VovaRodger/Robo/Научно-исследовательская часть/робот3.jpg

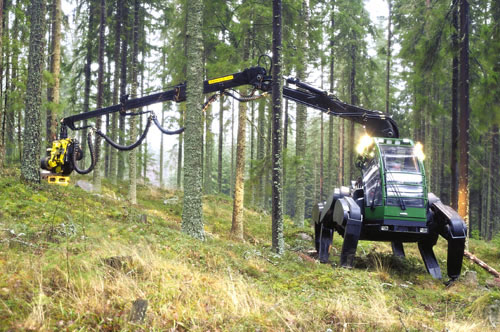
Научно-исследовательская часть/робот3.jpg
