VovaRodger/Robo/Научно-исследовательская часть/робот5.jpg

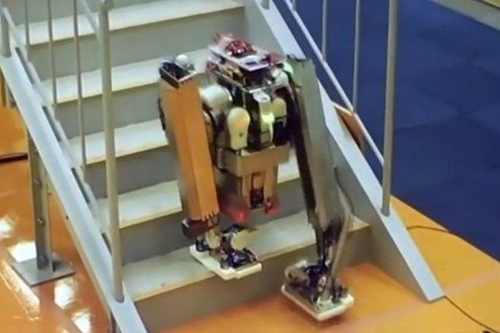
Научно-исследовательская часть/робот5.jpg
