VovaRodger/Robo/Научно-исследовательская часть/!Научно-исследовательская часть.docx

# Введение

В настоящее время практически во всех промышленно развитых странах интенсивно ведутся работы по созданию и исследованию шагающих роботов. Это вызвано тем, что шагающие машины (см. рис. 1) по сравнению с традиционными колёсными и гусеничными машинами имеют ряд преимуществ перед традиционными транспортными средствами при движении по поверхности со сложным рельефом, такими как пресечённая местность, завалы, а также внутри зданий и сооружений, где необходимо перемещаться по лестницам и узким коридорам и шахтам.


а. | б.


в. | г.

Рис. 1. Шагающие машины в разных областях.

В случаях, когда желательно или необходимо, чтобы след от опор целевой мобильной платформы имел дискретный характер, достойную замену шагающей машине найти невозможно. Шагающий аппарат при движении использует для опоры лишь некоторые точки на поверхности в отличие от колесных и гусеничных машин, имеющих непрерывную колею. Кроме того, шагающий аппарат существенно меньше повреждает почвенный покров, что может оказаться важным для некоторых районов.

Хотя колесные транспортные средства в настоящее время явно преобладают, известно, что при ходьбе по неподготовленной поверхности существенные преимущества имеют шагающие системы передвижения. Однако указанные преимущества шагающего аппарата определяют его высокую сложность. Система управления должна обеспечить переработку информации о местности, принятие решений о характере движения, контроль за их реализацией. Именно создание системы управления аппаратом – центральная проблема шагающего робота, так как опыт создания даже самых сложных систем автоматического управления невозможно непосредственно использовать для построения системы управления шагающим роботом.

# 1. Техническое задание

1. Произвести энергетический расчет трехзвенного манипулятора с 3-мя степенями свободы для шестиногого робота. Рассчитать и подобрать двигатели для каждого звена ноги.
2. Произвести частотный синтез и коррекцию следящего привода трехзвенного манипулятора с 3-мя степенями свободы для обеспечения следующих характеристик:
- Длительность переходного процесса t_(пп) ≤0.1 сек;
- Перерегулирование σ≤30% ;
- Ошибка вращения элемента ε≤0.5° ;
3. Решить обратную кинематическую задачу (ОКЗ) для трехзвенного манипулятора с 3-мя степенями свободы.
4. Проанализировать алгоритмы поиска кратчайшего пути.
5. Реализовать прохождение кратчайшего пути по заданной карте местности.
6. Провести натурный эксперимент и определить ошибки в прохождении заданной траектории.
7. Разработать плату стабилизации напряжения.
8. Разработать технологический процесс сборки ноги шестиногого шагающего робота.
9. Рассчитать затраты на проектирование и изготовление шестиногого шагающего робота.
10. Проанализировать опасные и вредные факторы при разработке системы управления шестиногим шагающим роботом.
11. Устранить самый опасный фактор, влияющий на персонал, при разработке системы управления шестиногим шагающим роботом.
12. Проанализировать влияние на окружающую среду технологического процесса сборки печатной платы для системы управления шестиногим шагающим роботом.
13. Устранить самый опасный фактор, влияющий на окружающую среду, при сборке печатной платы для системы управления шестиногим шагающим роботом.

# 2. Научно-исследовательская часть

Проанализируем преимущества и недостатки шагающих роботов и поставим задачи, которые необходимо решить в рамках данного дипломного проекта.

Как было описано во введении, шагающие роботы, по сравнению с колесными и гусеничными машинами, имеют ряд очевидных преимуществ и недостатков.

Из преимуществ выделим:

- система имеет дискретные точки опоры;
- маневренность в узких пространствах;
- проходимость;

Из недостатков:

- малые скорости перемещения;
- присутствие энергозатрат на удержание в горизонтальной плоскости;
- сложность реализации движения;

Имея шесть ног, перемещение в пространстве можно осуществлять с помощью нескольких вариантов волновых (периодических) походок, основным отличием которых является число ног в фазе опоры/переноса. Самой простой для понимания и реализации является походка «трешками», при которой в фазе опоры всегда находятся три ноги, а три другие в фазе переноса.

Так как создание системы управления роботом – это центральная проблема шагающего робота, решим эту проблему, реализовав походку «трешками». А так же решим проблему перемещения – а именно поиск кратчайшего пути по заданной карте местности с помощью волнового алгоритма Ли.

Для реализации поставленной задачи был выбран робот, представленный на рисунке 2.1.


Рис. 2.1. Шестиногий шагающий робот

Выбранный робот сделан из легкого акрилового стекла, оснащён ультразвуковым дальномером, девятнадцатью сервоприводами (18 на конечностях и один на ультразвуковом дальномере), полностью готовой к работе плате Servator32, основанной на Arduino.

# 2.1. Энергетический расчет следящего привода

Энергетический расчет будем проводить для одной ноги (см. рис. 2.2), приняв следующие ограничения и допущения:

- Ногу робота примем за 3х-звенный манипулятор с 3-мя степенями свободы;
- Нагрузкой является каркас (тело робота, к которому крепятся ноги), масса которого сосредоточена в точке и закреплена на конце манипулятора;
- Расчет будем вести от последнего звена, установленного на землю;
- Допускаем, что робот стоит абсолютно жестко, и не проскальзывает в точке контакта ноги с поверхностью опоры;
- Рассматриваем наихудший вариант, т.е. когда нога абсолютно выпрямлена. В этом случае на сочленения действуют самые большие силы и моменты;


Рис. 2.2. Чертеж ноги робота

Расчет моментов инерции звеньев, приведенных к оси вращения.

Твёрдый параллелепипед с высотой h, шириной a, глубиной b (см. рис. 2.3 и рис. 2.4) и массой m имеет следующие осевые моменты инерции, приведенные к центру одной из граней:

I_h =1/12∙m∙(a^2 +b^2 )

I_a =1/12∙m∙(h^2 +b^2 )

I_b =1/12∙m∙(a^2 +h^2 )

Теорема Гюйгенса — Штейнера [4].

Момент инерции твёрдого тела относительно какой-либо оси зависит от массы, формы и размеров тела, а также и от положения тела по отношению к этой оси. Согласно теореме Штейнера (теореме Гюйгенса-Штейнера), момент инерции тела I относительно произвольной оси равен сумме момента инерции этого тела I_c относительно оси, проходящей через центр масс тела параллельно рассматриваемой оси, и произведения массы тела m на квадрат расстояния d между осями:

I=I_c +m∙d^2 ,

где m — полная масса тела.

Момент инерции плеча (см. рис. 2.3)

I=I_h +m∙d^2


Рис. 2.3. Схема момента инерции плеча

Момент инерции предплечья и кисти (см. рис. 2.4)

I=I_а +m∙d^2


Рис. 2.4. Схема моментов инерции предплечья и кисти

№ | m_i , кг | a,мм | b,мм | d,мм | h,мм
1 | 0.030 | 50 | 45 | 10 | 35
2 | 0.030 | 30 | 70 | 25 | 17
3 | 0.030 | 53 | 60 | 27 | 10

Табл. 2.1. Начальные условия для расчетов

Начальные условия для расчетов приведены в таблице 2.1.

Расчет момента инерции для плеча:

I_h =1/12∙m_1 ∙(a^2 +b^2 )

I=I_h +m_1 ∙d^2 =1/12∙m_1 ∙(a^2 +b^2 )+ m_1 ∙d^2 =

1/12∙0.03∙(0.05^2 +0.045^2 )+0.03∙0.01^2 =2.385∙10^(-5) кг∙м^2

Расчет момента инерции для предплечья:

I_a =1/12∙m_2 ∙(h^2 +b^2 )

I=I_a +m_2 ∙d^2 =1/12∙m_2 ∙(h^2 +b^2 )+m_2 ∙d^2 =

1/12∙0.03∙(0.017^2 +0.07^2 )+0.03∙0.025^2 =5.287∙10^(-5) кг∙м^2

Расчет момента инерции для кисти:

I_a =1/12∙m_3 ∙(h^2 +b^2 )

I=I_a +m_3 ∙d^2 =1/12∙m_3 ∙(h^2 +b^2 )+m_3 ∙d^2 =

1/12∙0.03∙(0.01^2 +0.06^2 )+0.03∙0.027^2 =5.187∙10^(-5) кг∙м^2

Полученные данные сведены в таблицу 2.2.

№ | Привод | m_i , кг | l_i ,м | ρ_i , м | J_i ∙10^(-5) , кг∙м^2 | φ_(Pi) , рад/с | φ_(Pi) , рад/с^2 | ∆,мм | m, кг
1 | Плеча | 0.030 | 0.026 | 0.013 | 2.385 | 2.5 | 5.0 | 0 | 0,125
2 | Локтя | 0.030 | 0.050 | 0.025 | 5.287 | 2.5 | 5.0 | 0 | 0,125
3 | Кисти | 0.030 | 0.054 | 0.027 | 5.187 | 2.5 | 5.0 | 0 | 0,125

Табл. 2.2. Начальные условия для расчетов

Используемые обозначения в таблице 2.2:

m_1 m_2 , m_3 , кг- массы звеньев;

l_1 ,l_2 ,l_3 ,м- длины звеньев;

ρ_1 ,ρ_2 ,ρ_3 , м- радиусы инерции звеньев ( ρ_i =(l_i)/2 );

J_1 ,J_2 ,J_3 , кг∙м^2 - моменты инерции звеньев, приведенные к осям вращения;

φ_P ,(рад)/с; φ_P ,(рад)/(с^2) – рабочие угловые скорости и ускорения звеньев;

∆,мм- максимально допустимая ошибка копирования;

m, кг - масса груза (объекта манипулирования; в роли объекта выступает платформа гексапода);

Энергетический расчет ЭМП плеча в I приближении.

Расчет Jп MAX Mп MAX

J_(п MAX) =m∙l_1 ^2 +J_1 +m_1 ∙ρ_1 ^2 =

=0.125∙0.026^2 +2.385∙10^(-5) +0.03∙0.013^2 =0.113∙10^(-3) кг∙м^2

M_(п MAX) =m∙g∙l_1 +m_1 ∙g∙ρ_1 =

=0.125∙9.806∙0.026+0.03∙9.806∙0.013=0.036 Н∙м

Расчет механической части ЭМП с объектом управления (ОУ)

Требуемые скорости и ускорения:

φ_(pп) =2.5(рад)/с;φ_(pп) =5(рад)/(с^2)

Расчет наибольшего значения требуемого момента на валу ОУ

М_Т =J_(п MAX) ∙φ_(pп) +M_(п MAX) =

=0.113∙10^(-3) ∙5+0.036 =0.037 Н∙м

Расчет эквивалентной скорости движения ОУ

Примем предварительно τ_(Ωд) =0.05 с

Ω_Э =τ_(Ωд) φ_(pк) +φ_(pк) =0.05с∙5+2.5=2.75(рад)/с

Расчет граничного значения максимальной требуемой мощности

Для данного расчета зададимся значениями КПД редуктора прямого и обратного хода: η_(пх) =η_(ох) =0.8

P_m =(Ω_Э ∙М_Т)/(η_(пх))=(2.75∙0.037)/0.8=0.127 Вт

Расчет ориентировочного значения требуемой номинальной мощности двигателя кисти

Для расчета ориентировочного значения требуемой номинальной мощности двигателя кисти необходимо определить теоретическую кратность пускового момента. Для этого достаточно принять P_(max) =P_m =0.127 Вт

Так номинальную мощность двигателя получим из соображений:

P_(ДН) ={, (P_(max))/2.5=0.051 Вт, для двигателей с жесткой , механической характеристикой λ_(КД) =8..14;, (P_(max))/1.5=0.085 Вт, для двигателей с мягкой , механической характеристикой λ_(КД) =2..7.

λ_(КД) - коэффициент кратности пускового момента двигателя.

P_(ДН1) =0.051 Вт; P_(ДН2) =0.085 Вт

Выбор двигателя по номинальной мощности с учетом жесткости механической характеристики из таблиц ДПТ

Выбираем по результатам расчетов I приближения ДПТ TowerPro SG92R (см. табл. 2.3)

U_(дн) , В | P_н ,Вт | n_н , об/мин | R_Я ,Ом | i_(дв н) ,А | J_p ∙ 10^(-6) , кг∙м^2 | m_(дв) , кг | λ_(КД)
6±1 | 0.675 | 600 | 13 | 0.250 | 0.575 | 0.009 | 11

Табл. 2.3. Технические характеристики TowerPro SG92R

P_н =0.675 Вт >0.051 Вт= P_(ДН1) , по мощности двигатель выбран верно

Выполним пересчет параметров для выбранного двигателя.

Номинальная угловая скорость: Ω_(ДН) =(π∙n_н)/30=(3.142∙600)/30=62.84(рад)/с

Номинальный момент двигателя:

М_(дв н) =(P_н)/(Ω_(ДН))=0.675/62.84=1.074∙10 ^(-2) Н∙м

Коэффициент момента K_М =(М_(дв н))/(i_(д н))=(1.074∙10 ^(-2))/0.25=4.296∙10 ^(-2) Н∙м / А

Коэффициент противо ЭДС K_Ω =(U_(дн) -R_Я i_(дв н))/(Ω_(ДН))=(6-13∙0.25)/62.84=4.376∙10 ^(-2) (В∙с)/(рад)

Выбор усилителя мощности (УМ), расчет его внутреннего сопротивления, вычисление сопротивления якорной цепи УМ-двигатель

R_д =R_(УМ) +R_Я , где

R_д - действующее сопротивление цепи УМ – ЭД, Ом;

R_(УМ) - выходное сопротивление усилителя мощности, Ом;

R_Я - сопротивление обмотки якоря, Ом.

Выбираем транзисторный УМ ( R_(УМ) =0;R_д =R_Я ). Необходимо назначить коэффициенты форсирования (КФ)

В силу естественного насыщения УМ по выходному напряжению, ЭД присуще ограничение по управляющему напряжению (скорости вращения):

U_(max) =λ_(СК М) ∙U_(дн) , где

λ_(СК М) - максимальный КФ по напряжению (для транзисторных УМ λ_(СК М) =1 )

Для получения запаса по управляющему напряжению в расчет принимается допустимое значение управляющего напряжения U_(Яд) :

λ_(СК) <λ_(СК М) ; λ_(СК) =0.9-КФ в рабочем режиме

U_(Яд) =λ_(СК) ∙U_(дн) =0.9∙6 В=5.4 В

Для ЭД характерно естественное насыщение по электромагнитному моменту:

М_(дв max) =λ_(ММ) ∙М_(дв н) , где

λ_(ММ) - максимальный КФ по моменту (току) (назначаем λ_(ММ) =4 )

М_(дв max) =4∙1.074∙10 ^(-2) =4.296∙10 ^(-2) Н∙м

Допустимый момент двигателя:

М_(дд) =λ_М ∙М_(дв н) , где

λ_М - КФ двигателя в рабочем режиме (назначаем λ_М =2 )

М_(дд) =λ_М ∙М_(дв н) =2∙1.074∙10 ^(-2) =2.148∙10 ^(-2) Н∙м

Расчет передаточного отношения редуктора в первом приближении

i=(λ_(СК) Ω_(ДН))/α=(0.9∙62.84)/2.5=22.622≅23

Требуемый момент на валу двигателя:

М'_Т =(М_Т)/(i∙η)=0.037/(23∙0.8)=2.011∙10 ^(-3) Н∙м

Требуемый момент, при котором обеспечивается заданное движение ОУ:

М_(ТД) =J_p iφ_(pк) +М^(') _Т =0.575∙10^(-6) ∙23∙5+2.011∙10 ^(-3) =

=2.077∙10^(-3) Н∙м

М_(ТД) =2.077∙10^(-3) Н∙м < 2.148∙10 ^(-2) Н∙м = М_(дд) ,

двигатель данному критерию удовлетворяет

Требуемая скорость вращения вала ЭД:

Ω_(ТД) =i∙φ_P =23∙2.5=57.7(рад)/с<62.84(рад)/с=Ω_(ДН) ,

двигатель данному критерию удовлетворяет

Требуемое напряжение цепи якоря ЭД:

U_(ЯТ) =(R_Я)/(K_М)М_(ТД) +K_Ω Ω_(ТД) =

=13/(4.296∙10 ^(-2))∙2.077∙10^(-3) +4.376∙10 ^(-2) ∙57.7=5.153 В

Масса звена (плеча) m_п =m_(дв) =0.009 кг

Энергетический расчет ЭМП локтя в I приближении

Расчет JЛ MAX ; MЛ MAX

J_(Л MAX) =m∙(l_2 +l_1 )^2 +J_1 +m_1 ∙(l_2 +ρ_1 )^2 +m_п ∙l_2 ^2 + J_2 +m_2 ∙ρ_2 ^2 =

=0.125∙(0.05+0.026)^2 +2.385∙10^(-5) +0.03∙(0.05+0.013)^2 +

0.009∙0.05^2 + 5.287∙10^(-5) +0.03∙0.025^2 =0.959∙10^(-3) кг∙м^2

M_(Л MAX) =m∙g∙(l_2 +l_1 )+m_1 ∙g∙(l_2 +ρ_1 )+m_п ∙g∙l_2 +m_2 ∙g∙ρ_2 =

=0.125∙9.806∙(0.05+0.026)+0.03∙9.806∙(0.05+0.013)+

0.009∙9.806∙0.05+0.03∙9.806∙0.025=0.124 Н∙м

Расчет механической части ЭМП с ОУ

Требуемые скорости и ускорения:

φ_(pл) =2.5 (рад)/с;φ_(pл) =5 (рад)/(с^2)

Расчет наибольшего значения требуемого момента на валу ОУ

М_Т =J_(Л MAX) ∙φ_(pк) +M_(Л MAX) =

=0.959∙10^(-3) ∙5+0.124=0.129 Н∙м

Расчет эквивалентной скорости движения ОУ

Примем предварительно τ_(Ωд) =0.05 с

Ω_Э =τ_(Ωд) φ_(pл) +φ_(pл) =0.05∙5+2,5=2.75(рад)/с

Расчет граничного значения максимальной требуемой мощности

Для данного расчета зададимся значениями КПД редуктора прямого и обратного хода: η_(пх) =η_(ох) =0.8

P_m =(Ω_Э ∙М_Т)/(η_(пх))=(2.75∙0.129)/0.8=0.443 Вт

Расчет ориентировочного значения требуемой номинальной мощности двигателя кисти

Для расчета ориентировочного значения требуемой номинальной мощности двигателя кисти необходимо определить теоретическую кратность пускового момента. Для этого достаточно принять P_(max) =P_m =0.443 Вт

Так номинальную мощность двигателя получим из соображений:

P_(ДН) ={, (P_(max))/2.5=0.177 Вт, для двигателей с жесткой , механической характеристикой λ_(КД) =8..14;, (P_(max))/1.5=0.295 Вт, для двигателей с мягкой , механической характеристикой λ_(КД) =2..7.

λ_(КД) - коэффициент кратности пускового момента двигателя.

P_(ДН1) =0.177 Вт; P_(ДН2) =0.295 Вт

Выбор двигателя по номинальной мощности с учетом жесткости механической характеристики из таблиц ДПТ

Выбираем по результатам расчетов I приближения ДПТ TowerPro SG92R (см. табл. 2.3)

P_н =0.675 Вт >0.177 Вт= P_(ДН1) , по мощности двигатель выбран верно

Выполним пересчет параметров для выбранного двигателя.

Номинальная угловая скорость: Ω_(ДН) =(π∙n_н)/30=(3.142∙600)/30=62.84(рад)/с

Номинальный момент двигателя:

М_(дв н) =(P_н)/(Ω_(ДН))=0.675/62.84=1.074∙10 ^(-2) Н∙м

Коэффициент момента K_М =(М_(дв н))/(i_(д н))=(1.074∙10 ^(-2))/0.25=4.296∙10 ^(-2) Н∙м / А

Коэффициент противоЭДС K_Ω =(U_(дн) -R_Я i_(дв н))/(Ω_(ДН))=(6-13∙0.25)/62.84=4.376∙10 ^(-2) (В∙с)/(рад)

Выбор усилителя мощности (УМ), расчет его внутреннего сопротивления, вычисление сопротивления якорной цепи УМ-двигатель

R_д =R_(УМ) +R_Я , где

R_д - действующее сопротивление цепи УМ – ЭД, Ом;

R_(УМ) - выходное сопротивление усилителя мощности, Ом;

R_Я - сопротивление обмотки якоря, Ом.

Выбираем транзисторный УМ ( R_(УМ) =0;R_д =R_Я ). Необходимо назначить коэффициенты форсирования (КФ)

В силу естественного насыщения УМ по выходному напряжению, ЭД присуще ограничение по управляющему напряжению (скорости вращения):

U_(max) =λ_(СК М) ∙U_(дн) , где

λ_(СК М) - максимальный КФ по напряжению (для транзисторных УМ λ_(СК М) =1 )

Для получения запаса по управляющему напряжению в расчет принимается допустимое значение управляющего напряжения U_(Яд) :

λ_(СК) <λ_(СК М) ; λ_(СК) =0.9-КФ в рабочем режиме

U_(Яд) =λ_(СК) ∙U_(дн) =0.9∙6 В=5.4 В

Для ЭД характерно естественное насыщение по электромагнитному моменту:

М_(дв max) =λ_(ММ) ∙М_(дв н) , где

λ_(ММ) - максимальный КФ по моменту (току) (назначаем λ_(ММ) =4 )

М_(дв max) =4∙1.074∙10 ^(-2) =4.296∙10 ^(-2) Н∙м

Допустимый момент двигателя:

М_(дд) =λ_М ∙М_(дв н) , где

λ_М - КФ двигателя в рабочем режиме (назначаем λ_М =2 )

М_(дд) =λ_М ∙М_(дв н) =2∙1.074∙10 ^(-2) =2.148∙10 ^(-2) Н∙м

Расчет передаточного отношения редуктора в первом приближении

i=(λ_(СК) Ω_(ДН))/α=(0.9∙62.84)/2.5=22.622≅23

Требуемый момент на валу двигателя:

М'_Т =(М_Т)/(i∙η)=0.129/(23∙0.8)=4.487∙10 ^(-3) Н∙м

Требуемый момент, при котором обеспечивается заданное движение ОУ:

М_(ТД) =J_p iφ_(pк) +М^(') _Т =0.575∙10^(-6) ∙23∙5+4.487∙10 ^(-3) =

=4.553∙10^(-3) Н∙м

М_(ТД) =4.553∙10^(-3) Н∙м < 2.148∙10 ^(-2) Н∙м = М_(дд) ,

двигатель данному критерию удовлетворяет

Требуемая скорость вращения вала ЭД:

Ω_(ТД) =i∙φ_P =23∙2.5=57.7(рад)/с<62.84(рад)/с=Ω_(ДН) ,

двигатель данному критерию удовлетворяет

Требуемое напряжение цепи якоря ЭД:

U_(ЯТ) =(R_Я)/(K_М)М_(ТД) +K_Ω Ω_(ТД) =

=13/(4.296∙10 ^(-2))∙4.553∙10^(-3) +4.376∙10 ^(-2) ∙57.7=5.303 В

Масса звена (локтя) m_л =m_(дв) =0.009 кг

Энергетический расчет ЭМП кисти в I приближении

Расчет Jк MAX ; Mк MAX

J_(к MAX) =m∙(l_3 +l_2 +l_1 )^2 +J_1 +m_1 ∙(l_3 +l_2 +ρ_1 )^2 +

m_п ∙[l_3 +l_2 ]^2 +J_2 +m_2 ∙(l_3 +ρ_2 )^2 +m_л ∙l_3 ^2 +J_3 +m_3 ∙ρ_3 ^2 =
0.125∙(0.054+0.050+0.026)^2 +2.385∙10^(-5) +

0.03∙(0.054+0.050+0.013)^2 +0.009∙[0.054+0.050]^2 +

5.287∙10^(-5) +0.03∙(0.054+0.025)^2 +0.009∙0.054^2 +5.187∙10^(-5) +

0.03∙0.027^2 =2.985∙10^(-3) кг∙м^2

M_(к MAX) =m∙g∙(l_3 +l_2 +l_1 )+m_1 ∙g∙(l_3 +l_2 +ρ_1 )+m_п ∙g∙(l_3 +l_2 )+

m_2 ∙g∙[l_3 +ρ_2 ]+m_л ∙g∙l_3 +m_3 ∙g∙ρ_3 =

0.125∙9.806∙(0.054+0.050+0.026)+0.03∙9.806∙

(0.054+0.050+0.013)+0.009∙9.806∙(0.054+0.050)+

0.03∙9.806∙[0.054+0.025]+0.009∙9.806∙0.054+

0.03∙9.806∙0.027= 0.239 Н ∙м

Расчет механической части ЭМП с ОУ

Требуемые скорости и ускорения:

φ_(pк) =2.5 (рад)/с;φ_(pк) =5 (рад)/(с^2)

Расчет наибольшего значения требуемого момента на валу ОУ

М_Т =J_(к MAX) ∙φ_(pк) +M_(к MAX) =

=2.985∙10^(-3) ∙5 +0.239=0.254 Н∙м

Расчет эквивалентной скорости движения ОУ

Примем предварительно τ_(Ωд) =0.05 с

Ω_Э =τ_(Ωд) φ_(pл) +φ_(pл) =0.05∙5+2,5=2.75(рад)/с

Расчет граничного значения максимальной требуемой мощности

Для данного расчета зададимся значениями КПД редуктора прямого и обратного хода: η_(пх) =η_(ох) =0.8

P_m =(Ω_Э ∙М_Т)/(η_(пх))=(2.75∙0.254)/0.8=0.873Вт

Расчет ориентировочного значения требуемой номинальной мощности двигателя кисти

Для расчета ориентировочного значения требуемой номинальной мощности двигателя кисти необходимо определить теоретическую кратность пускового момента. Для этого достаточно принять P_(max) =P_m =0.873 Вт

Так номинальную мощность двигателя получим из соображений:

P_(ДН) ={, (P_(max))/2.5=0.349 Вт, для двигателей с жесткой , механической характеристикой λ_(КД) =8..14;, (P_(max))/1.5=0.582 Вт, для двигателей с мягкой , механической характеристикой λ_(КД) =2..7.

λ_(КД) - коэффициент кратности пускового момента двигателя.

P_(ДН1) =0.349 Вт; P_(ДН2) =0.582 Вт

Выбор двигателя по номинальной мощности с учетом жесткости механической характеристики из таблиц ДПТ

Выбираем по результатам расчетов I приближения ДПТ TowerPro SG92R (см. табл. 2.3)

P_н =0.675 Вт >0.349 Вт= P_(ДН1) , по мощности двигатель выбран верно

Выполним пересчет параметров для выбранного двигателя.

Номинальная угловая скорость: Ω_(ДН) =(π∙n_н)/30=(3.142∙600)/30=62.84(рад)/с

Номинальный момент двигателя:

М_(дв н) =(P_н)/(Ω_(ДН))=0.675/62.84=1.074∙10 ^(-2) Н∙м

Коэффициент момента K_М =(М_(дв н))/(i_(д н))=(1.074∙10 ^(-2))/0.25=4.296∙10 ^(-2) Н∙м / А

Коэффициент противоЭДС K_Ω =(U_(дн) -R_Я i_(дв н))/(Ω_(ДН))=(6-13∙0.25)/62.84=4.376∙10 ^(-2) (В∙с)/(рад)

Выбор усилителя мощности (УМ), расчет его внутреннего сопротивления, вычисление сопротивления якорной цепи УМ-двигатель

R_д =R_(УМ) +R_Я , где

R_д - действующее сопротивление цепи УМ – ЭД, Ом;

R_(УМ) - выходное сопротивление усилителя мощности, Ом;

R_Я - сопротивление обмотки якоря, Ом.

Выбираем транзисторный УМ ( R_(УМ) =0;R_д =R_Я ). Необходимо назначить коэффициенты форсирования (КФ)

В силу естественного насыщения УМ по выходному напряжению, ЭД присуще ограничение по управляющему напряжению (скорости вращения):

U_(max) =λ_(СК М) ∙U_(дн) , где

λ_(СК М) - максимальный КФ по напряжению (для транзисторных УМ λ_(СК М) =1 )

Для получения запаса по управляющему напряжению в расчет принимается допустимое значение управляющего напряжения U_(Яд) :

λ_(СК) <λ_(СК М) ; λ_(СК) =0.9-КФ в рабочем режиме

U_(Яд) =λ_(СК) ∙U_(дн) =0.9∙6 В=5.4 В

Для ЭД характерно естественное насыщение по электромагнитному моменту:

М_(дв max) =λ_(ММ) ∙М_(дв н) , где

λ_(ММ) - максимальный КФ по моменту (току) (назначаем λ_(ММ) =4 )

М_(дв max) =4∙1.074∙10 ^(-2) =4.296∙10 ^(-2) Н∙м

Допустимый момент двигателя:

М_(дд) =λ_М ∙М_(дв н) , где

λ_М - КФ двигателя в рабочем режиме (назначаем λ_М =2 )

М_(дд) =λ_М ∙М_(дв н) =2∙1.074∙10 ^(-2) =2.148∙10 ^(-2) Н∙м

Расчет передаточного отношения редуктора в первом приближении

i=(λ_(СК) Ω_(ДН))/α=(0.9∙62.84)/2.5=22.622≅23

Требуемый момент на валу двигателя:

М'_Т =(М_Т)/(i∙η)=0.254/(23∙0.8)=1.380∙10 ^(-2) Н∙м

Требуемый момент, при котором обеспечивается заданное движение ОУ:

М_(ТД) =J_p iφ_(pк) +М^(') _Т =0.575∙10^(-6) ∙23∙5+1.380∙10 ^(-2) =

=1.387∙10^(-2) Н∙м

М_(ТД) =1.387∙10^(-2) Н∙м < 2.148∙10 ^(-2) Н∙м = М_(дд) ,

двигатель данному критерию удовлетворяет

Требуемая скорость вращения вала ЭД:

Ω_(ТД) =i∙φ_P =23∙2.5=57.7(рад)/с<62.84(рад)/с=Ω_(ДН) ,

двигатель данному критерию удовлетворяет

Требуемое напряжение цепи якоря ЭД:

U_(ЯТ) =(R_Я)/(K_М)М_(ТД) +K_Ω Ω_(ТД) =

=13/(4.296∙10 ^(-2))∙1.387∙10^(-2) +4.376∙10 ^(-2) ∙57.7=5.522 В

Масса звена (кисти) m_к =m_(дв) =0.009 кг

# 2.2. Синтез следящего привода кисти робота

Необходимо синтезировать следящий привод и при этом обеспечить условия, заданные в техническом задании.

Требуется обеспечить:

- Длительность переходного процесса t_(пп) ≤0.1 сек;
- Перерегулирование σ≤30% ;
- Ошибка вращения элемента ε≤0.5° ;

Расчет будем вести для самого нагруженного привода, т.е. привода кисти. Силовая часть привода состоит из усилителя мощности, двигателя постоянного тока, редуктора и датчика обратной связи.

Система автоматического регулирования должна обеспечить воспроизведение управляющего воздействия φ(t)=φ_p sinω_p t , для которого заданы требуемые скорости и ускорения: φ_p =2.5 (рад)/с;φ_p =5 (рад)/(с^2)

Исходные данные двигателя TowerPro SG92R представлены в табл. 2.4.

U_(дн) , В | P_н ,Вт | n_н , об/мин | R_Я ,Ом | i_(дв н) ,А | J_p ∙ 10^(-6) , кг∙м^2 | m_(дв) , кг | λ_(КД)
6±1 | 0.675 | 600 | 13 | 0.250 | 0.575 | 0.009 | 11

Табл. 2.4. Технические характеристики TowerPro SG92R.

Передаточное отношение редуктора: i=23

Параметры нагрузки: J_(к MAX) =2.985∙10^(-3) кг∙м^2 ;l_1 =0.054 м

Передаточная функция двигателя постоянного тока (ДПТ) [9] имеет следующий вид:

W_α (s)=(1/(K_ω))/(s(T_(ЭМ) T_Э s^2 +T_(ЭМ) s+1))≅(K_(ДВ))/(s(T_(ЭМ) s+1)(T_Э s+1))

K_М =4.296∙10 ^(-2) Н∙м / А

K_ω =4.376∙10 ^(-2) (В∙с)/(рад)

R_Я =13 Ом

K_(ДВ) =1/(K_ω)=1/(4.376∙10 ^(-2))=22.852 (рад)/(В∙с)

J_Σ =J_p +(J_(к MAX))/(i^2)=0.575∙10^(-6) +(2.985∙10^(-3))/(23^2)≅6.218∙10^(-6) кг∙м^2

T_(ЭМ) =(J_Σ R_Я)/(K_М K_ω)=(6.218∙10^(-6) ∙13)/(4.296∙10 ^(-2) ∙4.376∙10 ^(-2))=0.043 c

T_Э =(T_(ЭМ))/10=0.043/10=0.0043 c

Таким образом, мы получаем следующую передаточную функцию неизменяемой части:

W_α (s)=22.852/(s(0.0043s+1)(0.043s+1))

Имея передаточную функцию, строим ЛАЧХ функции неизменяемой части (см. рис. 2.5).

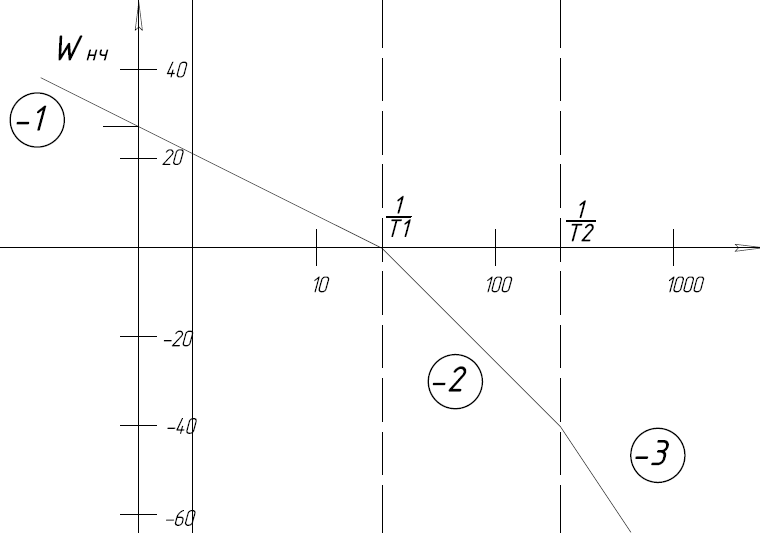
[picture p63: figure]

Рис. 2.5. ЛАЧХ неизменяемой части

Исходя из ЛАЧХ (см. рис. 2.5) видим, что необходимо провести коррекцию, чтобы обеспечивались условия, описанные в техническом задании, для этого проведем коррекцию системы.

Введем последовательное корректирующее устройство вида

W(p)=K_1 (T_(к1) s+1)/(T_(к2) s+1)

Нам необходимо определить неизвестные K_1 , T_1 и T_2 . Исходя из того, что мы знаем t_(пп) =0.05 сек и σ=20% , по номограммам Солодовникова найдем минимальное значение частоты среза.

ω_с =150 1/с

Коэффициент усиления зададим

K_1 =10

Имея эти данные, построим желаемую ЛАЧХ и получим T_(к1) =0.0282 и T_(к2) =0.0011 .

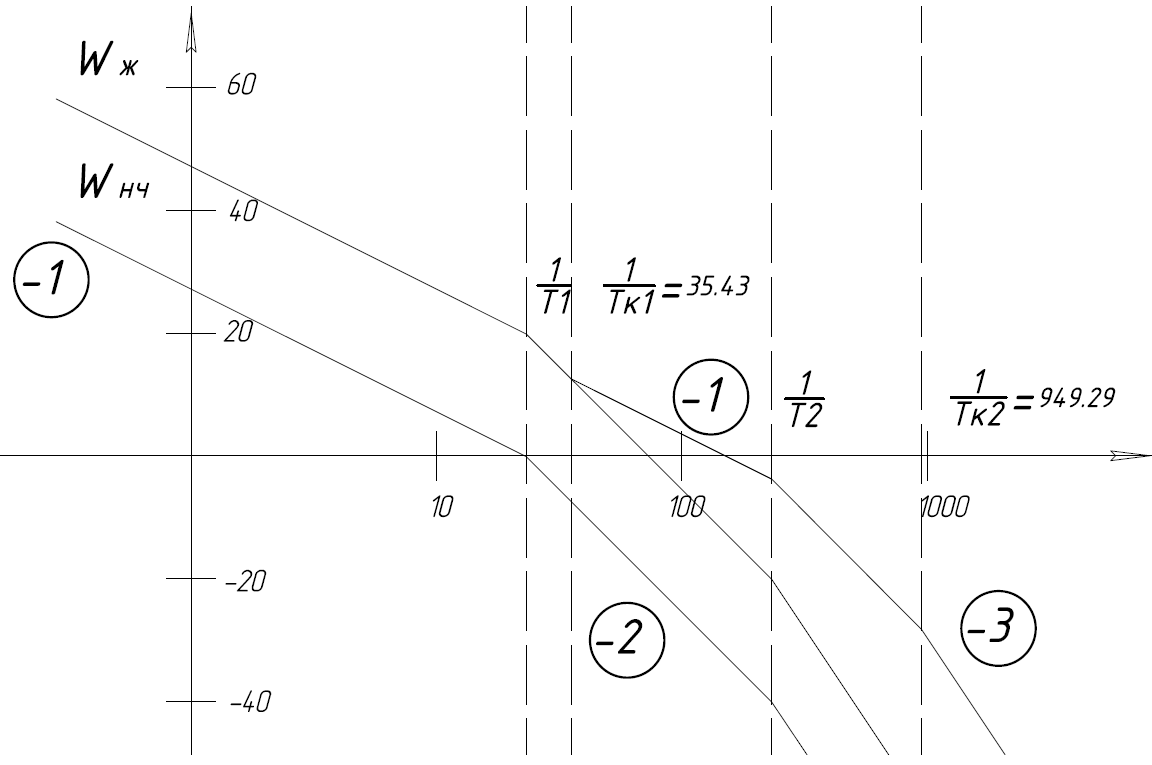
[picture p64: figure]

Рис. 2.6. ЛАЧХ неизменяемой и желаемой частей

Для нахождения точных запасов устойчивости, времени переходного процесса, перерегулирования и ошибки смоделируем систему на компьютере.

# 2.3. Моделирование синтезированного следящего привода

После того как мы провели синтез нашей системы, нам необходимо провести моделирование. Моделирование будем проводить с помощью блоков в графической среде имитационного моделирования Simulink, встроенной в среду MATLAB. Для этого мы собираем структурную схему замкнутой системы с помощью блоков Gain, Transfer Function и Integrator (см. рис. 2.5).


Рис. 2.7. Структурная схема замкнутой системы

На рисунке 2.7 изображена структурная схема, на вход которой мы подаем синусоидальный сигнал, после чего смотрим график изменения ошибки (см. рис. 2.8), из которого видно, что ошибка составляет ε=0.007 рад= 0.4° .


Рис. 2.8. Ошибка замкнутой системы

Для нахождения запасов устойчивости, проведем линейный анализ разомкнутой системы. Получившиеся ЛАЧХ и ЛФЧХ с указанными запасами устойчивости представлены на рисунке 2.9.


Рис. 2.9. ЛАЧХ и ЛФЧХ разомкнутой системы

Для нахождения перерегулирования и времени переходного процесса построим график переходной функции для замкнутой системы (см. рис. 2.10).


Рис. 2.10. График переходной функции

Исходя из построенных графиков получаем следующие значения запасов устойчивости системы по фазе и по амплитуде, а так же времени переходного процесса и перерегулирование:

- Δφ=42,4 ° ;
- ΔA=15,2 дБ ;
- t_(пп) =0,06 сек;
- σ=28,8 % .

По результатам моделирования получаем, что система устойчива, все параметры соответствуют заданному техническому заданию, значит синтез и коррекция проведены верно.

# 2.4. Решение обратной задачи кинематики

Прямая задача кинематики (ПКЗ) состоит в том, чтобы по заданному вектору координат шарниров мобильного робота (МР) и известным параметрам его звеньев и сочленений найти положение и ориентацию рабочего органа в декартовом пространстве [2].

Обратная задача кинематики (ОКЗ) состоит в том, чтобы для заданного положения и ориентации рабочего органа МР в декартовом пространстве и известным параметрам его звеньев и сочленений определить координаты шарниров, обеспечивающие заданное положение [2].

Прямая задача кинематики всегда имеет единственное решение, обратная задача может не иметь решения, иметь одно или более решений.

Существуют различные методы решения ОКЗ: метод обратных преобразований, геометрический подход, итерационный метод на основе обращения матрицы-Якобиана МР и т.д. Будем использовать геометрический подход [1], который имеет ряд достоинств:

- решение в явном виде и за один проход;
- высокая вычислительная скорость и стабильность;
- однозначность (с учетом геометрической конфигурации);
- сохранение управляемости КМР в «кинематических» внутренних сингулярных точках;
- наглядность.

Недостатком же такого подхода является то, что полученный алгоритм применим только для одной кинематической схемы.

Относительно простое решение ОКЗ при данном подходе обеспечивается за счет того, что кинематические схемы большинства современных МР удовлетворяют одному из двух условий:

- Оси трех смежных шарниров пересекаются в одной точке;
- Оси трех смежных шарниров параллельны между собой.
- Исходными данными для алгоритма решения ОКЗ являются:
- Параметры звеньев и сочленений: длины звеньев, ориентация шарниров в начальном положении МР, минимальные и максимальные допустимые значения углов в шарнирах (постоянные параметры).
- Матрица поворота нулевой СК (СК0) в базовой СК (BASE).
- Знание геометрической конфигурации робота (для разрешения положений с несколькими решениями).
- Значения углов шарниров на предыдущем шаге.

Решение обратной задачи кинематики

За начальное положение (обобщенные координаты равны нулю) ноги примем вытянутое положение в горизонтальной плоскости, направленное из центра шестиугольника в котором находится базовая СК (см. рис. 2.11). Остальные СК расположим в сочленениях согласно правилам, описанным в конспекте лекций по курсу «ОСНОВЫ РОБОТОТЕХНИКИ» [1].

i | B | 0 | 1 | 2 | 3
α_i β_i γ_i | - | 0° 0° η_i -90° | 0° -90° 0° | 0° 0° 0° | -90° 0° 0°
l_i | - | - | |0l_1 0| | |0l_2 0| | |00l_3
l | - | - | l_1 =26мм | l_2 =50мм | l_3 =54мм

Табл. 2.5. Начальные условия для расчетов

В таблице 2.6 приведены углы поворота СК0 относительно базовой системы координат.

Номер ноги | 1 | 2 | 3 | 4 | 5 | 6
η_i | 130° | 180° | 230° | 50° | 0° | 310°

Табл. 2.6. Начальные условия для расчетов

Введенные обозначения

α_i ,β_i ,γ_i , °- углы поворота СК_i относительно СК_(i-1) вокруг осей X_(i-1) , Y_(i-1) , Z_(i-1) соответственно (см. рис. 2.12);

l_i - Длина звена i – вектор l_i , проведенный из начала СК_(i-1) к началу СК_i

(в исходном положении -го сочленения); вектор l_i задается в проекциях на оси СК_i : l_i = {l_(ix) l_(iy) l_(iz) }^T ;

η_i - углы поворота СК_0 относительно СК_B вокруг оси Z_B ;

l_1 ,l_2 ,l_3 - линейные длины звеньев (расстояния между осями вращений Z_i )

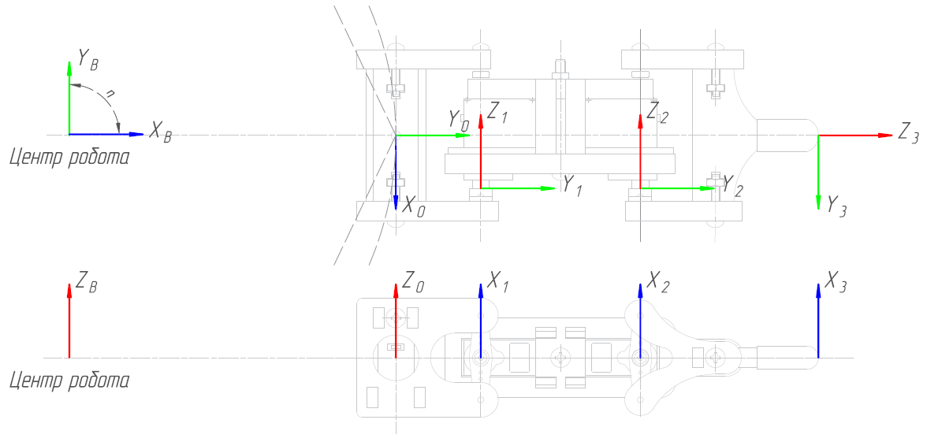
[picture p65: figure]

Рис. 2.11. Кинематическая расчетная схема


Рис. 2.12. Углы поворота α, β и γ СК_i относительно СК_(i-1)

Расчеты обратной задачи кинематики

Для решения ОКЗ требуется определить положение конца манипулятора в декартовом пространстве τ_(3 (0))^((0)) .

Из курса «ОСНОВЫ РОБОТОТЕХНИКИ» [1] имеем:

τ_(i (0))^((0)) = ∑_(j=1)^i τ_(0j) ∙l_j ;

τ_(3 (0))^((0)) = τ_01 ∙l_1 +τ_02 ∙l_2 +τ_03 ∙l_3 =τ_01 ∙(l_1 +τ_12 ∙(l_2 +τ_23 ∙l_3 )) ;

τ_(j-1,j) =τ_(z (Θ_j ))^T ∙ε_j^T ;

ε_j^T =τ_z (γ_j )∙ τ_y (β_j )∙τ_x (α_j ) ;

τ_x (α_j )=|1, 0, 00, cos(α_j ), -sin(α_j )0, sin(α_j ), cos(α_j )| ;

τ_y (β_j )=|cos(β_j ), 0, sin(β_j )0, 1, 0-sin(β_j ), 0, cos(β_j )| ;

τ_z (γ_j )= |cos(γ_j ), -sin(γ_j ), 0sin(γ_j ), cos(γ_j ), 00, 0, 1| ;

τ_(B0) =ε_0^T =(τ_z (γ_0 )∙ τ_y (β_0 )∙τ_x (α_0 ))^T =

=|cos(γ_0 ), -sin(γ_0 ), 0sin(γ_0 ), cos(γ_0 ), 00, 0, 1|∙|cos(β_0 ), 0, sin(β_0 )0, 1, 0-sin(β_0 ), 0, cos(β_0 )|∙

∙|1, 0, 00, cos(α_0 ), -sin(α_0 )0, sin(α_0 ), cos(α_0 )|=|cos(η_i -90°), -sin(η_i -90°), 0sin(η_i -90°), cos(η_i -90°), 00, 0, 1|∙

∙|1, 0, 00, 1, 00, 0, 1|∙|1, 0, 00, 1, 00, 0, 1|=|cos(η_i -90°), sin(η_i -90°), 0-sin(η_i -90°), cos(η_i -90°), 00, 0, 1| ;

ε_1 =τ_z (γ_1 )∙ τ_y (β_1 )∙τ_x (α_1 )=

=|cos(γ_1 ), -sin(γ_1 ), 0sin(γ_1 ), cos(γ_1 ), 00, 0, 1|∙|cos(β_1 ), 0, sin(β_1 )0, 1, 0-sin(β_1 ), 0, cos(β_1 )|∙

∙|1, 0, 00, cos(α_1 ), -sin(α_1 )0, sin(α_1 ), cos(α_1 )|=|1, 0, 00, 1, 00, 0, 1|∙|0, 0, -10, 1, 01, 0, 0|∙|1, 0, 00, 1, 00, 0, 1|=

=|0, 0, -10, 1, 01, 0, 0| ;

ε_2 =τ_z (γ_2 )∙ τ_y (β_2 )∙τ_x (α_2 )=

=|cos(γ_2 ), -sin(γ_2 ), 0sin(γ_2 ), cos(γ_2 ), 00, 0, 1|∙|cos(β_2 ), 0, sin(β_2 )0, 1, 0-sin(β_2 ), 0, cos(β_2 )|∙

∙|1, 0, 00, cos(α_2 ), -sin(α_2 )0, sin(α_2 ), cos(α_2 )|=|1, 0, 00, 1, 00, 0, 1|∙|1, 0, 00, 1, 00, 0, 1|∙|1, 0, 00, 1, 00, 0, 1|=

=|1, 0, 00, 1, 00, 0, 1| ;

ε_3 =τ_z (γ_3 )∙ τ_y (β_3 )∙τ_x (α_3 )=

=|cos(γ_3 ), -sin(γ_3 ), 0sin(γ_3 ), cos(γ_3 ), 00, 0, 1|∙|cos(β_3 ), 0, sin(β_3 )0, 1, 0-sin(β_3 ), 0, cos(β_3 )|∙

∙|1, 0, 00, cos(α_3 ), -sin(α_3 )0, sin(α_3 ), cos(α_3 )|=|1, 0, 00, 1, 00, 0, 1|∙|1, 0, 00, 1, 00, 0, 1|∙|1, 0, 00, 0, 10, -1, 0|=

=|1, 0, 00, 0, 10, -1, 0| ;

τ_(0,1) =τ_(z (Θ_1 ))^T ∙ε_1^T =|cos(Θ_1 ), sin(Θ_1 ), 0-sin(Θ_1 ), cos(Θ_1 ), 00, 0, 1|∙|0, 0, 10, 1, 0-1, 0, 0|=

=|0, sin(Θ_1 ), cos(Θ_1 )0, cos(Θ_1 ), -sin(Θ_1 )-1, 0, 0| ;

τ_(1,2) =τ_(z (Θ_2 ))^T ∙ε_2^T =|cos(Θ_2 ), sin(Θ_2 ), 0-sin(Θ_2 ), cos(Θ_2 ), 00, 0, 1|∙|1, 0, 00, 1, 00, 0, 1|=

=|cos(Θ_2 ), sin(Θ_2 ), 0-sin(Θ_2 ), cos(Θ_2 ), 00, 0, 1| ;

τ_(2,3) =τ_(z (Θ_33 ))^T ∙ε_3^T =|cos(Θ_3 ), sin(Θ_3 ), 0-sin(Θ_3 ), cos(Θ_3 ), 00, 0, 1|∙|1, 0, 00, 0, -10, 1, 0|=

=|cos(Θ_3 ), 0, -sin(Θ_3 )-sin(Θ_3 ), 0, -cos(Θ_3 )0, 1, 0| ;

τ_(3 (0))^((0)) =τ_01 ∙(l_1 +τ_12 ∙(l_2 +τ_23 ∙l_3 ))=

=|0, sin(Θ_1 ), cos(Θ_1 )0, cos(Θ_1 ), -sin(Θ_1 )-1, 0, 0|∙(|0l_1 0|+|cos(Θ_2 ), sin(Θ_2 ), 0-sin(Θ_2 ), cos(Θ_2 ), 00, 0, 1|∙

∙(|0l_2 0|+|cos(Θ_3 ), 0, -sin(Θ_3 )-sin(Θ_3 ), 0, -cos(Θ_3 )0, 1, 0|∙|00l_3 |))=

=|0, sin(Θ_1 ), cos(Θ_1 )0, cos(Θ_1 ), -sin(Θ_1 )-1, 0, 0|∙(|0l_1 0|+|cos(Θ_2 ), sin(Θ_2 ), 0-sin(Θ_2 ), cos(Θ_2 ), 00, 0, 1|∙

∙(|0l_2 0|+|-l_3 ∙sin(Θ_3 )-l_3 ∙cos(Θ_3 )0|))=

=|0, sin(Θ_1 ), cos(Θ_1 )0, cos(Θ_1 ), -sin(Θ_1 )-1, 0, 0|∙(|0l_1 0|+|cos(Θ_2 ), sin(Θ_2 ), 0-sin(Θ_2 ), cos(Θ_2 ), 00, 0, 1|∙

∙|-l_3 ∙sin(Θ_3 )l_2 -l_3 ∙cos(Θ_3 )0|)=

=|0, sin(Θ_1 ), cos(Θ_1 )0, cos(Θ_1 ), -sin(Θ_1 )-1, 0, 0|∙(|0l_1 0|+

+|-l_3 ∙cos(Θ_2 )∙sin(Θ_3 )+sin(Θ_2 )∙(l_2 -l_3 ∙cos(Θ_3 ))l_3 ∙sin(Θ_2 )∙sin(Θ_3 )+cos(Θ_2 )∙(l_2 -l_3 ∙cos(Θ_3 ))0|)=

=|0, sin(Θ_1 ), cos(Θ_1 )0, cos(Θ_1 ), -sin(Θ_1 )-1, 0, 0|∙

∙|-l_3 ∙cos(Θ_2 )∙sin(Θ_3 )+sin(Θ_2 )∙(l_2 -l_3 ∙cos(Θ_3 ))l_1 +l_3 ∙sin(Θ_2 )∙sin(Θ_3 )+cos(Θ_2 )∙(l_2 -l_3 ∙cos(Θ_3 ))0|=

=|sin(Θ_1 )∙{l_1 +l_3 ∙cos(Θ_2 )∙sin(Θ_3 )+sin(Θ_2 )∙(l_2 -l_3 ∙cos(Θ_3 ))}cos(Θ_1 )∙{l_1 +l_3 ∙cos(Θ_2 )∙sin(Θ_3 )+sin(Θ_2 )∙(l_2 -l_3 ∙cos(Θ_3 ))}l_3 ∙cos(Θ_2 )∙sin(Θ_3 )-sin(Θ_2 )∙(l_2 -l_3 ∙cos(Θ_3 ))| ;

Определив положение конца манипулятора τ_(3 (0))^((0)) можем найти Θ_1 - угол поворота плеча:

Θ_1 =arctan((τ_(3 (0))^((0)) _x)/(τ_(3 (0))^((0)) _y));

Два других угла найдем, решив следующую геометрическую задачу:

Даны две окружности, каждая определена координатами своего центра и радиусом. Требуется найти все их точки пересечения (либо одна, либо две, либо ни одной точки, либо окружности совпадают) (см. рис. 2.13).

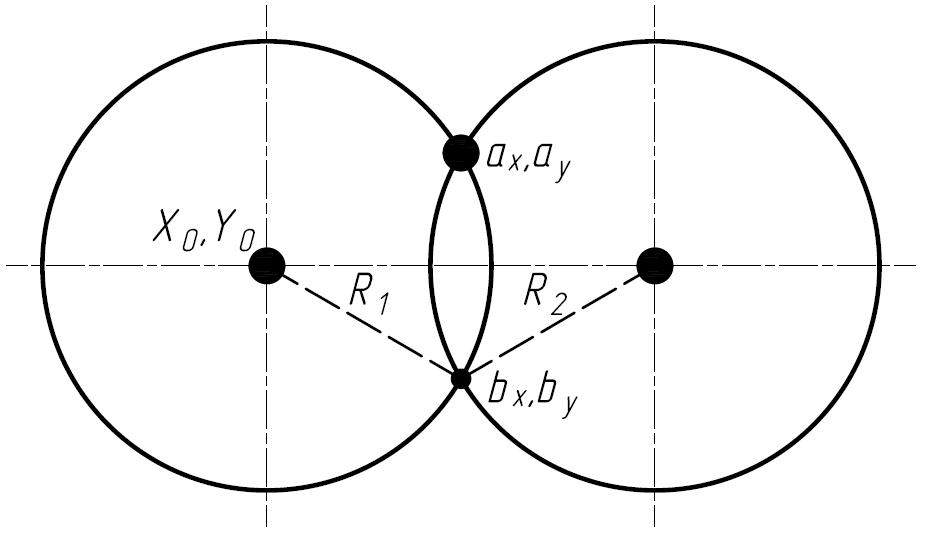
[picture p66: figure]

Рис. 2.13. Задача на пересечение двух окружностей

Решение:
Сведём нашу задачу к задаче о Пересечении окружности и прямой.

Предположим, не теряя общности, что центр первой окружности - в начале координат (если это не так, то перенесём центр в начало координат, а при выводе ответа будем обратно прибавлять координаты центра). Тогда мы имеем систему двух уравнений:

{, x^2 +y^2 =r_1^2 , (x-x_2 )^2 +(y-y_2 )^2 =r_2^2

Вычтем из второго уравнения первое, чтобы избавиться от квадратов переменных:

{, x^2 +y^2 =r_1^2 , x∙(-2∙x_2 )+y∙(-2∙y_2 )+(x_2^2 +y_2^2 +r_1^2 -r_2^2 )=0

Таким образом, мы свели задачу о пересечении двух окружностей к задаче о пересечении первой окружности и следующей прямой:

A∙x + B∙y + C=0 ;

A=-2∙x_2 ;

B=-2∙y_2 ;

C=(x_2^2 +y_2^2 +r_1^2 -r_2^2 ) ;

Вместо формального решения системы двух уравнений подойдём к задаче с геометрической стороны (причём, за счёт этого мы получим более точное решение с точки зрения численной устойчивости).

Предположим, не теряя общности, что центр окружности находится в начале координат (если это не так, то перенесём его туда, исправив соответствующе константу C в уравнении прямой). Т.е. имеем окружность с центром в (0,0) радиуса r и прямую с уравнением A∙x + B∙y + C=0 .

Сначала найдём ближайшую к центру точку прямой - точку с некоторыми координатами (x_0 ,y_0 ) . Во-первых, эта точка должна находиться на таком расстоянии от начала координат:

(|C|)/(√(A^2 +B^2))

Во-вторых, поскольку вектор (A,B) перпендикулярен прямой, то координаты этой точки должны быть пропорциональны координатам этого вектора. Учитывая, что расстояние от начала координат до искомой точки нам известно, нам нужно просто нормировать вектор (A,B) к этой длине, и мы получаем:

x_0 =-(A∙C)/(A^2 +B^2)

y_0 =-(B∙C)/(A^2 +B^2)

(здесь неочевидны только знаки 'минус', но эти формулы легко проверить подстановкой в уравнение прямой - должен получиться ноль)

Зная ближайшую к центру окружности точку, мы уже можем определить, сколько точек будет содержать ответ, и даже дать ответ, если этих точек 0 или 1.

Действительно, если расстояние от (x_0 ,y_0 ) до начала координат (а его мы уже выразили формулой - см. выше) больше радиуса, то ответ - ноль точек. Если это расстояние равно радиусу, то ответом будет одна точка - (x_0 ,y_0 ) . А вот в оставшемся случае точек будет две, и их координаты нам предстоит найти.

Итак, мы знаем, что точка (x_0 ,y_0 ) лежит внутри круга. Искомые точки (a_x ,a_y ) и (b_x ,b_y ) , помимо того что должны принадлежать прямой, должны лежать на одном и том же расстоянии d от точки (x_0 ,y_0 ) , причём это расстояние легко найти:

d=√(r^2 -(C^2)/(A^2 +B^2))

Заметим, что вектор (-B,A) коллинеарен прямой, а потому искомые точки (a_x ,a_y ) и (b_x ,b_y ) можно получить, прибавив к точке (x_0 ,y_0 ) вектор (-B,A) , нормированный к длине d (мы получим одну искомую точку), и вычтя этот же вектор (получим вторую искомую точку).

Окончательное решение такое:

mult=√((d^2)/(A^2 +B^2))

a_x =x_0 +B∙mult ;

a_y =y_0 -A∙mult ;

b_x =x_0 -B∙mult ;

b_y =y_0 +A∙mult ;

Зная координаты центра окружности и координаты точек пересечения, однозначно определяем углы Θ_2 ,Θ_3 .

# 2.5. Моделирование решения ОКЗ

Моделирование решения обратной кинематической задачи[2] производится в два этапа. Сначала с помощью блоков в графической среде имитационного моделирования Simulink, встроенной в среду MATLAB, собирается модель конечности робота (см. рис. 2.12). Затем в m-файле прописывается алгоритм вычисления углов поворота сервоприводов исходя из решенной обратной кинематической задачи для всей ноги. Таким образом, на каждый двигатель подается угол, рассчитанный ранее в m-файле (приложение 1).


Рис. 2.14. Блок-схема ноги робота

На рисунке 2.14 представлены следующие блоки:

- Body1, Body2, Body3 – плечо, предплечье, кисть;
- Connection port – соединение кисти с платформой;
- Revolute2, Revolute1, Revolute3 – шарниры соединения;
- Constant8, Constant6, Constant7 – углы, подаваемые на двигатели;
- Через JointActuator’ы подается угол, скорость и ускорение на шарнир;
- C JointSensor снимаются данные с шарниров;
- Scope отображает графики изменения положения шарниров (см. рис. 2.15).

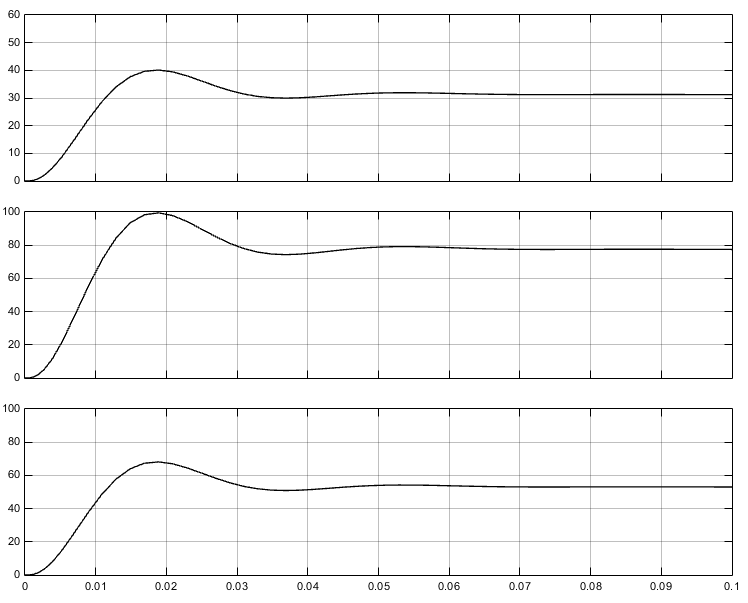
[picture p67: figure]

Рис. 2.15. Графики изменения положения звеньев ноги #5

M-файл, с помощью которого были произведены расчеты, находится в приложении 1.

Зная длины сочленений и координаты конца ноги, произведем расчет поворота углов звеньев ноги #5 вручную, чтобы проверить правильность расчета программы.

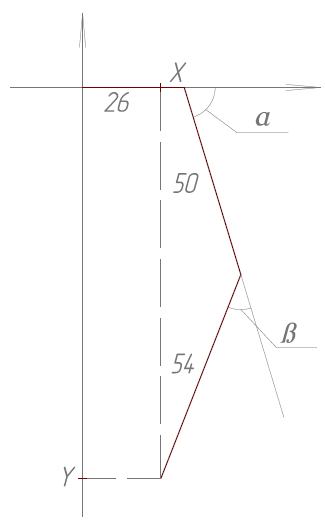
[picture p68: figure]

Рис. 2.16. Схема поворота ноги #5

В данном случае плечо неподвижно. Исходя из расчётов программы, угол α и β соответственно равны 77.2° и 31.2° (см. рис. 2.16). При таких значениях α и β искомые X и Y считаются по формулам:

X=26+50*cos(α)-54*sin(α+β-90°);

Y=50*sin(α)+54*cos⁡(α+β-90°);

X=20.0;

Y=100.0;

Полученные значения X и Y есть наши изначально установленные координаты, это значит, что программа работает верно.

# 2.6. Программный код для управления движения шагающим роботом

Описание алгоритма управления роботом [5]

В первую очередь требуется установить связь с аппаратной частью робота. Связь обеспечивается через последовательное проводное соединение, с помощью стандартных библиотек OS Windows.

Далее нужно ввести координаты точки назначения в декартовых координатах (в базовой системе координат СК_(BASE) ).

На стратегическом уровне программа определяет угол курса ( φ_к ) и расстояние прямолинейного движения ( L ) по посчитанному курсу. После вычисления φ_к и L вызываются функции тактического уровня, в которых выполняются расчеты и перемещение на φ_к и L .

В силу ограничения подвижности габаритами элементов, робот не может повернуться сразу на угол φ_к и пройти на расстояние L . Исходя из этого движения φ_к и L разбиваются на части меньшие фиксированной длинны и угла, т.е. элементарные угловые и линейные перемещения.

Для каждого элементарного перемещения задаются вектора управления концами ног. Учитывая текущее положение и вектор управления, решаем ОКЗ для каждой ноги.

После решения ОКЗ и получения углов шарниров требуется сформировать сообщение для последовательного соединения по заданному протоколу. Нулевое положение принимается за 1500мс. 1°=100/9мс .

Отправка сообщений происходит с задержками, принятыми для завершения переходных процессов. Для исключения ударов ноги, при опускании ее на землю, введена следующая последовательность отработки углов: Θ_3 →Θ_1 →Θ_2 ;

Достигнув заданную точку, программа завершается.

Блок – схема алгоритма программы представлена на рисунке 2.15.

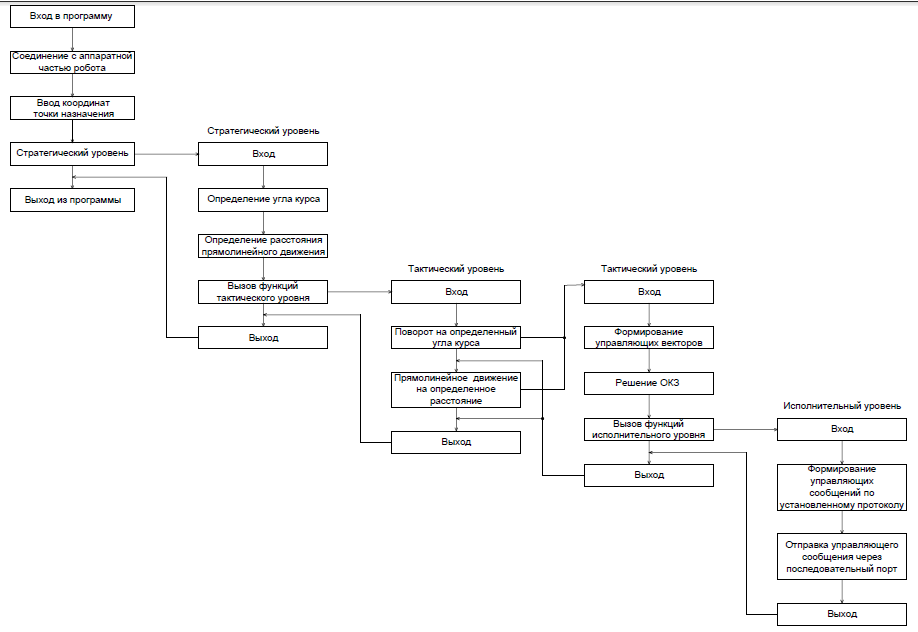
[picture p69: figure]

Рис. 2.17. Блок – схема алгоритма программы управления роботом

# 2.7. Реализация Алгоритма Ли для поиска кратчайшего пути по заданной карте местности

В данной дипломной работе стоит задача поиска кратчайшего пути по заданной плоской карте местности. Исходя из начальных условий – известная плоская карта местности, координаты начала и конца маршрута, размеры робота и карты, необходимо построить кратчайший путь, при этом обойдя все препятствия на плоской карте местности.

Для поиска кратчайшего пути был выбран волновой алгоритм Ли. Алгоритм работает на дискретном рабочем поле (ДРП), представляющем собой ограниченную замкнутой линией фигуру, не обязательно прямоугольную, разбитую на прямоугольные ячейки, в частном случае — квадратные. Множество всех ячеек ДРП разбивается на подмножества: «проходимые» (свободные), т. е при поиске пути их можно проходить, «непроходимые» (препятствия), путь через эту ячейку запрещён, стартовая ячейка (источник) и финишная (приемник). Назначение стартовой и финишной ячеек условно, достаточно — указание пары ячеек, между которыми нужно найти кратчайший путь.

Алгоритм предназначен для поиска кратчайшего пути от стартовой ячейки к конечной ячейке.

Работа алгоритма включает в себя три этапа: инициализацию, распространение волны и восстановление пути.

Во время инициализации строится образ множества ячеек обрабатываемого поля, каждой ячейке приписываются атрибуты проходимости/непроходимости, запоминаются стартовая и финишная ячейки.

Далее, от стартовой ячейки порождается шаг в соседнюю ячейку, при этом проверяется, проходима ли она, и не принадлежит ли ранее меченной в пути ячейке.

Соседние ячейки принято классифицировать двояко: в смысле окрестности Мура (https://ru.wikipedia.org/wiki/%D0%9E%D0%BA%D1%80%D0%B5%D1%81%D1%82%D0%BD%D0%BE%D1%81%D1%82%D1%8C_%D0%9C%D1%83%D1%80%D0%B0) и окрестности фон Неймана (https://ru.wikipedia.org/wiki/%D0%9E%D0%BA%D1%80%D0%B5%D1%81%D1%82%D0%BD%D0%BE%D1%81%D1%82%D1%8C_%D1%84%D0%BE%D0%BD_%D0%9D%D0%B5%D0%B9%D0%BC%D0%B0%D0%BD%D0%B0), отличающийся тем, что в окрестности фон Неймана соседними ячейками считаются только 4 ячейки по вертикали и горизонтали, в окрестности Мура — все 8 ячеек, включая диагональные.

При выполнении условий проходимости и непринадлежности её к ранее помеченным в пути ячейкам, в атрибут ячейки записывается число, равное количеству шагов от стартовой ячейки, от стартовой ячейки на первом шаге это будет 1. Каждая ячейка, меченая числом шагов от стартовой ячейки становится стартовой и из неё порождаются очередные шаги в соседние ячейки. Очевидно, что при таком переборе будет найден путь от начальной ячейки к конечной, либо очередной шаг из любой порождённой в пути ячейки будет невозможен.

Восстановление кратчайшего пути происходит в обратном направлении: при выборе ячейки от финишной ячейки к стартовой на каждом шаге выбирается ячейка, имеющая атрибут расстояния от стартовой на единицу меньше текущей ячейки. Очевидно, что таким образом находится кратчайший путь между парой заданных ячеек. Трасс с минимальной числовой длиной пути, как при поиске пути в окрестностях Мура, так и фон Неймана может существовать несколько. Выбор окончательного пути в приложениях диктуется другими соображениями, находящимися вне этого алгоритма [11].

Для более понятного и наглядного объяснения, в приложении 4 представлена блок-схема работы волнового алгоритма Ли.

Результат работы волнового алгоритма представлен на рисунке 2.18.


Рис. 2.18. Результат работы волнового алгоритма

Основное преимущество данного алгоритма заключается в легкости его реализации. Так же, реализовывая данный алгоритм, мы получаем массив чисел, пронумерованных по номеру движения и имеющий определенные, ранее заложенные действия для нашего робота.

Как отмечено выше, структура кода разделена на три части: инициализация, распространение волны и восстановление пути. Разберем эти три части подробне.

В первой части инициализации мы дискретизируем карту местности, задаем ее габариты, отмечаем непроходимые и проходимые участки, а так же задаем начало и конец пути.

Для того, чтобы реализовать алгоритм Ли, нам необходимо задать карту местности, по которой будет перемещаться робот. Для этого нужно проанализировать имеющийся участок на наличие неровностей рельефа, в том числе проходимых и непроходимых участков. После оценки площади обрабатываемой местности, необходимо задать точность дискретизации, то есть размер одной ячейки карты местности. Для удобства расчетов, зададим длину и ширину ячейки карты местности равными расстоянию между передними и задними конечностями робота. Это нужно для того, чтобы за одно перемещение вперед робот перемещался ровно в соседнюю клетку на карте местности. Расстояние между передними и задними конечностями составляет 220мм. Соответственно, габариты одной ячейки зададим равными 220мм на 220мм.

Имея габариты одной клетки, разобьем всю карту местности на ячейки и обозначим непроходимые участки цифрой 0, а проходимые цифрой 1, как представлено на рисунке 2.19. В следующем шаге мы изменим значения ячеек, но на первом этапе, для наглядности, обозначим их именно так.


Рис. 2.19. Дискретезированная карта местности

Таким образом, изначально заданная карта местности с габаритами 2200 мм на 2200 мм превратилась в дискретизованную карту, с габаритами 10 на 10 клеток. Если в какой либо из частей клетки возникает непреодолимое препятствие, то вся клетка считается непроходимой для нашего робота.

Зададим координаты начала и конца пути и обозначим их на карте числами -1 и -2 соответственно (см. рис. 2.19). Так же необходимо задать изначальную ориентацию робота, то есть сторону света, в которую будет направлена передняя часть нашего робота, при установке его в начало пути. Зададим первоначальное положение обращенным на север.

Во второй части алгоритма разрабатывается непосредственно распространение волны. Так как волна при распространении будет присваивать каждой проходимой ячейке свой порядковый номер, начиная с ноля, нам необходимо переназначить значения ячеек для последующей их обработки. Для этого нам необходимо выбрать числа, значение которых будет превышать максимально возможное количество «волн» нашего алгоритма. При любом возможном рельефе карты с размером 10 на 10 клеток, максимальное число волн не превысит количества 100 штук. Поэтому переназначим все непроходимые участки на значение 100, проходимые и конец пути на значение 150, а начало пути на значение 0, так как последующий алгоритм будет строить волну из начальной точки нашего маршрута. Далее, начиная с начальной точки, проверяем соседние ячейки на проходимость. Если соседняя ячейка проходима, ты мы присваиваем ей значение, равное порядковому номеру волны. И так повторяем, пока общая «волна» не проверит всю карту (см. рис. 2.20).


Рис. 2.20. Распространение волны по карте от начальной точки маршрута

В третьей, заключительной, части восстановления пути, по имеющимся сохраненным данным, мы восстанавливаем путь от начальной точки до конечной, по самому короткому маршруту. Для этого определяем значение ячейки конца пути, координаты которой были запомнены в первом шаге алгоритма. Значение этой ячейки будет равно количеству шагов по клеткам от начала маршрута до его конца. В нашем случае это значение равное девяти. Далее ищем ближайшую точку со значением, равным девять минус один. Запоминаем координаты этой точки и ищем следующую точку. Повторяем, пока не достигнем значения ноль, то есть конец пути (см. рис. 2.21).


Рис. 2.21. Построенный маршрут

В итоге получаем массив координат ячеек, по которым должен двигаться робот, чтобы преодолеть путь из начальной точки в конечную по кратчайшему маршруту.

# 2.8. Реализация движения робота по заданным координатам

В предыдущем пункте было подробно разобрано нахождение кратчайшего пути от начальной точки к конечной по заданной карте местности. Используя алгоритм Ли, получили массив координат ячеек, используя который, шестиногий робот должен передвигаться по заданному маршруту.

Так как робот движется только вперед, для поворота направо или налево ему необходимо совершить два последовательных действия: сначала повернуться на месте на заданный угол, а затем пройти вперед на заданное расстояние.

Зададим и опишем роботу три возможных действия:

- Движение вперед – робот перемещается вперед на расстояние 220мм.
- Движение налево – робот совершает поворот влево на 90° на месте. После завершения поворота робот перемещается вперед на расстояние 220мм.
- Движение направо – робот совершает поворот вправо на 90° на месте. После завершения поворота робот перемещается вперед на расстояние 220мм.

Таким образом, чтобы робот правильно отработал траекторию перемещения, ему необходимо задавать последовательные команды поворотов и движения вперед. Назначение каждой последующей команды будет зависеть от ориентации робота в пространстве (см. рис. 2.22) и от координат последующей точки перемещения.


Рис. 2.22. Схема ориентации робота

Если ориентация робота направлена в направлении следующей ячейки, то робот осуществляет движение вперед.

Если следующая ячейка находится справа (или слева) от робота, то робот осуществляет поворот вправо (или влево) на 90° на месте. Ориентация робота переназначается и робот осуществляет движение вперед.

Просчитывая все необходимые движения, программа сохраняет их в одномерный массив. В итоге, преобразовывая массив координат ячеек, по которым должен двигаться робот, получаем массив движений робота, каждое движение которого может иметь один из трех вариантов: движение вперед, поворот налево или поворот направо.

Подробный код представлен в приложении 2.

# 2.9. Натурный эксперимент

При постановке задач эксперимента было выбрано несколько целей. Для проверки правильности решения ОКЗ и оценки точности перемещения:

- Прохождение робота по прямой на 1000мм;
- Поворот робота на 90° по часовой стрелке;
- Поворот робота на 90° против часовой стрелке;

Для проверки правильности прохождения робота по заданным координатам было выбрано четыре пути, отличающихся по сложности, т.е. количеству поворотов (см. рис. 2.23).

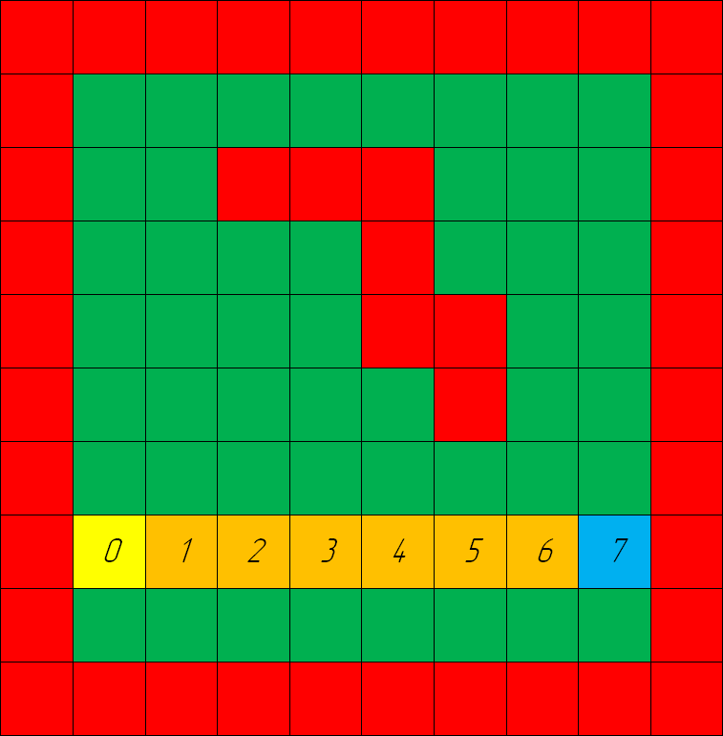
[picture p70: figure]
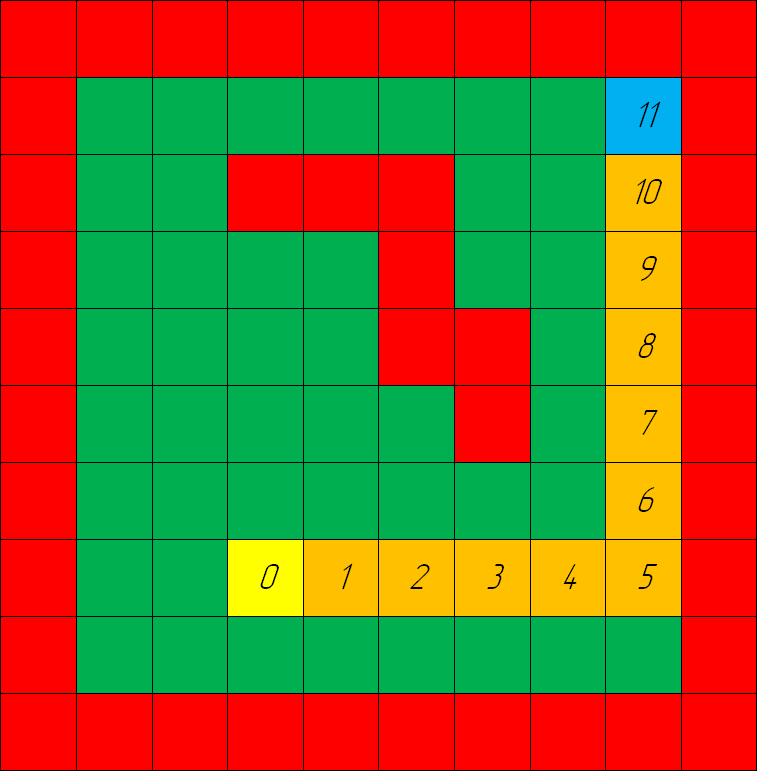
[picture p71: figure]

а) Ноль поворотов. | б) Один поворот.

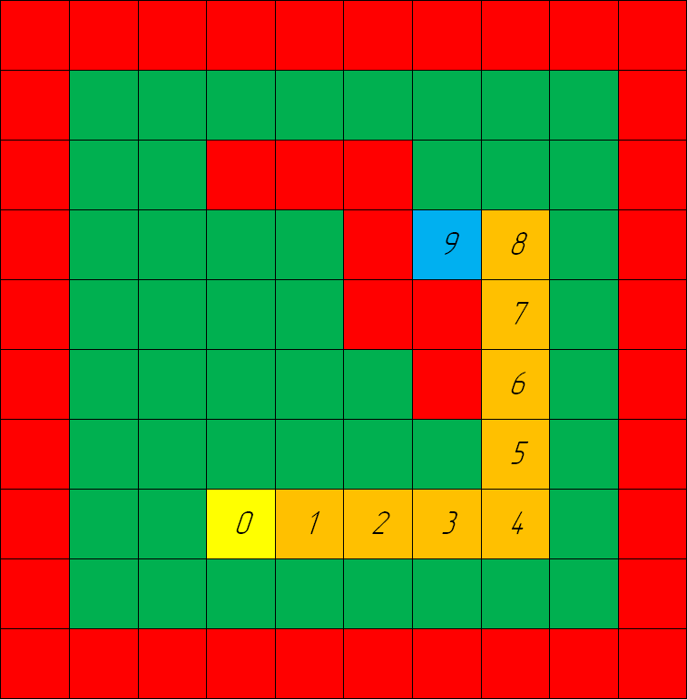
[picture p72: figure]
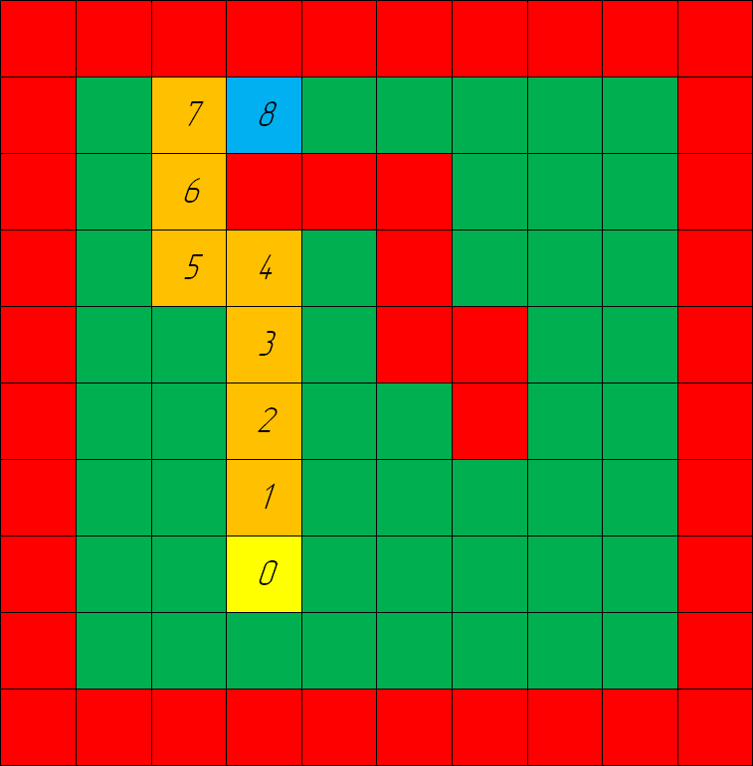
[picture p73: figure]

б) Два поворота. | г) Три поворота.

Рис. 2.23. Пути прохождения маршрута

Так же было рассмотрено несколько вариантов питания с использованием четырех аккумуляторных батарей:

- Полностью заряженные с суммарным напряжением 5,5 В;
- Заряженные с суммарным напряжением 5,0 В;
- Разряжены и суммарное напряжение ниже номинального 4,8 В.

Для первой части натурного эксперимента был отмечен участок 1000 мм на ровной поверхности. Так же были отмечены углы +90° и -90°. После чего было проведено по 10 экспериментов, результаты которых отражены в таблице 2.7.

№ Эксперимента | 1000 мм по прямой | 90° по часовой | 90° против часовой
| Результаты эксперимента
1 | 1010 | 86 | 91
2 | 950 | 88 | 90
3 | 973 | 86 | 95
4 | 1018 | 87 | 94
5 | 964 | 86 | 89
6 | 1068 | 85 | 96
7 | 1050 | 89 | 92
8 | 920 | 86 | 95
9 | 988 | 88 | 91
10 | 990 | 85 | 93
Среднее значение отклонения | 36,1 | 3,4 | 2,8
Среднее значение отклонения в % | 3,6 | 3,8 | 3,1

Табл. 2.7. Результаты экспериментов

Для второй части натурного эксперимента было размечено поле 2200 мм на 2200мм с размером ячейки 220 мм на 220 мм. Так же было проведено по 10 натурных экспериментов, результаты которых отражены в таблице 2.8.

№ Эксперимента | 0 поворотов | 1 поворот | 2 поворота | 3 поворота
| Результаты эксперимента
1 | ✔ | ✔ | ✔ | ✔
2 | ✔ | ✔ | ✔ | ×
3 | ✔ | ✔ | ✔ | ✔
4 | ✔ | ✔ | ✔ | ✔
5 | ✔ | ✔ | ✔ | ×
6 | ✔ | ✔ | ✔ | ✔
7 | ✔ | ✔ | × | ✔
8 | ✔ | ✔ | ✔ | ×
9 | ✔ | ✔ | ✔ | ✔
10 | ✔ | ✔ | ✔
Сумма правильных отработок | 10 | 10 | 9 | 7
Сумма неправильных отработок | 0 | 0 | 1 | 3

Табл. 2.8. Результаты экспериментов

Условные обозначения:

✔ – робот правильно отработал траекторию

× – робот неправильно отработал траекторию

Для третьей части эксперимента было рассмотрено три случая:

- В случае полностью заряженных аккумуляторов робот полностью отрабатывает траекторию на высокой скорости.
- В случае напряжения 5,0 В траектория так же выполняется без ошибок, но время исполнения команд увеличивается и робот шагает медленнее.
- В случае разряженных аккумуляторов с напряжением ниже 4,8 В робот продолжает принимать команды, но выполняет их неправильно и не решает поставленной задачи.

Вывод

В результате проведенных экспериментов мы получили следующие данные.

В первой части натурного эксперимента получили следующие ошибки:

В случае движения по прямой – 3,6%, в случае движения по часовой стрелке – 3,8%, в случае движения против часовой стрелки – 3,1%.

Во второй части натурного эксперимента при прохождении простых траекторий с нулем и одним поворотами проблем с прохождением траектории не возникло. При прохождении двух поворотов один раз из десяти робот не отработал траекторию. При прохождении трех поворотов робот трижды неправильно отработал траекторию. Увеличение погрешности с увеличением количества поворотов связано с тем, что изначально робот имеет ошибки при прохождении прямых и при поворотах, из-за чего не может попасть в изначально заданную ячейку карты.

# 2.10. Заключение

- Произведен энергетический расчет, выбран двигатель ДПТ TowerPro SG92R для каждого звена.
- Моделирование показало, что синтез не требуется.
- Решена обратная кинематическая задача трехзвенного манипулятора с 3-мя степенями свободы.
- После проверки с помощью графической среды, а так же с помощью шестиногого робота, управляя им с помощью программного кода, написанного на языке C++ было установлено, что ОКЗ решена верно.
- Реализовано нахождение кратчайшего маршрута по заданной карте местности.
- Реализовано движение робота в пространстве по заданным координатам.

# 7. Список использованной литературы

1. Лесков А.Г., «МАНИПУЛЯЦИОННЫЕ РОБОТЫ», Конспект лекций по курсу «ОСНОВЫ РОБОТОТЕХНИКИ» – М.: Издательство МГТУ, 2011;
2. Калеватых И.А., методическое пособие «Создание виртуальной модели манипуляционного робота, решение и программирование обратной кинематической задачи» – М.: Издательство МГТУ, 2014;
3. Павловский Е.В., Панченко А.В., «Модели и алгоритм управления движением малого шестиногого робота», журнал «Мехатроника, автоматизация, управление» № 11, – М.: Изд-во «Новые Технологии», 2012.
4. Стрелков С. П., «ОБЩИЙ КУРС ФИЗИКИ» – М.: Издательство «НАУКА», 1975. - 61 с.
5. Улли Соммер, «Программирование микроконтроллерных плат Arduino/Freeduino» – СПб: Изд-во «БХВ-Петербург», 2016.
6. Фокин В. Г., Шаныгин С. В. Обзор и перспективы развития мобильных шагающих робототехнических систем // Молодой ученый. — 2015. — №18. — С. 207-215.
7. Прата С. «Язык программирования С++. Лекции и упражнения» (5-е издание) - М.: Издательство Вильямс, 2013.
8. Бесекерский В.А., Попов Е.П., «Теория автоматического управления» - М.: Издательство Профессия, 2007.
9. Иванов В.А., Медведев В.С., Чемоданов Б.К., Ющенко А.С. «Математические основы теории автоматического управления» - М.: Издательство МГТУ, 1971.
10. Кузьмина А.О., методическое пособие «Расчет электрической исполнительной системы манипулятора» – М.: Издательство МГТУ, 2006.
11. Википедия – свободная энциклопедия [Электронный ресурс]. - https://ru.wikipedia.org/wiki/Алгоритм_Ли - (дата обращения: 25.05.2016).
