VovaRodger/Robo/Чертежи/Блок-схема управления.pdf

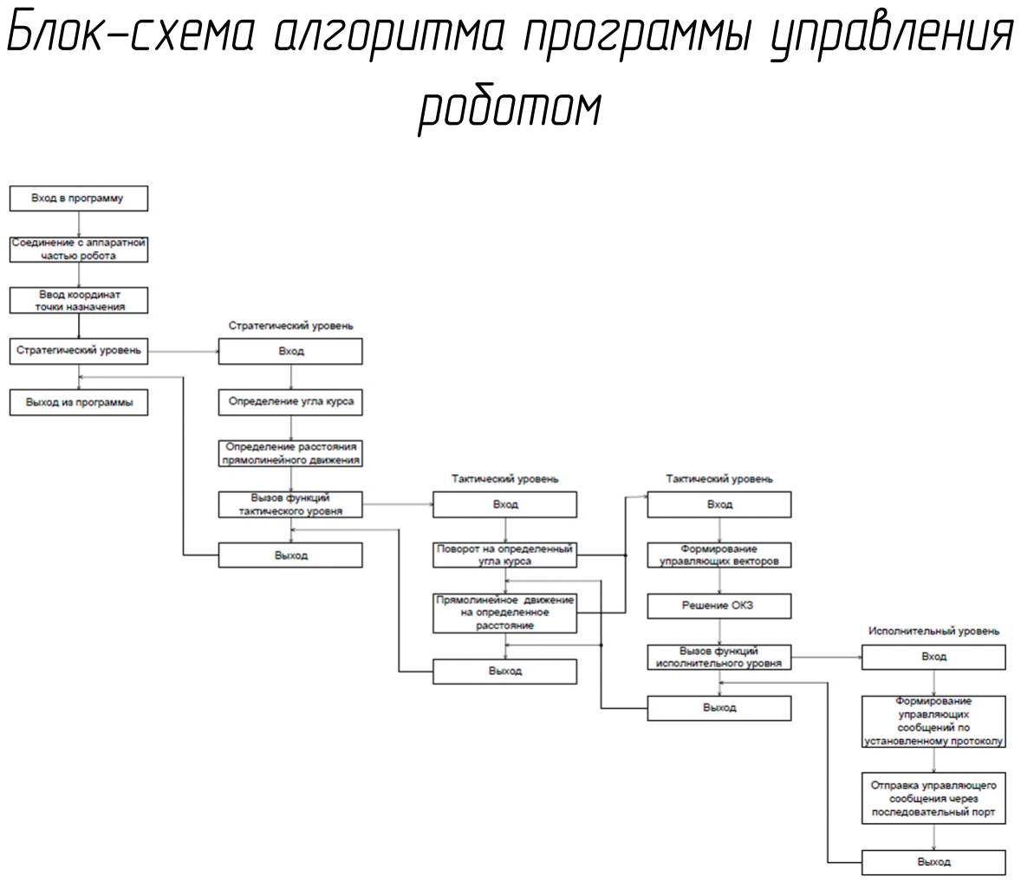
[picture p77: page 1]
