VovaRodger/Robo/Чертежи/Волновой алгоритм.pdf

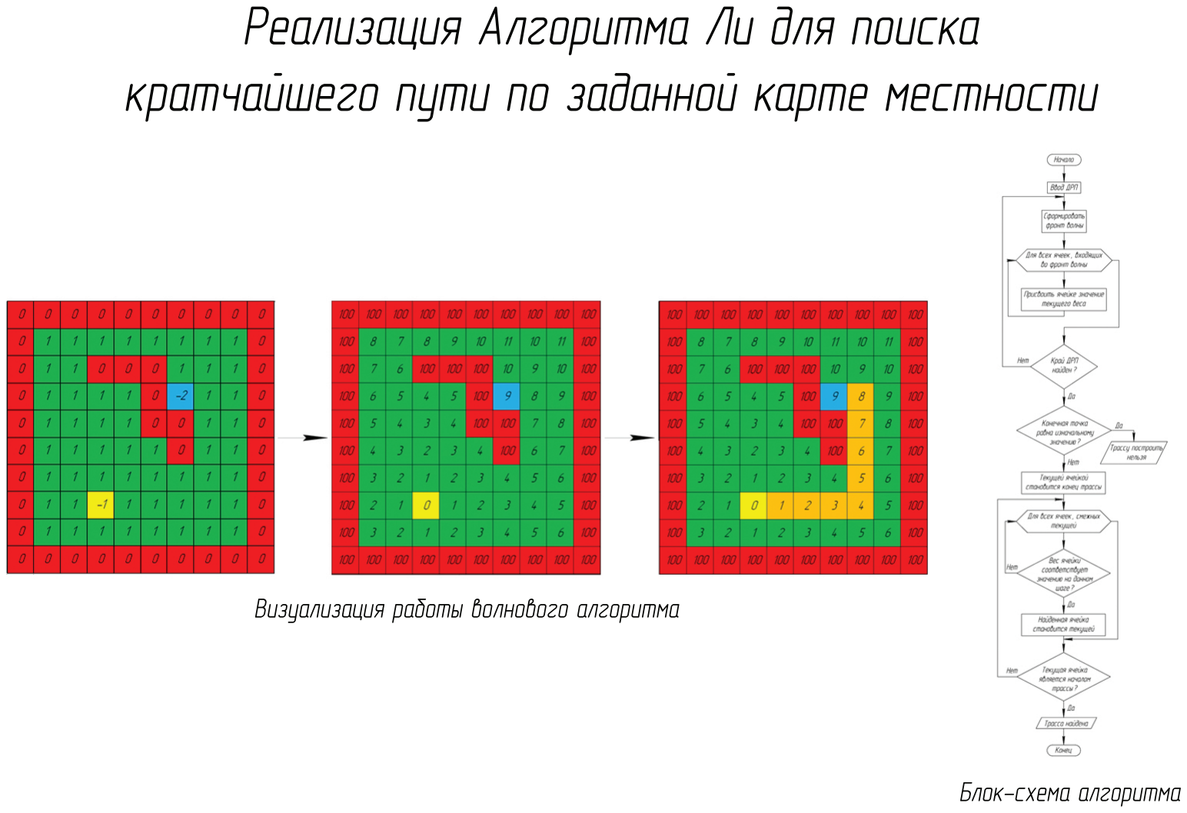
[picture p78: page 1]
