VovaRodger/Robo/Чертежи/Моделирование решения ОКЗ.pdf

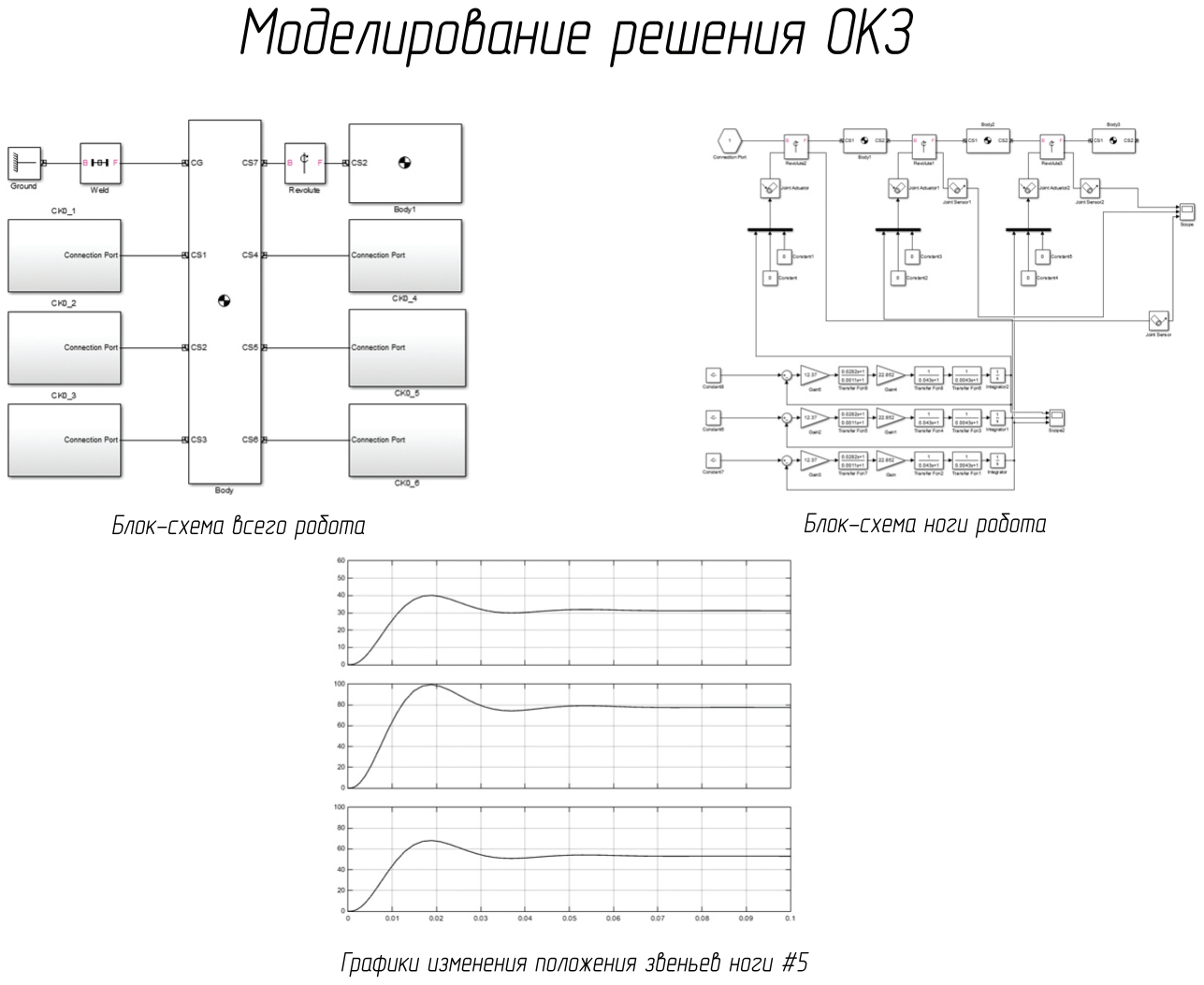
[picture p79: page 1]
