VovaRodger/Robo/Чертежи/Постановочный лист.pdf

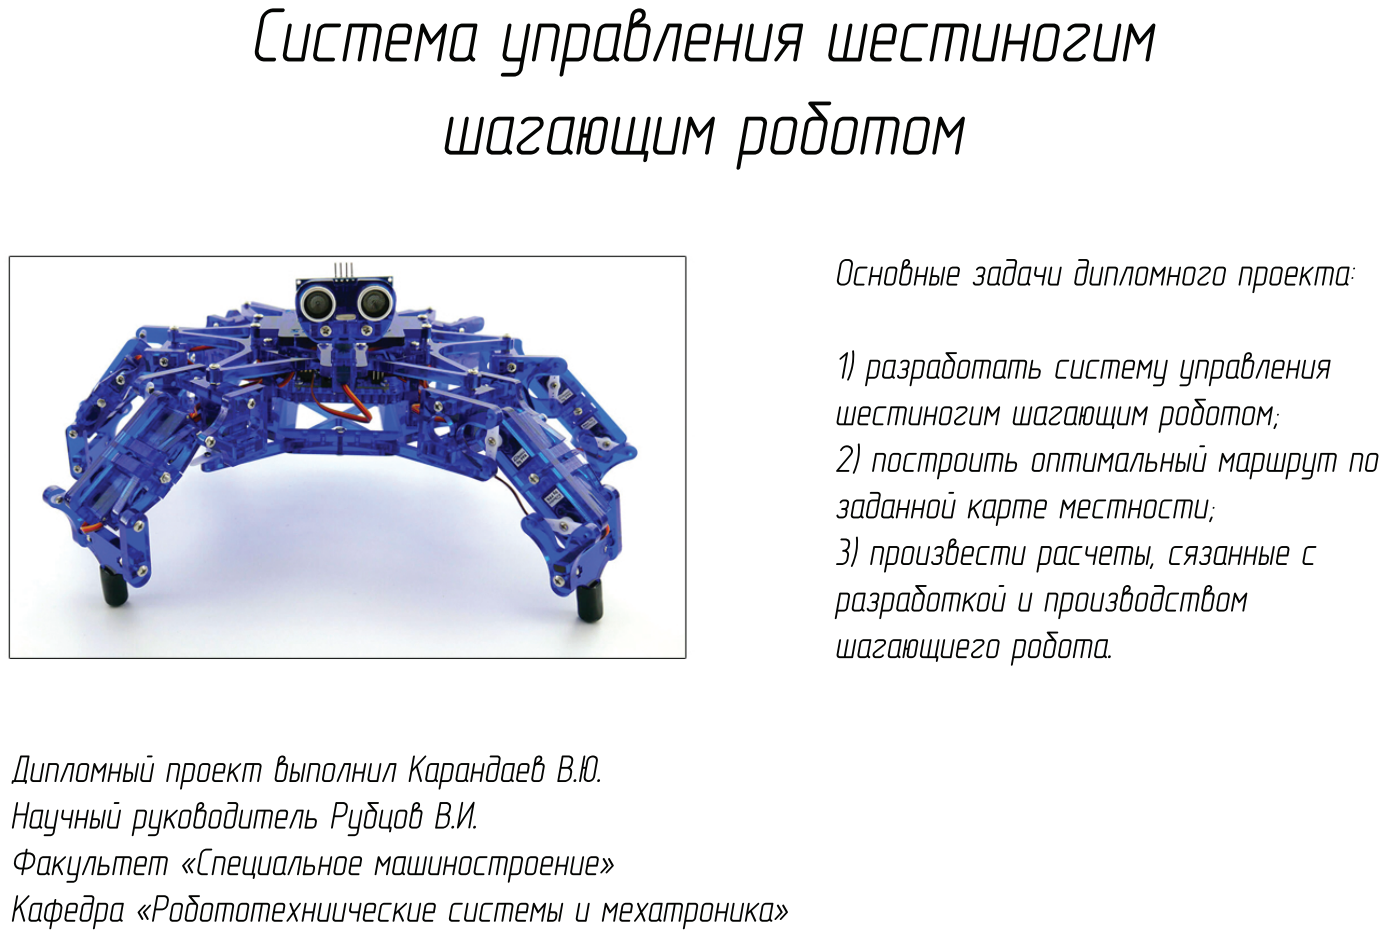
[picture p80: page 1]
