VovaRodger/Robo/Чертежи/Синтез и моделирование.pdf

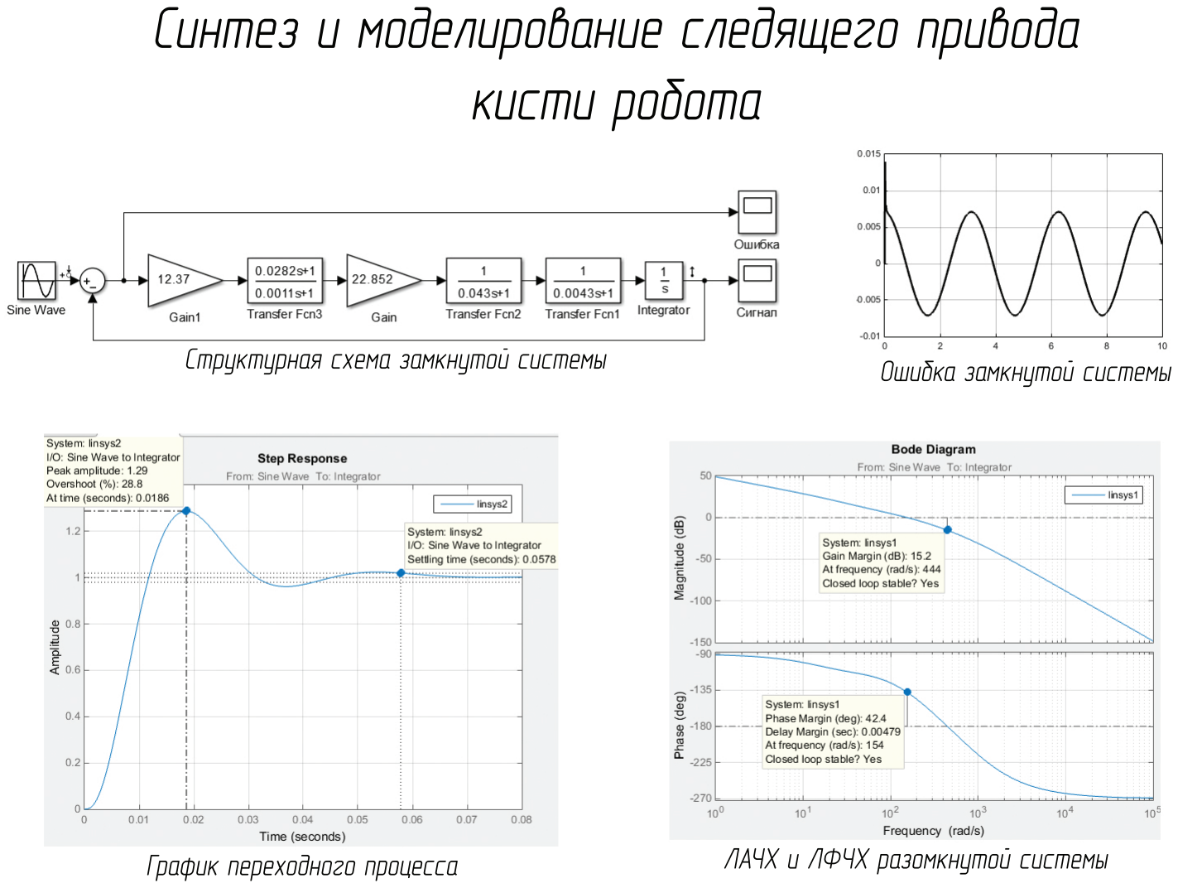
[picture p81: page 1]
