VovaRodger/Robo/Конструкторская часть/YIQi-MWtrow.jpg

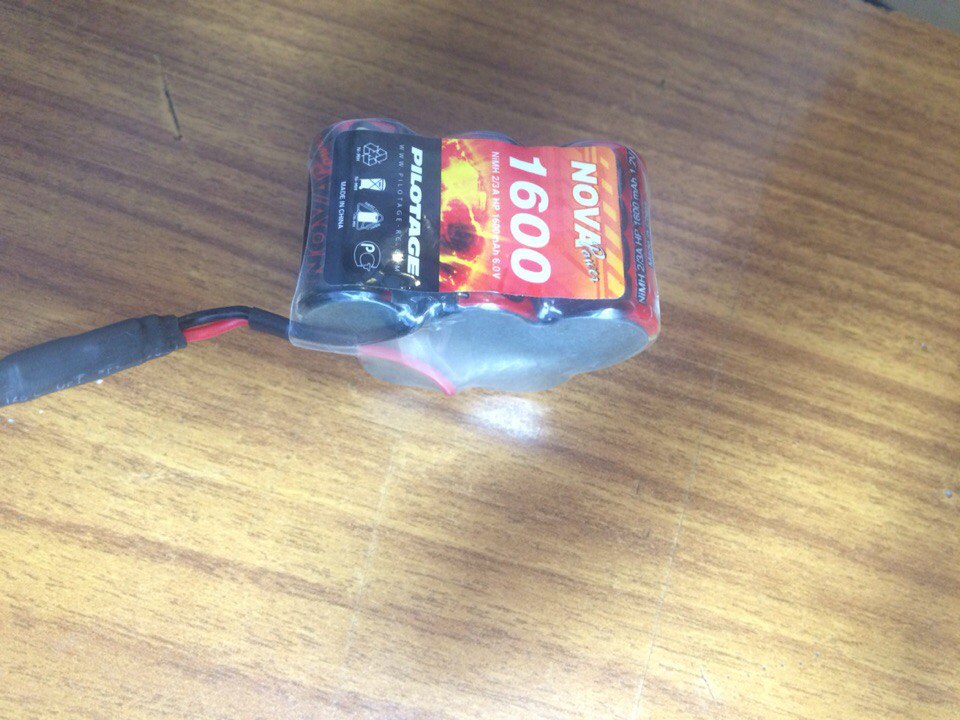
Конструкторская часть/YIQi-MWtrow.jpg
