VovaRodger/Robo/Конструкторская часть/сбор. черт.png

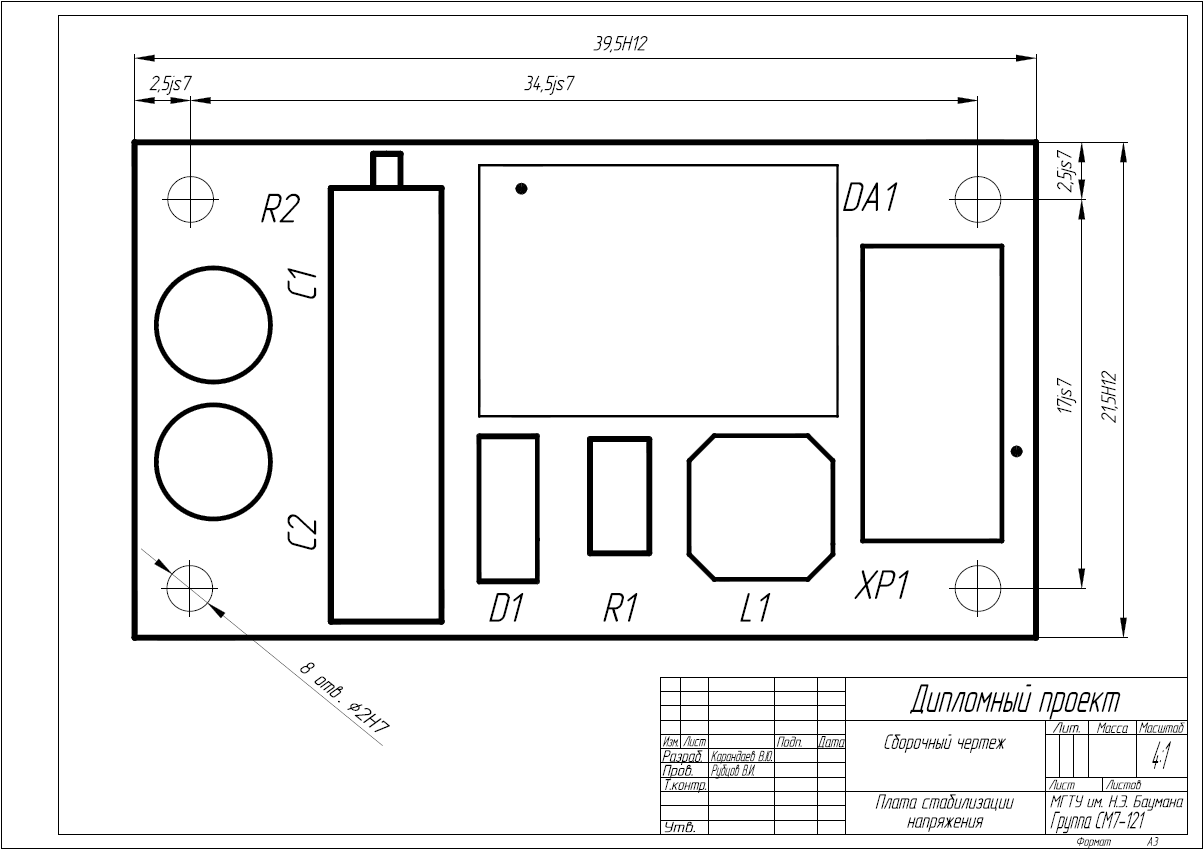
Конструкторская часть/сбор. черт.png
