VovaRodger/Robo/Научно-исследовательская часть/Hexy-2.jpg

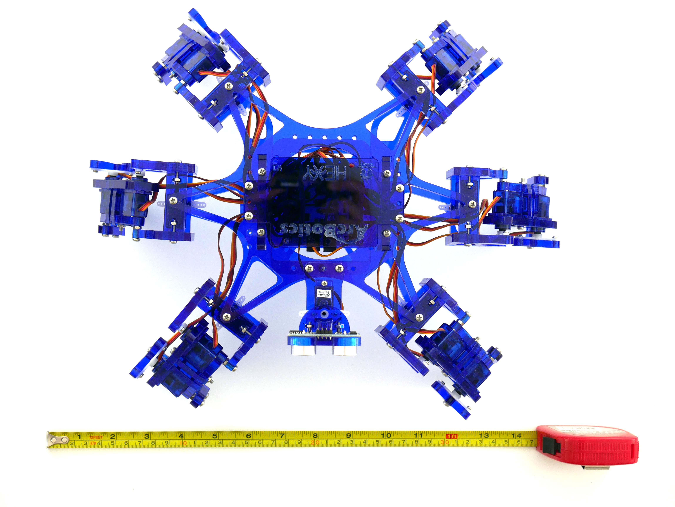
Научно-исследовательская часть/Hexy-2.jpg
