VovaRodger/Robo/Научно-исследовательская часть/map3.png

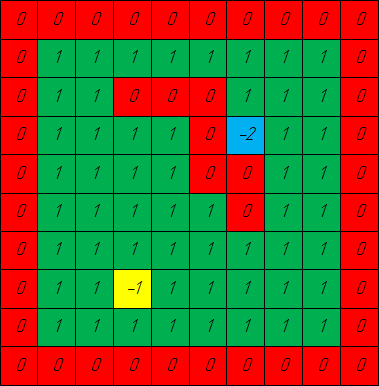
Научно-исследовательская часть/map3.png
