VovaRodger/Robo/Научно-исследовательская часть/map20.png

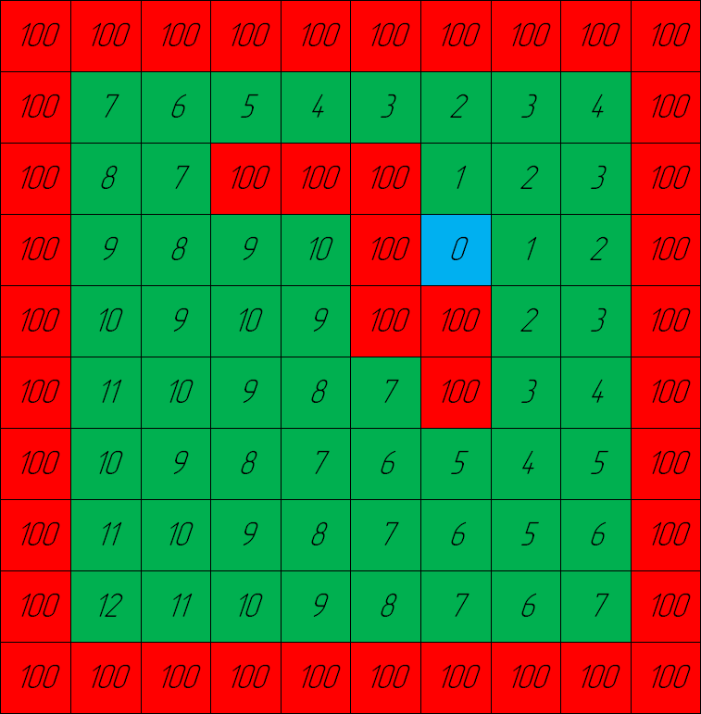
Научно-исследовательская часть/map20.png
