VovaRodger/Robo/Научно-исследовательская часть/map30.png

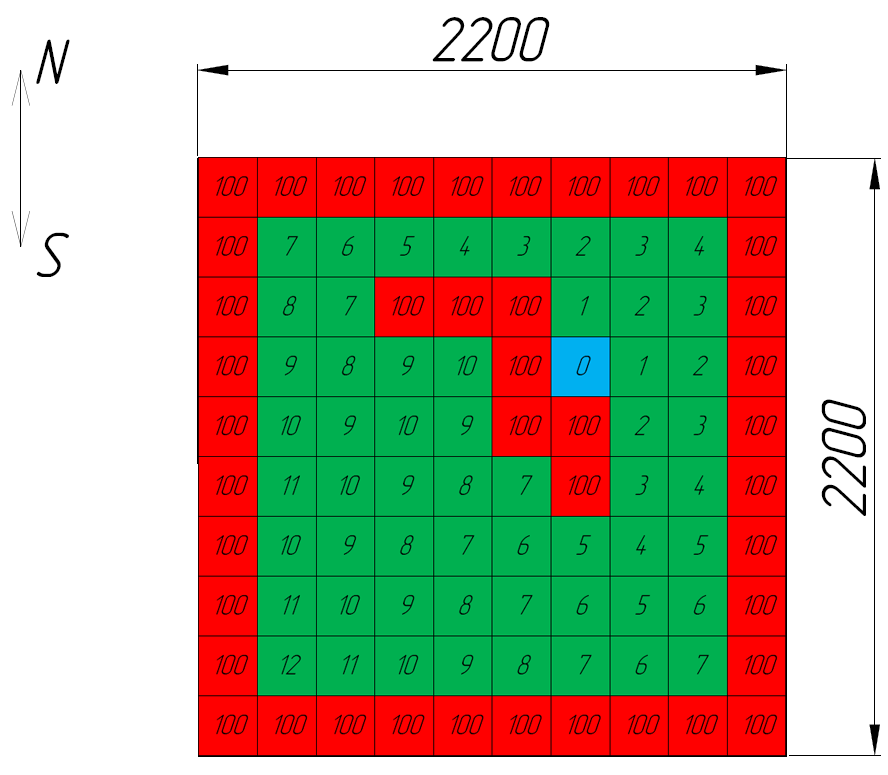
Научно-исследовательская часть/map30.png
