VovaRodger/Robo/Научно-исследовательская часть/map50.png

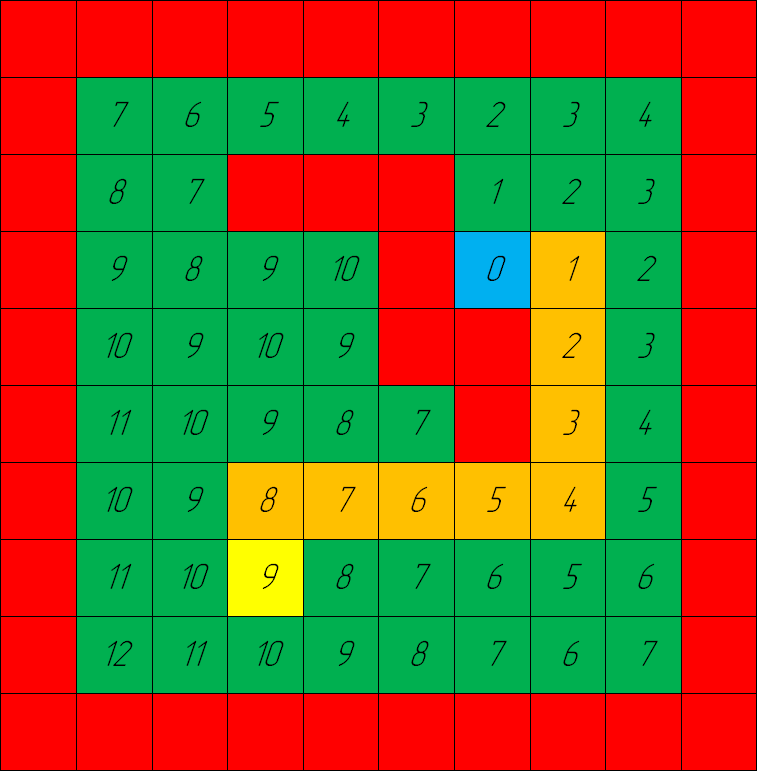
Научно-исследовательская часть/map50.png
