VovaRodger/Robo/Научно-исследовательская часть/Блок-схема.png

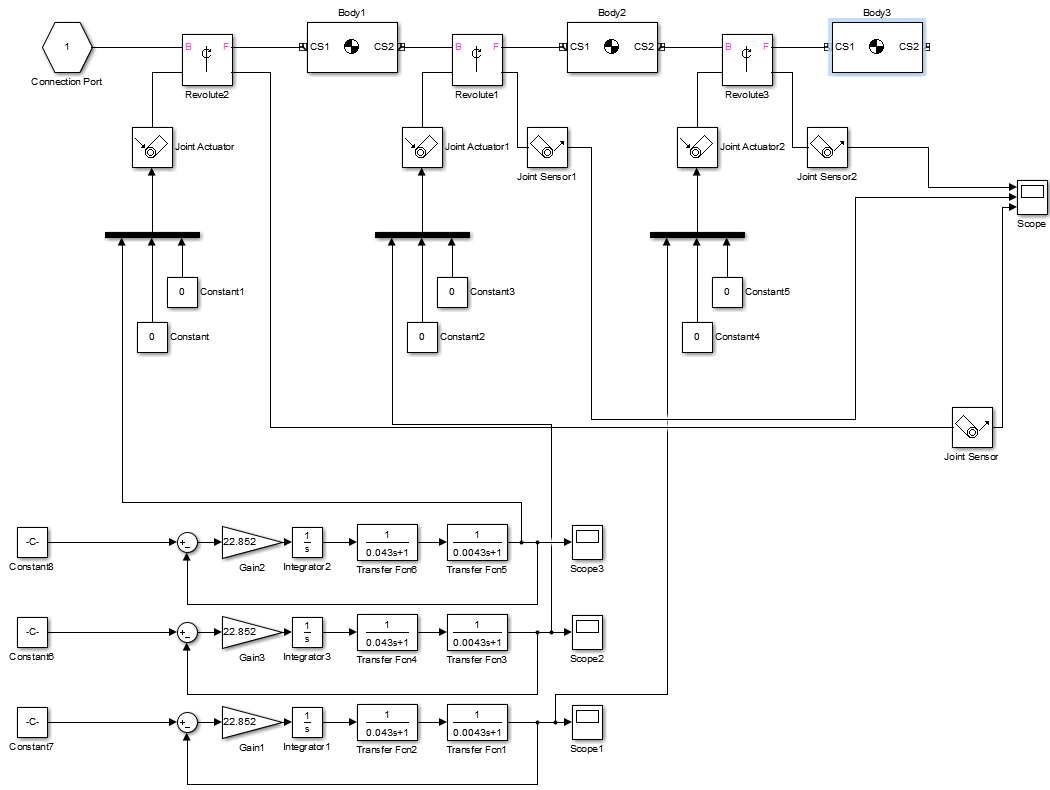
Научно-исследовательская часть/Блок-схема.png
