VovaRodger/Robo/Научно-исследовательская часть/Ли_схема.png

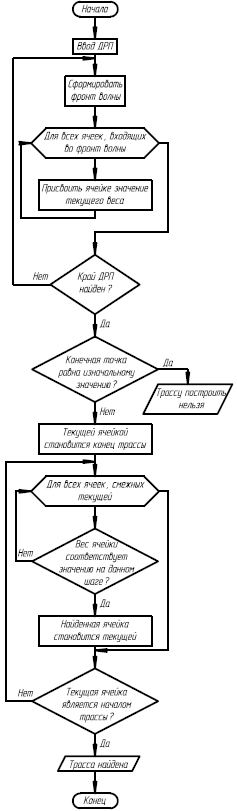
Научно-исследовательская часть/Ли_схема.png
