VovaRodger/Robo/Научно-исследовательская часть/робот2.jpg

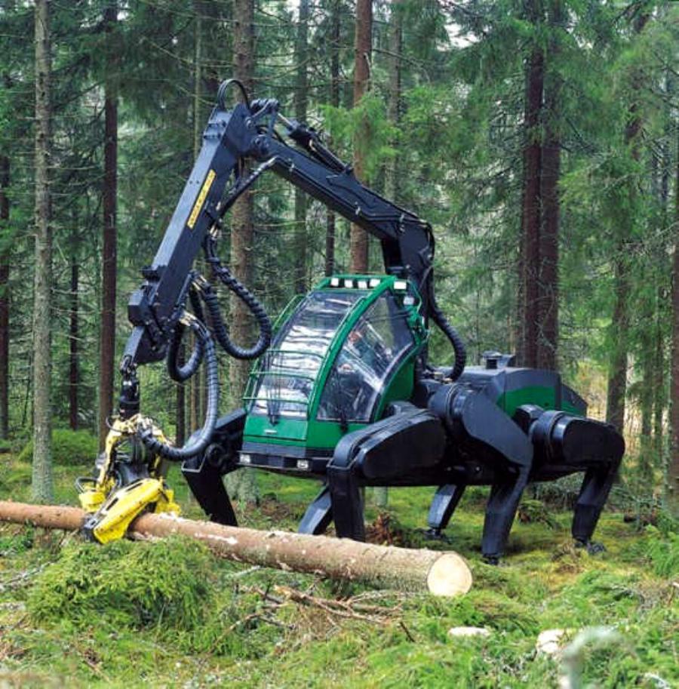
Научно-исследовательская часть/робот2.jpg
