VovaRodger/Robo/Научно-исследовательская часть/Синтез/ошибка1.png

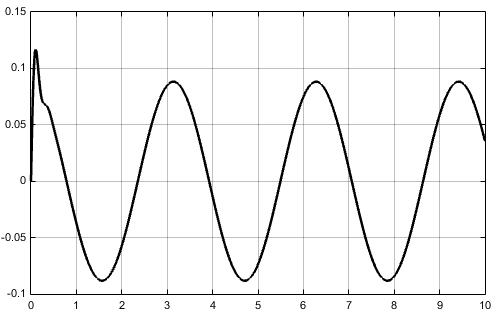
Научно-исследовательская часть/Синтез/ошибка1.png
