VovaRodger/Robo/Научно-исследовательская часть/Структурная схема замкнутой системы.png

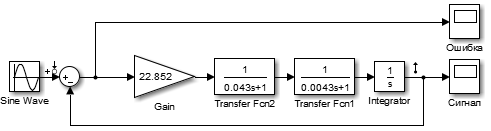
Научно-исследовательская часть/Структурная схема замкнутой системы.png
