VovaRodger/Robo/Научно-исследовательская часть/углы шарниров.png

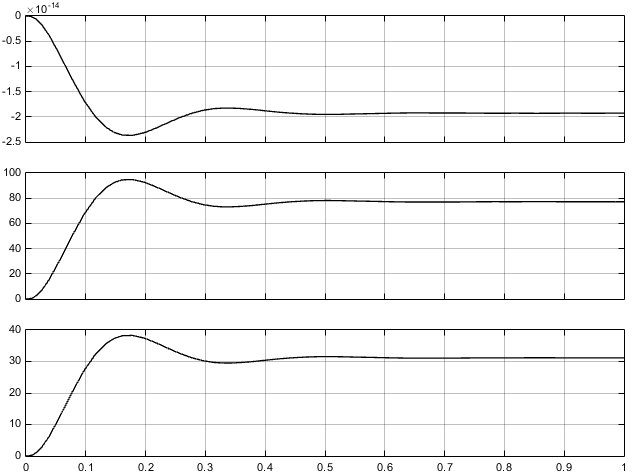
Научно-исследовательская часть/углы шарниров.png
