VovaRodger/Robo/Организационно – экономическая часть/Hexy-5.jpg

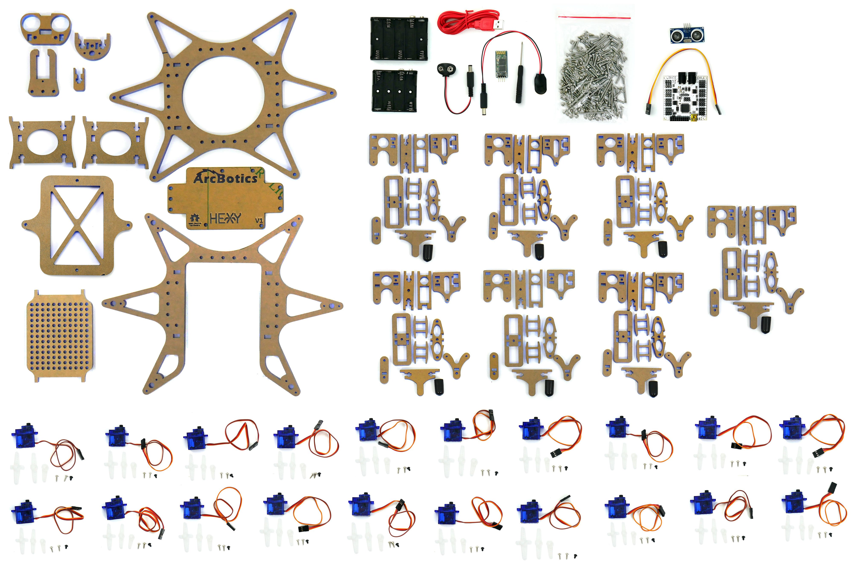
Организационно – экономическая часть/Hexy-5.jpg
