VovaRodger/Robo/Организационно – экономическая часть/табл2.png

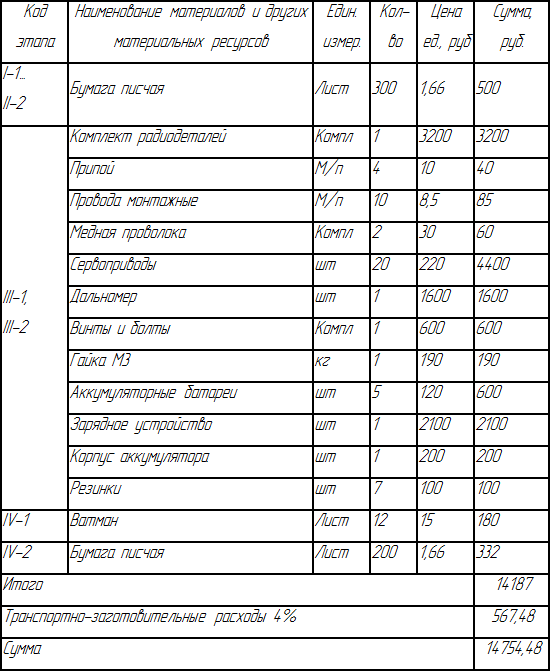
Организационно – экономическая часть/табл2.png
