VovaRodger/Robo/Организационно – экономическая часть/табл3.png

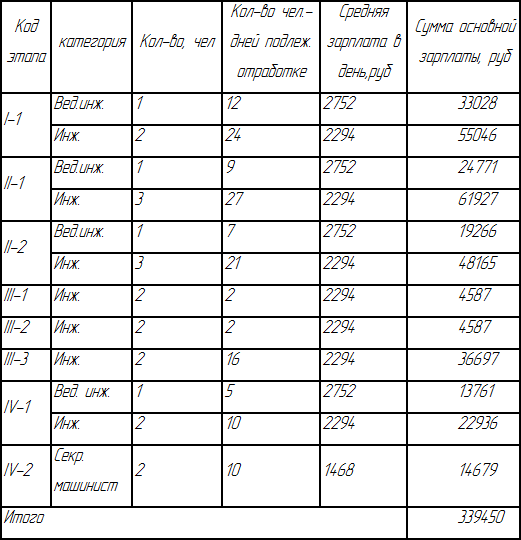
Организационно – экономическая часть/табл3.png
