VovaRodger/Robo/Организационно – экономическая часть/табл4.png

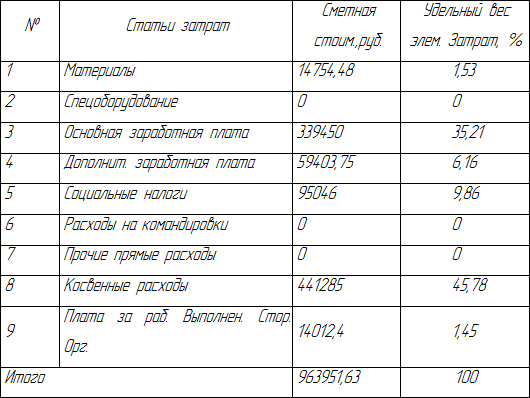
Организационно – экономическая часть/табл4.png
