VovaRodger/Robo/Охрана труда и экологии/схема.jpg

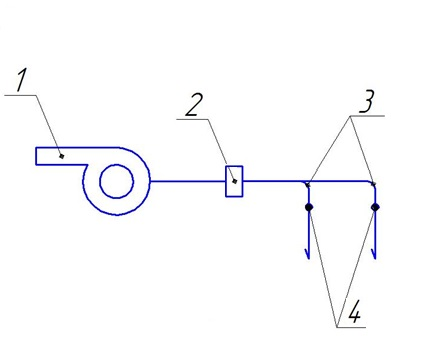
Охрана труда и экологии/схема.jpg
