VovaRodger/Robo/Технологическая часть/Сборочный чертеж.png

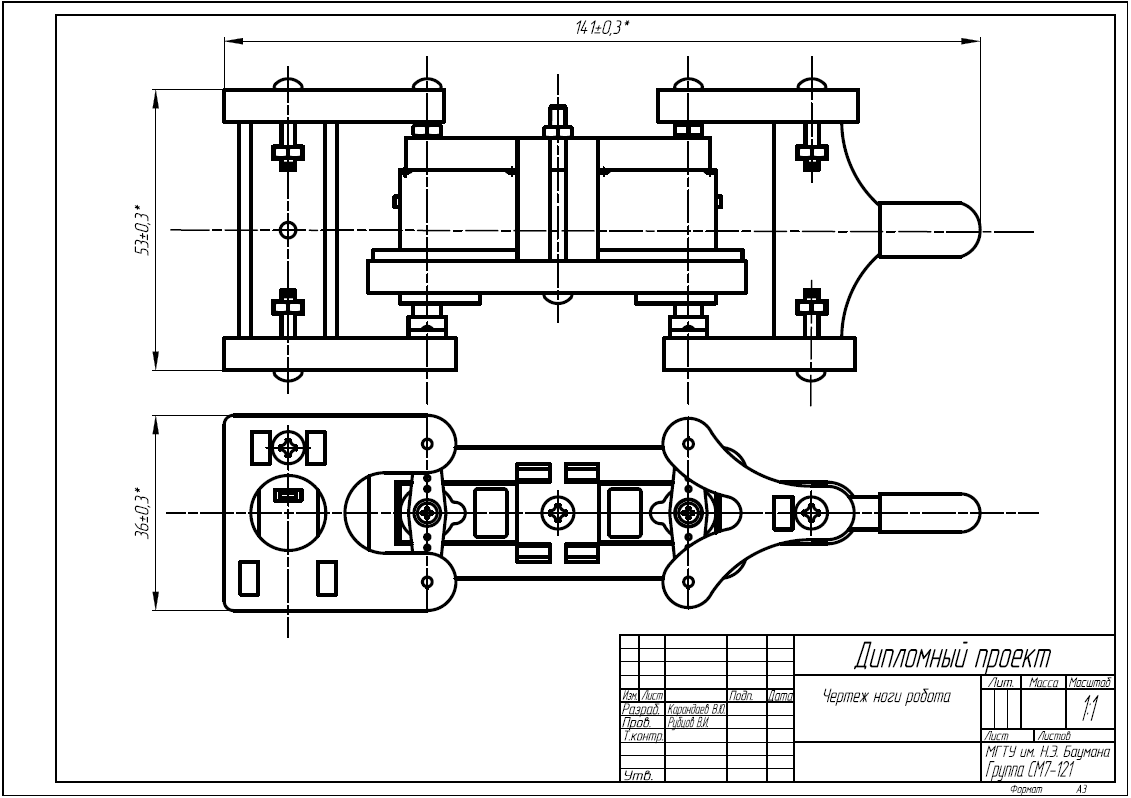
Технологическая часть/Сборочный чертеж.png
