VovaRodger/Robo/(list of files, cad)

Other CAD files:
Все чертежи.dwg
Научно-исследовательская часть/Синтез/Лачх.dwg
Организационно – экономическая часть/details.dwg
Охрана труда и экологии/room.dwg
Научно-исследовательская часть/Синтез/Лачх НЧ.dwg
