VovaRodger/Robo/Научно-исследовательская часть/Все чертежи-Model.pdf

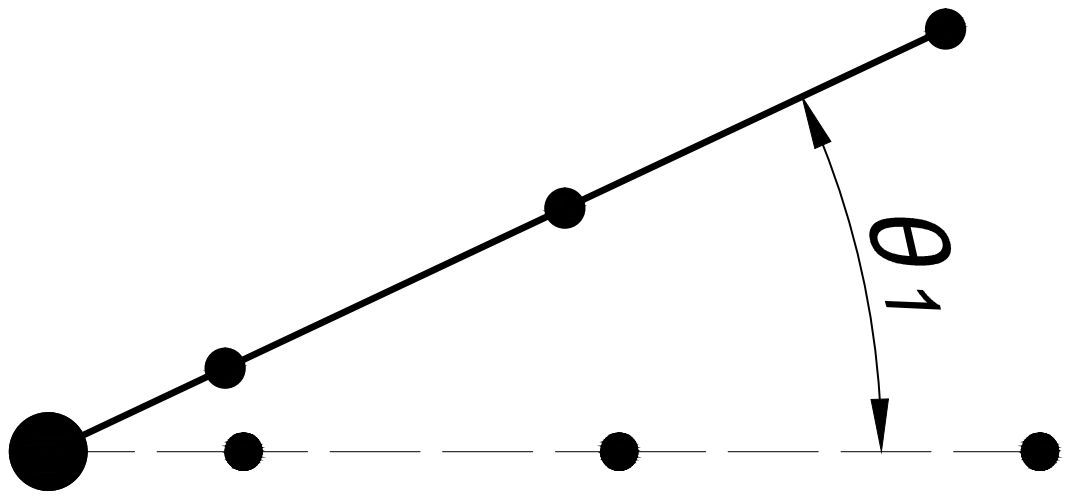
[picture p101: page 1]
