VovaRodger/Robo/Чертежи/Констр. часть.pdf

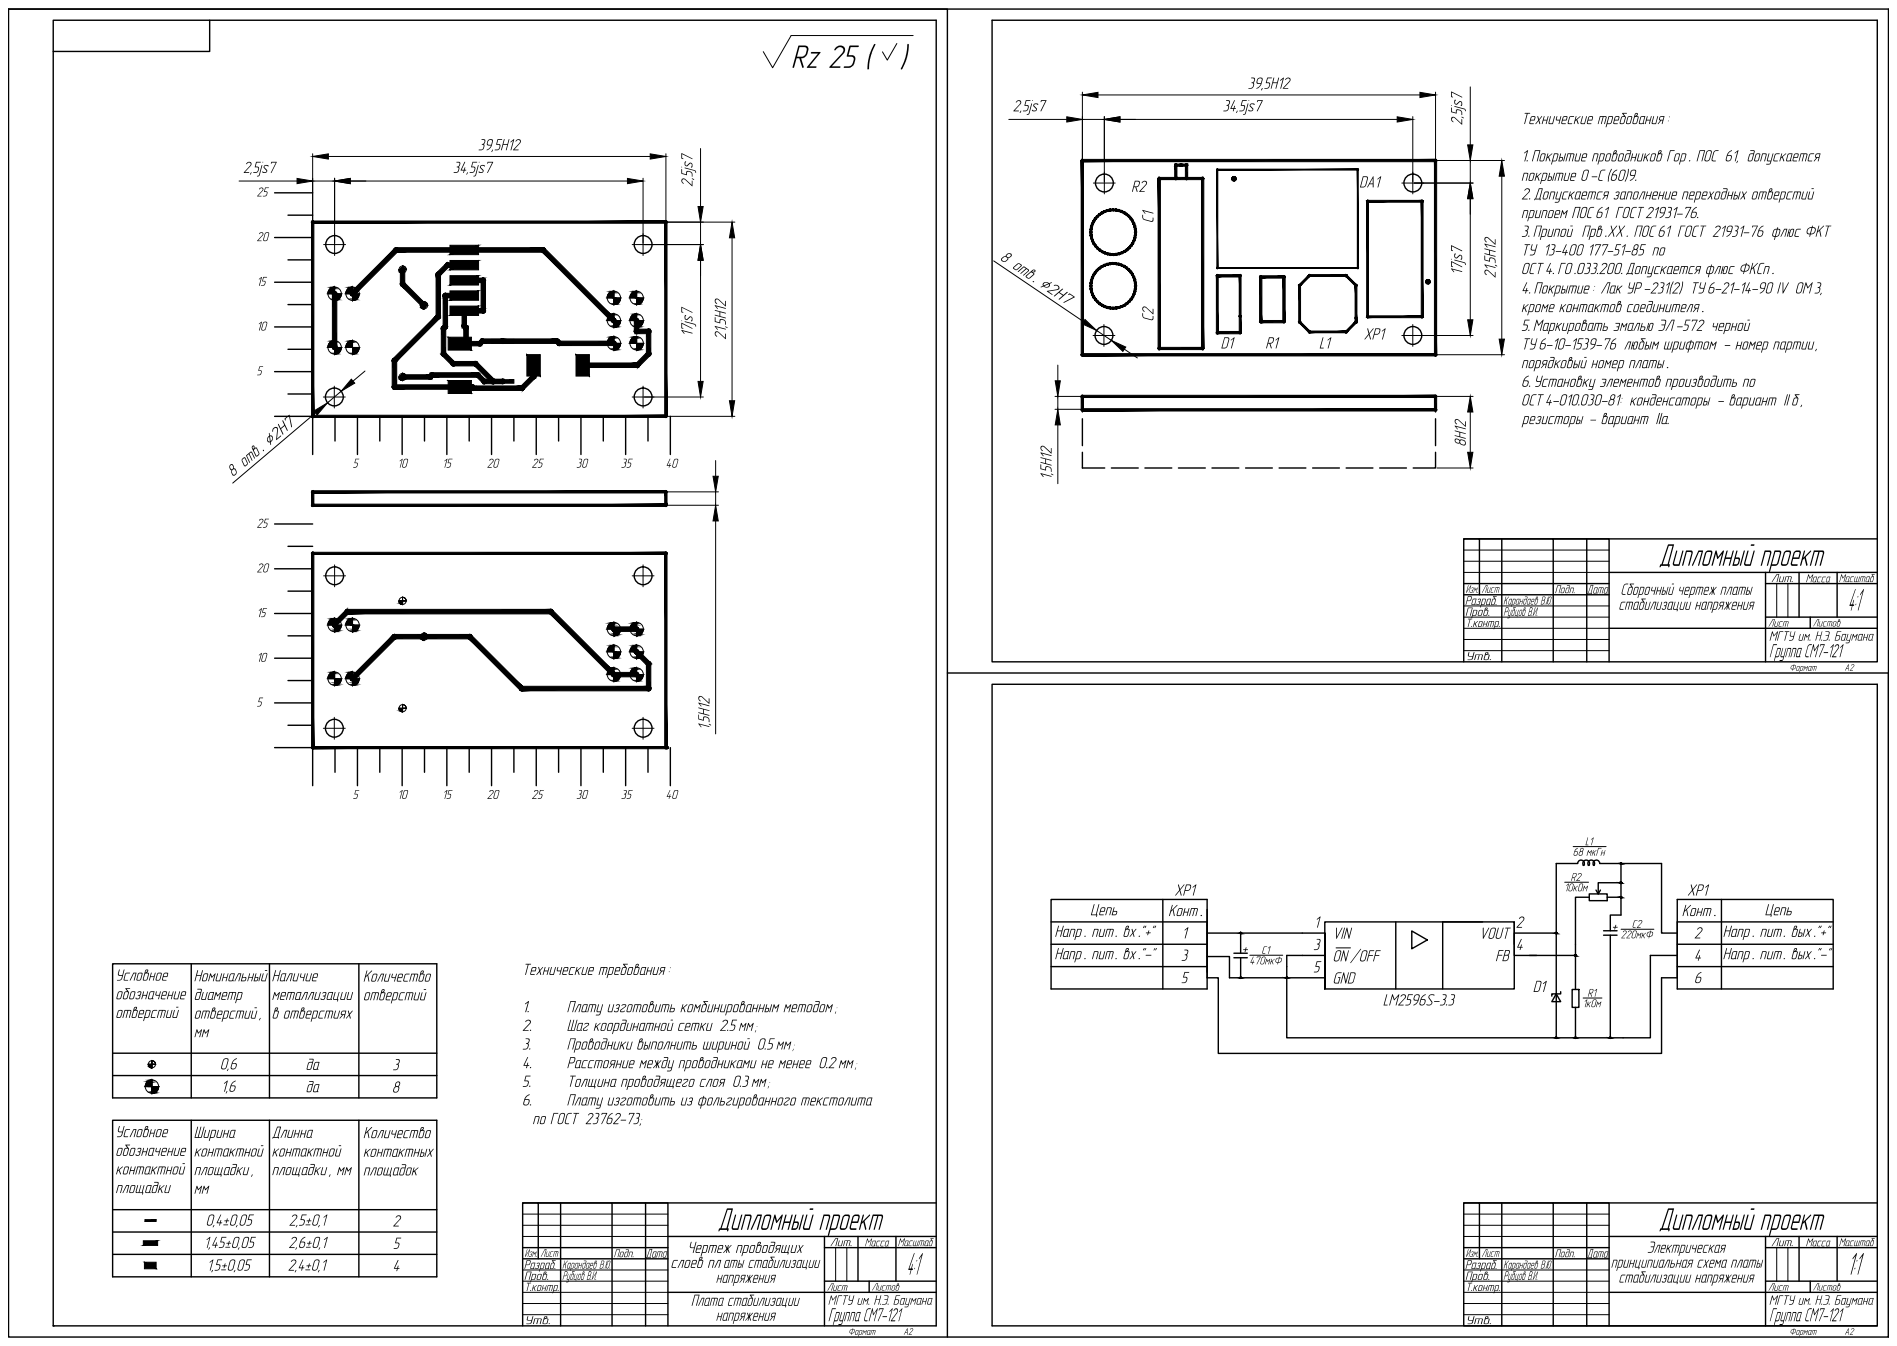
[picture p102: page 1]
