VovaRodger/Robo/Чертежи/Опер. технология.pdf

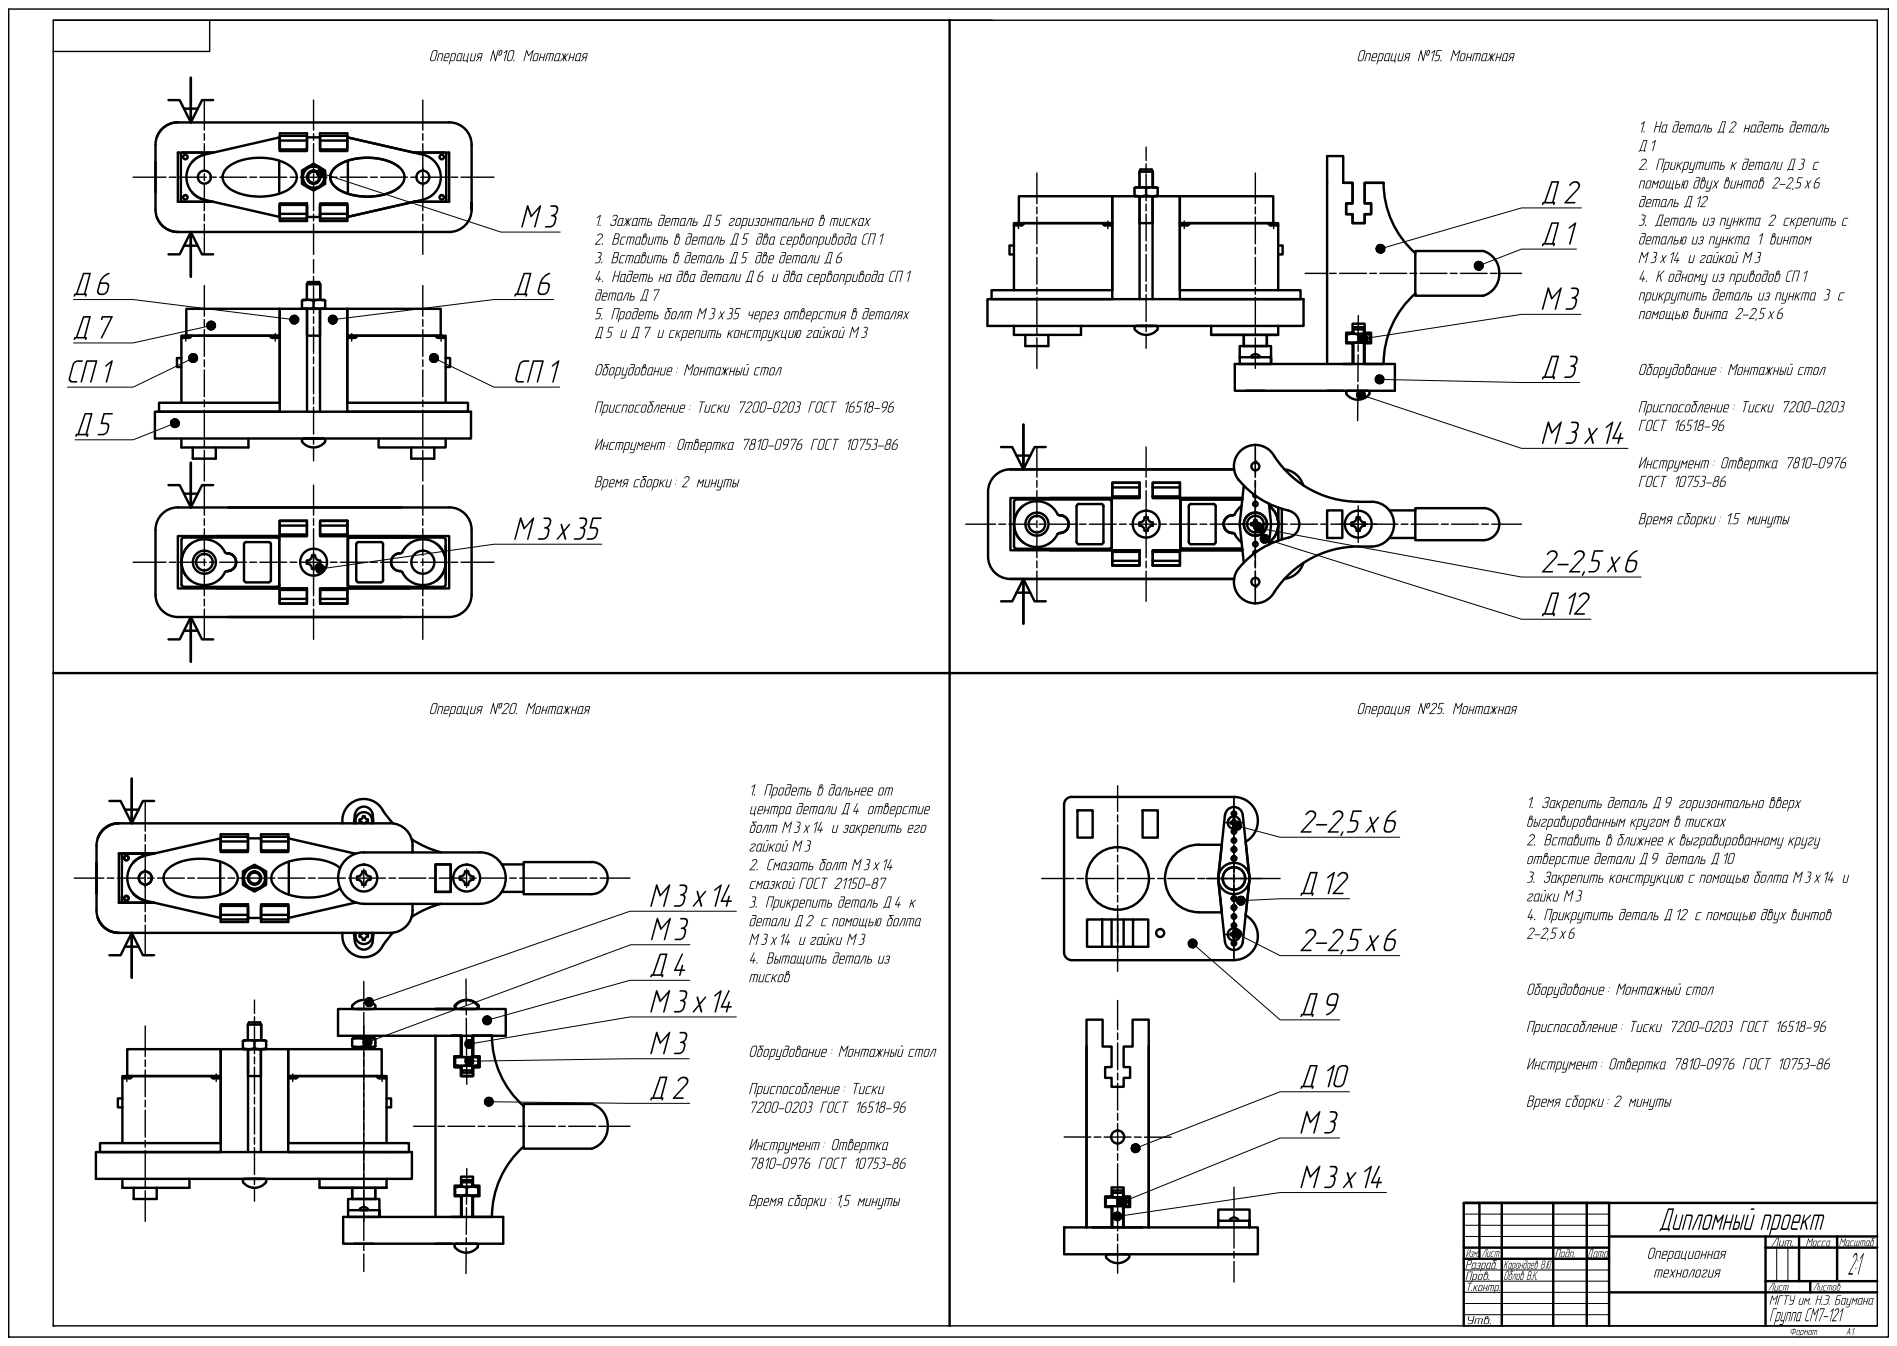
[picture p103: page 1]
