VovaRodger/Robo/Чертежи/Сборочный чертеж ноги.pdf

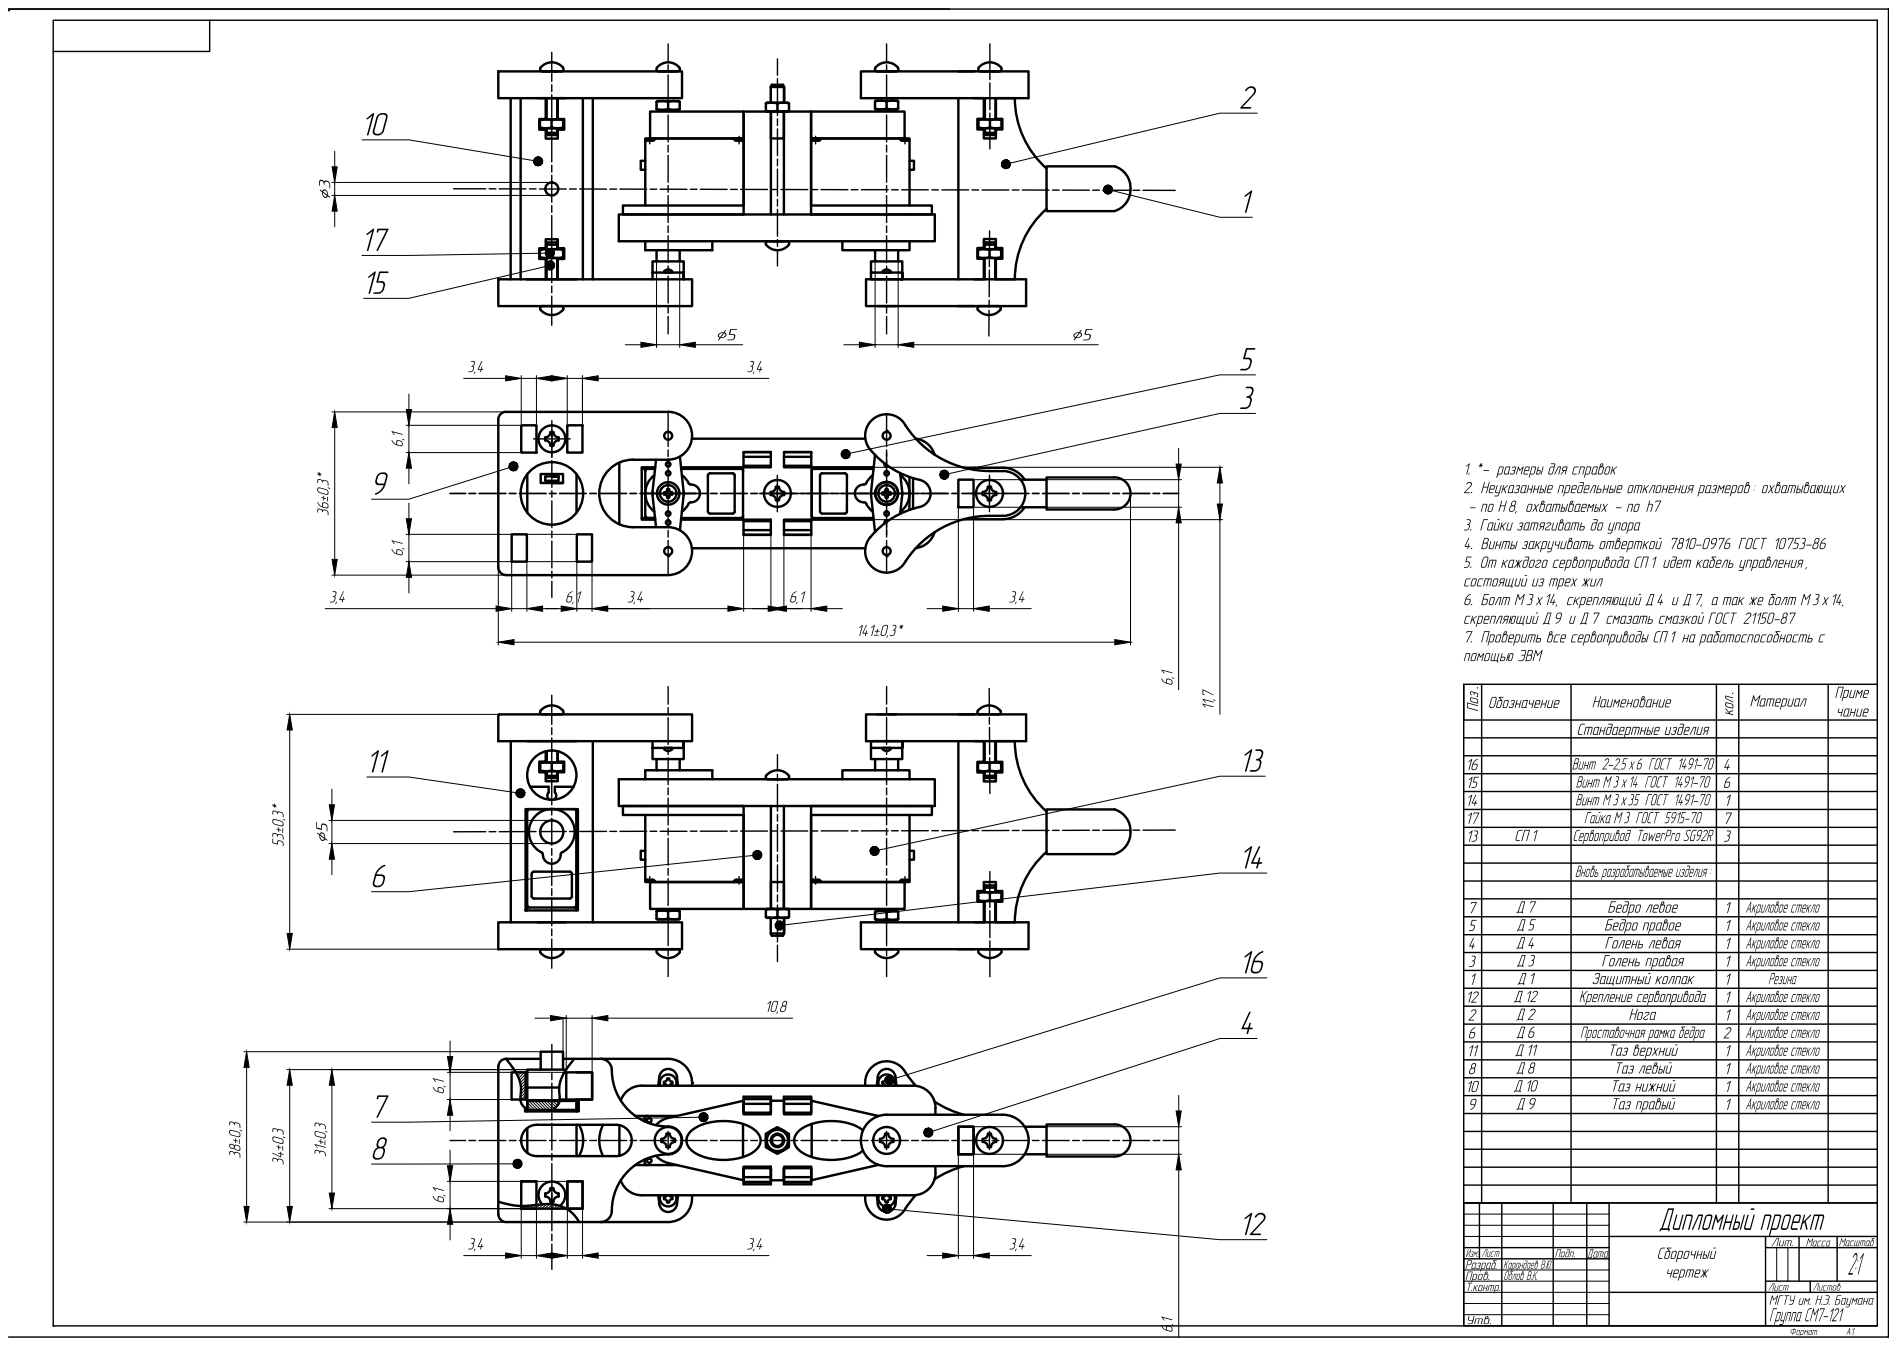
[picture p104: page 1]
