VovaRodger/Robo/Охрана труда и экологии/схема фильтрации.pdf

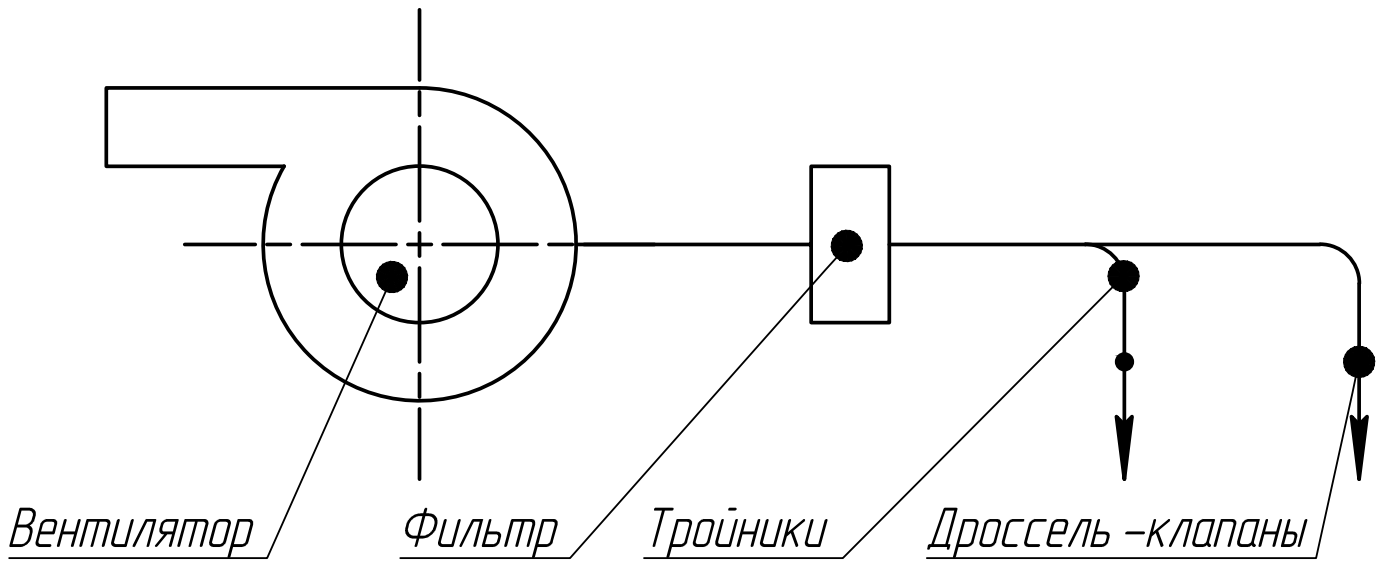
[picture p105: page 1]
