VovaRodger/Robo/Научно-исследовательская часть/Все чер2тежи-Model.pdf

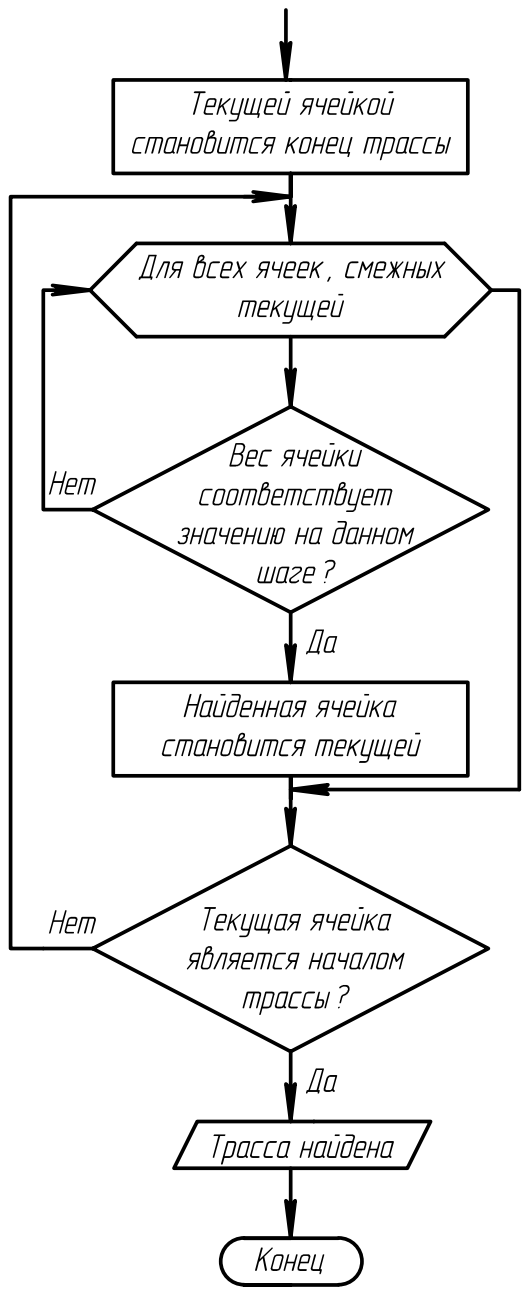
[picture p106: page 1]
