VovaRodger/Robo/Охрана труда и экологии/Схема освещенияl.pdf

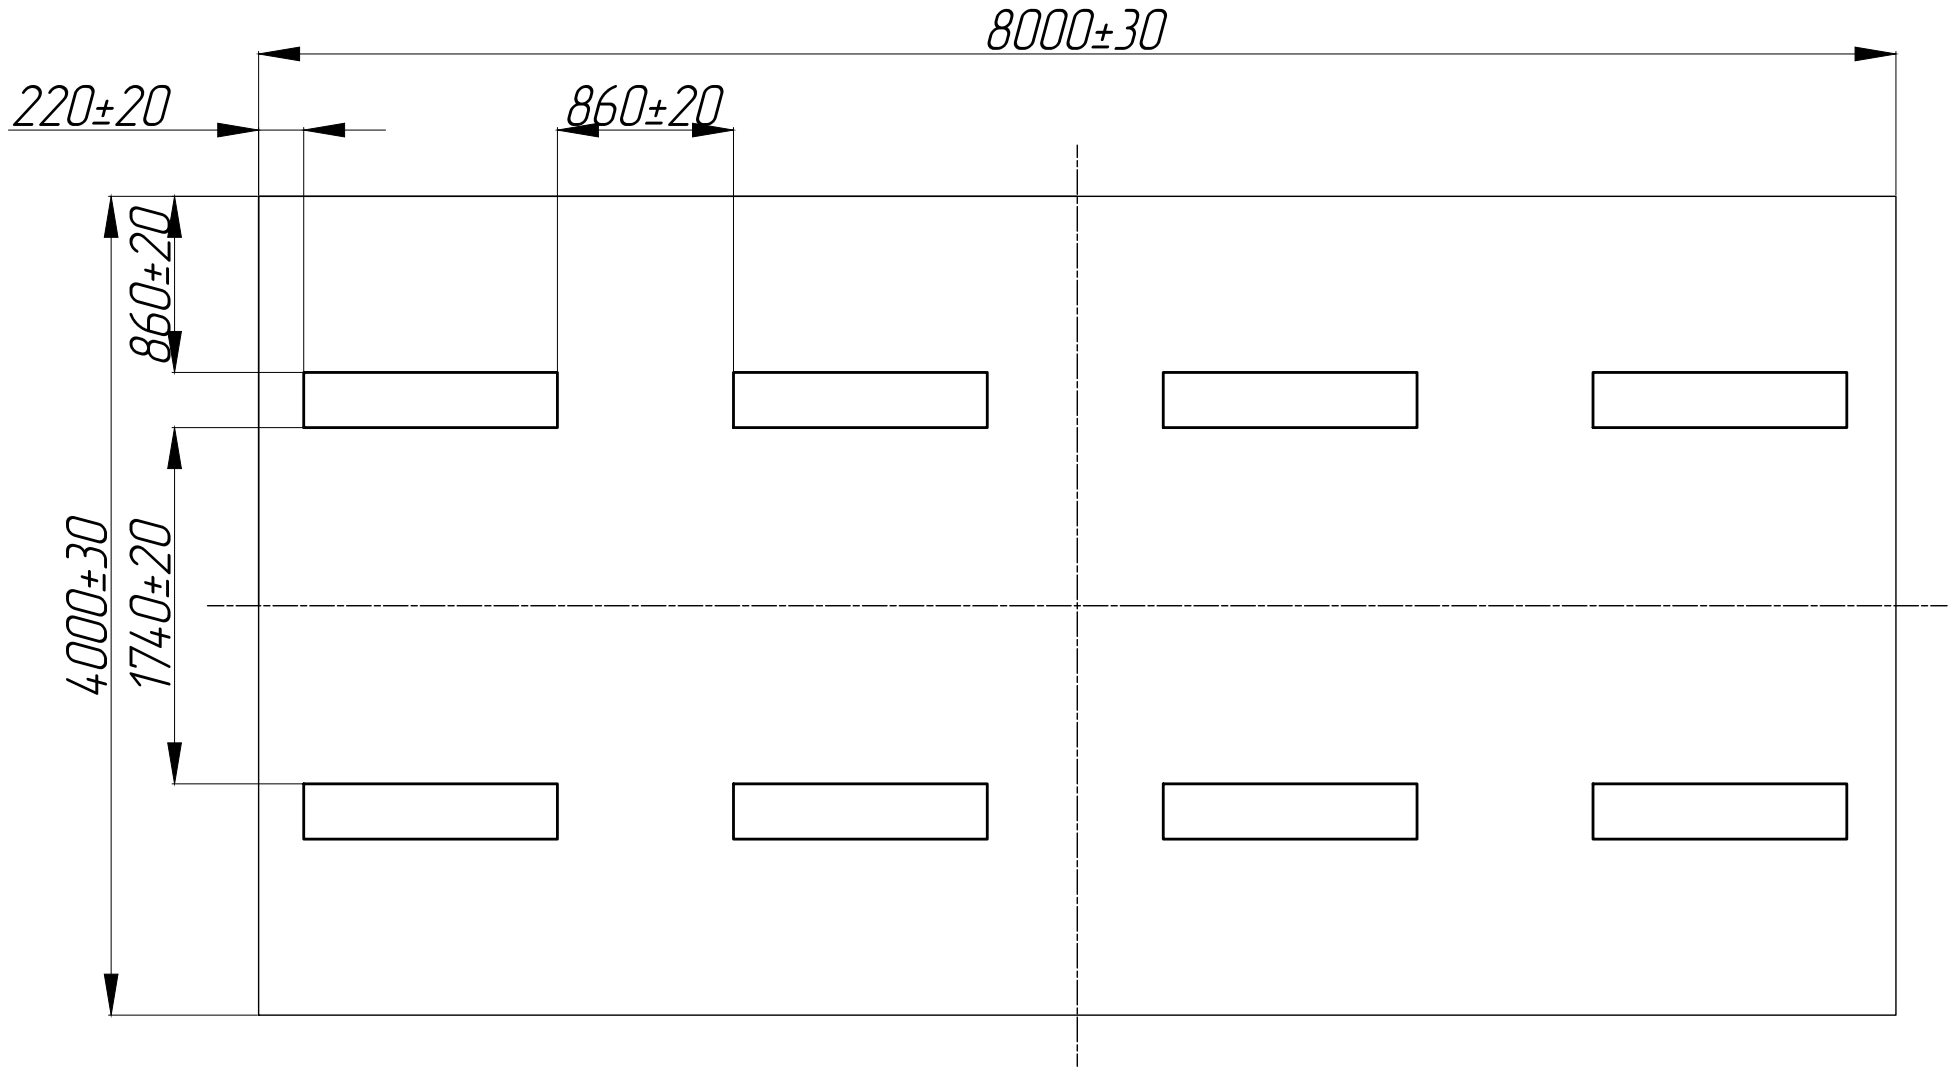
[picture p107: page 1]
