VovaRodger/Robo/Технологическая часть/Сборочный чертеж.pdf

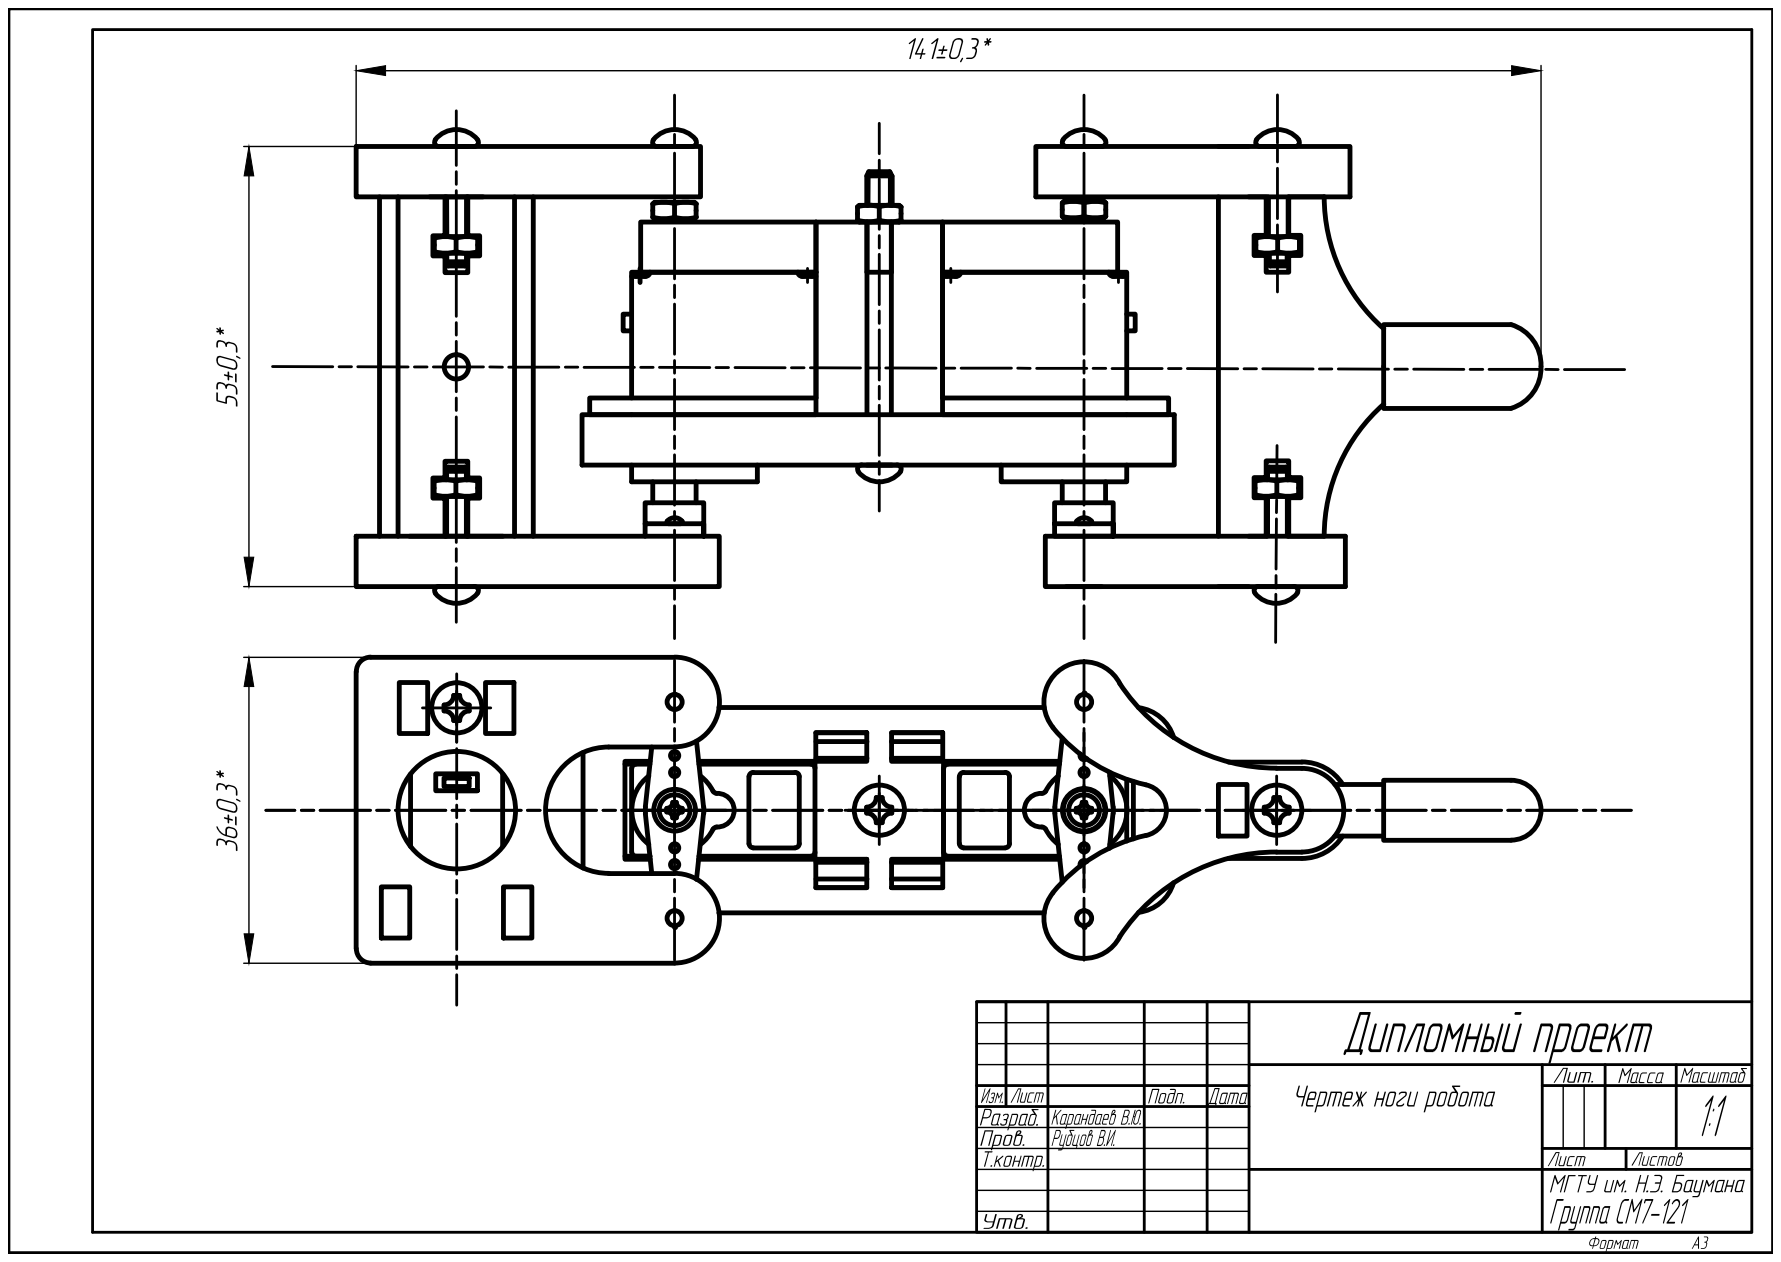
[picture p108: page 1]
