VovaRodger/Robo/Технологическая часть/схема сборкиl.pdf

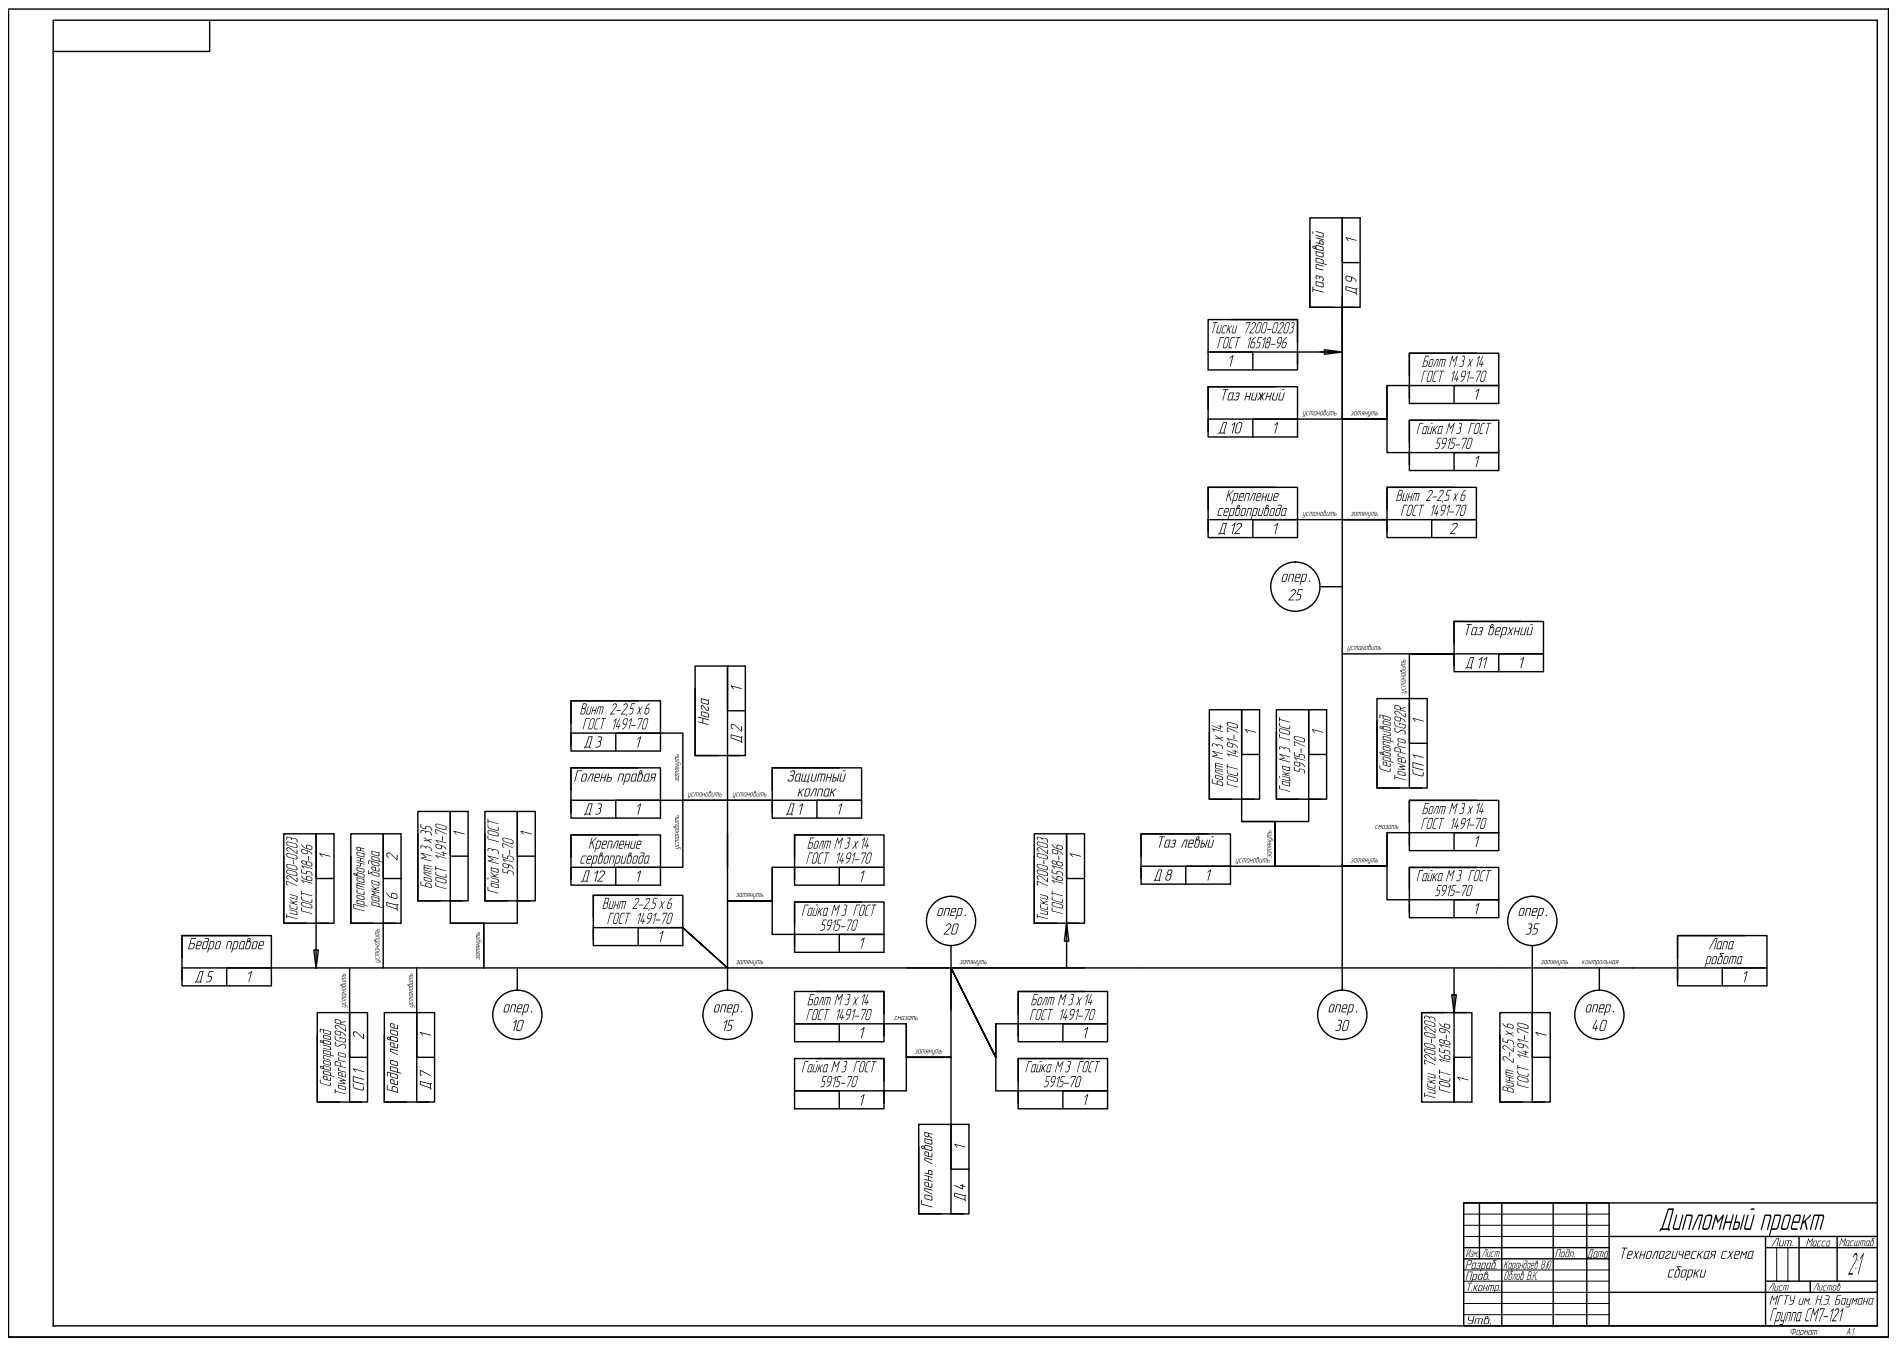
[picture p109: page 1]
