VovaRodger/Robo/Чертежи/КонстрА1.pdf

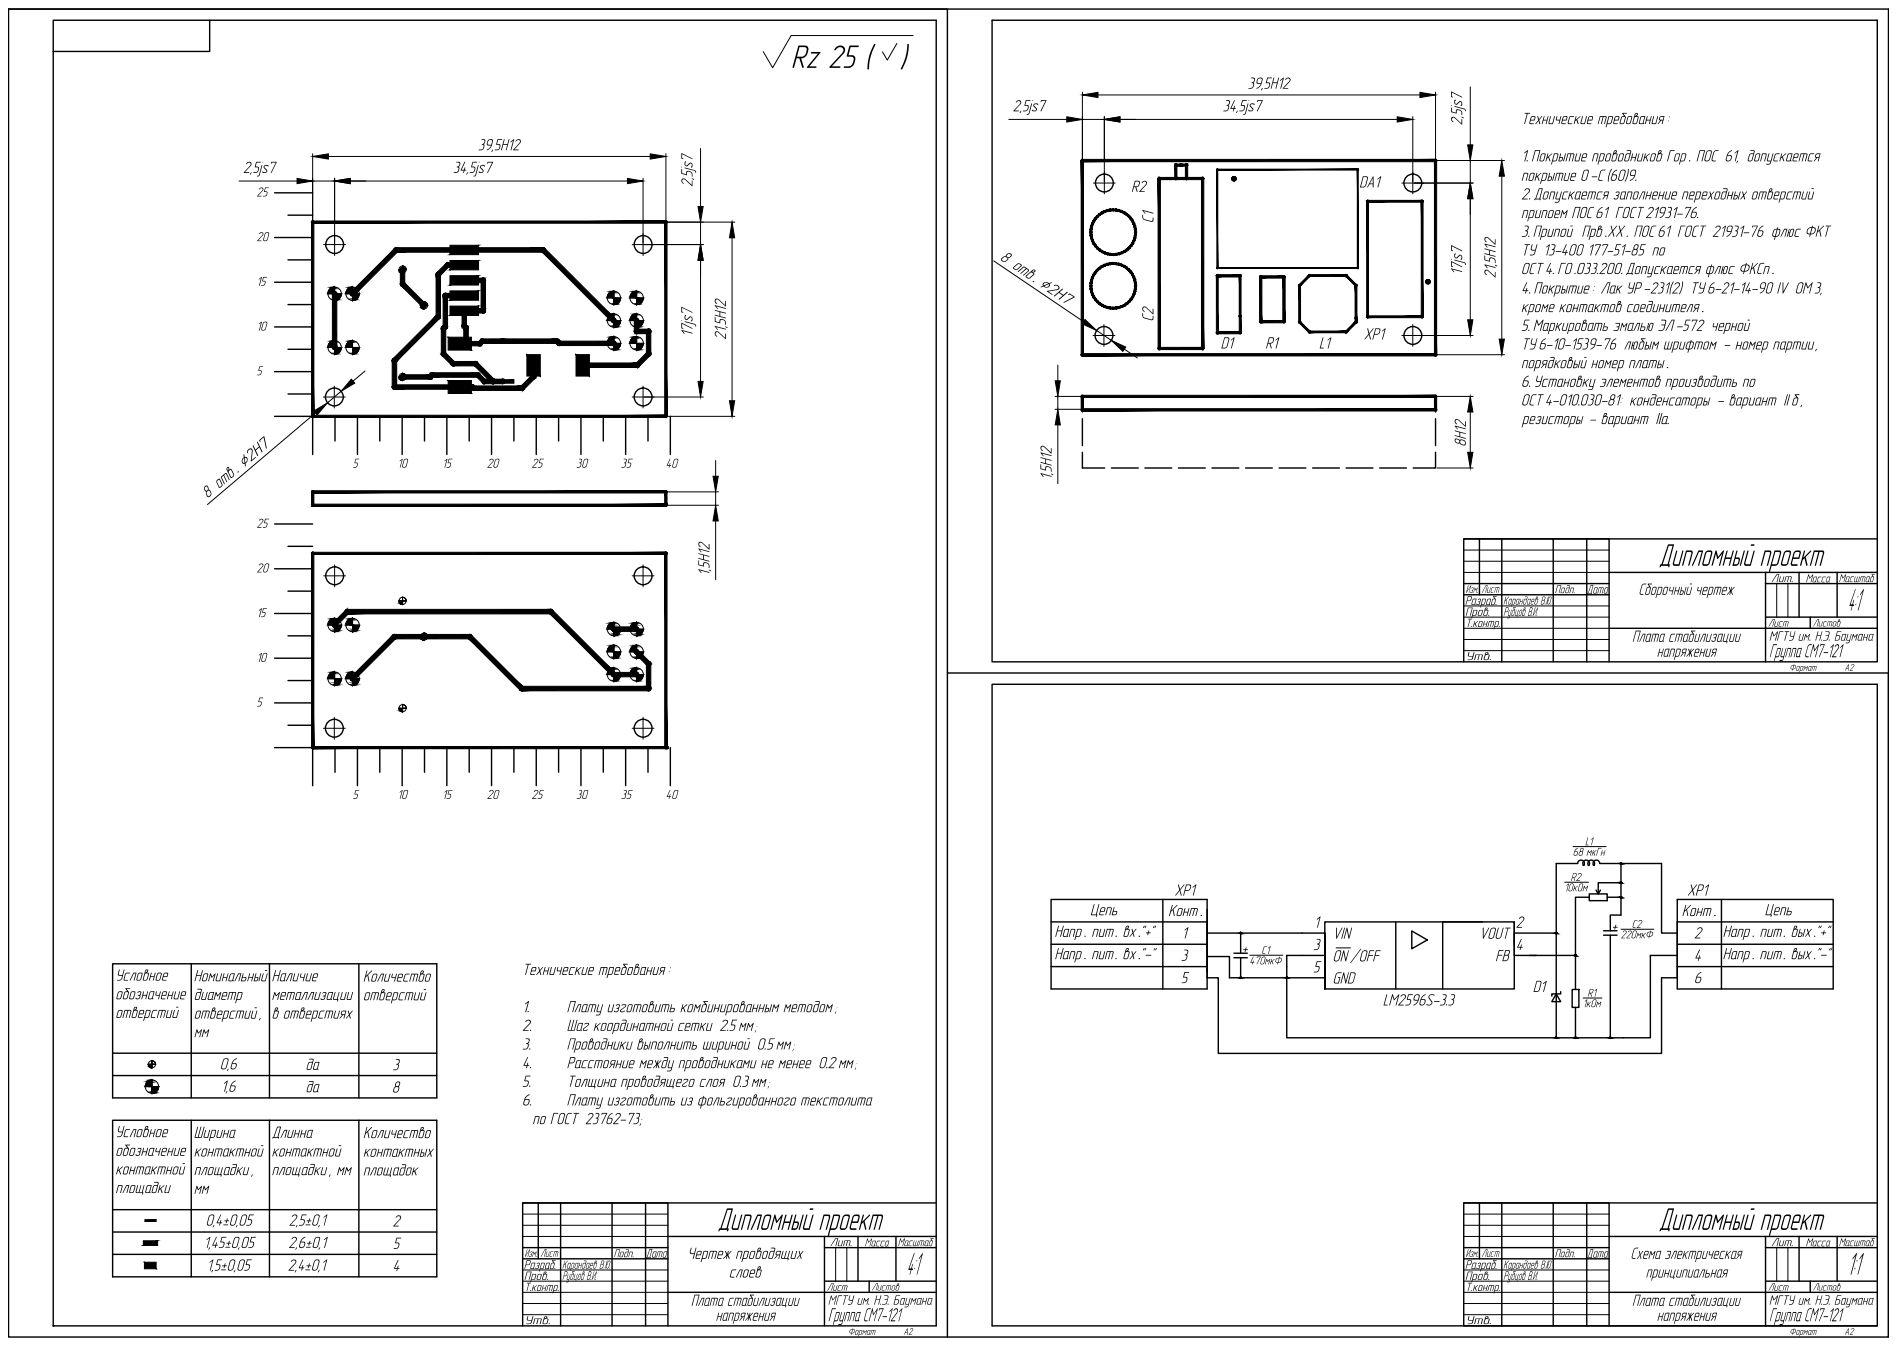
[picture p110: page 1]
