VovaRodger/Robo/Чертежи/КонстрА4_1.pdf

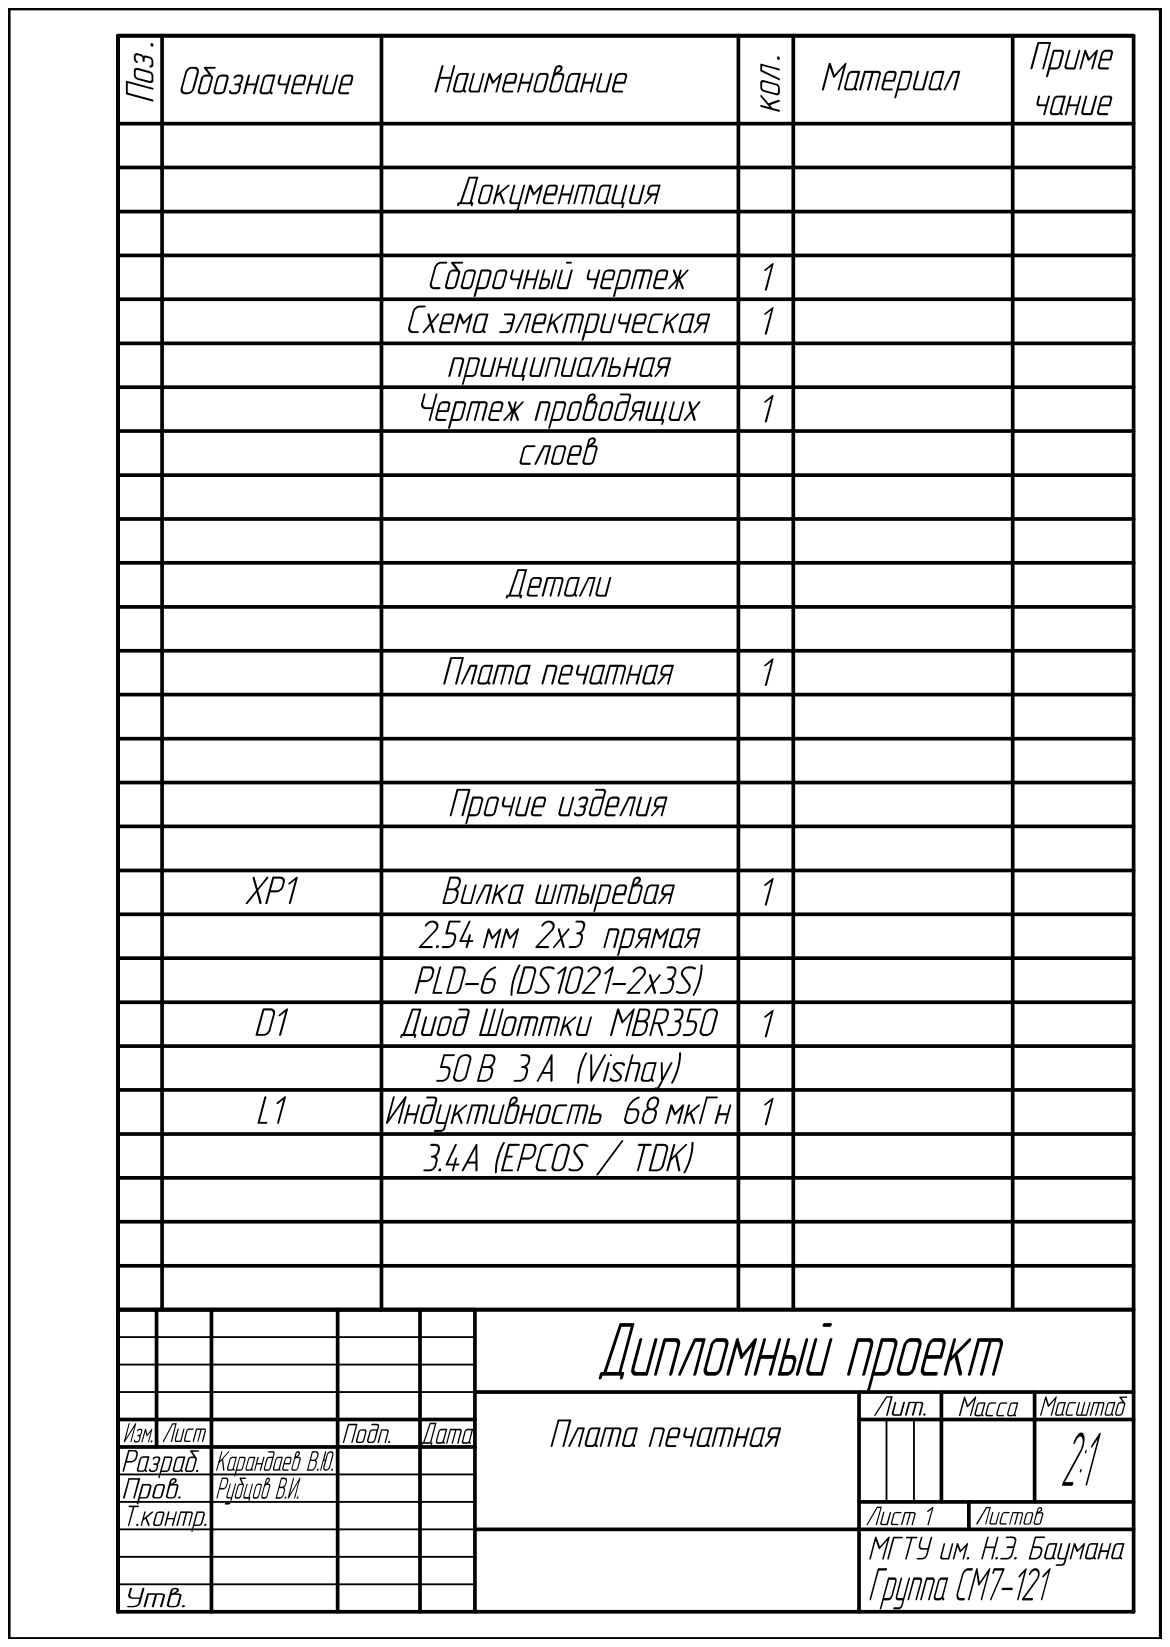
[picture p111: page 1]
