VovaRodger/Robo/Чертежи/КонстрА4_2.pdf

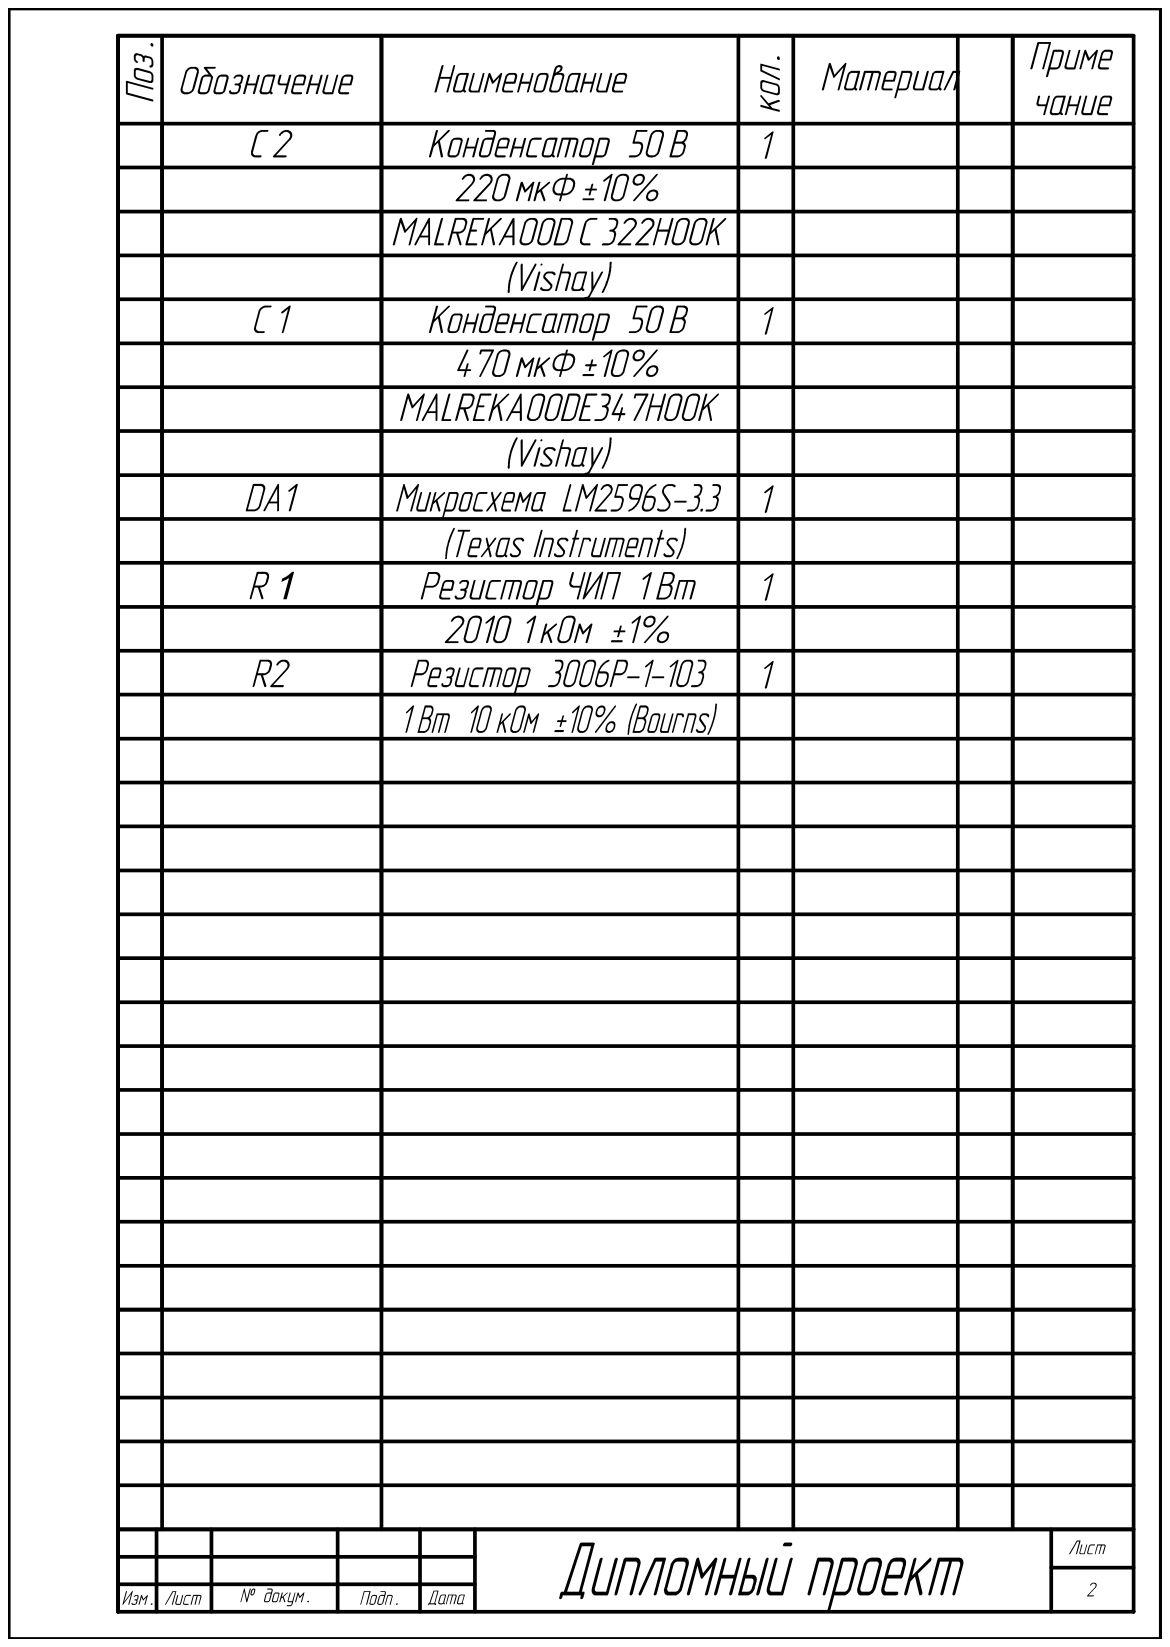
[picture p112: page 1]
