VovaRodger/Robo/Научно-исследовательская часть/Синтез/Лачх НЧ-Model.pdf

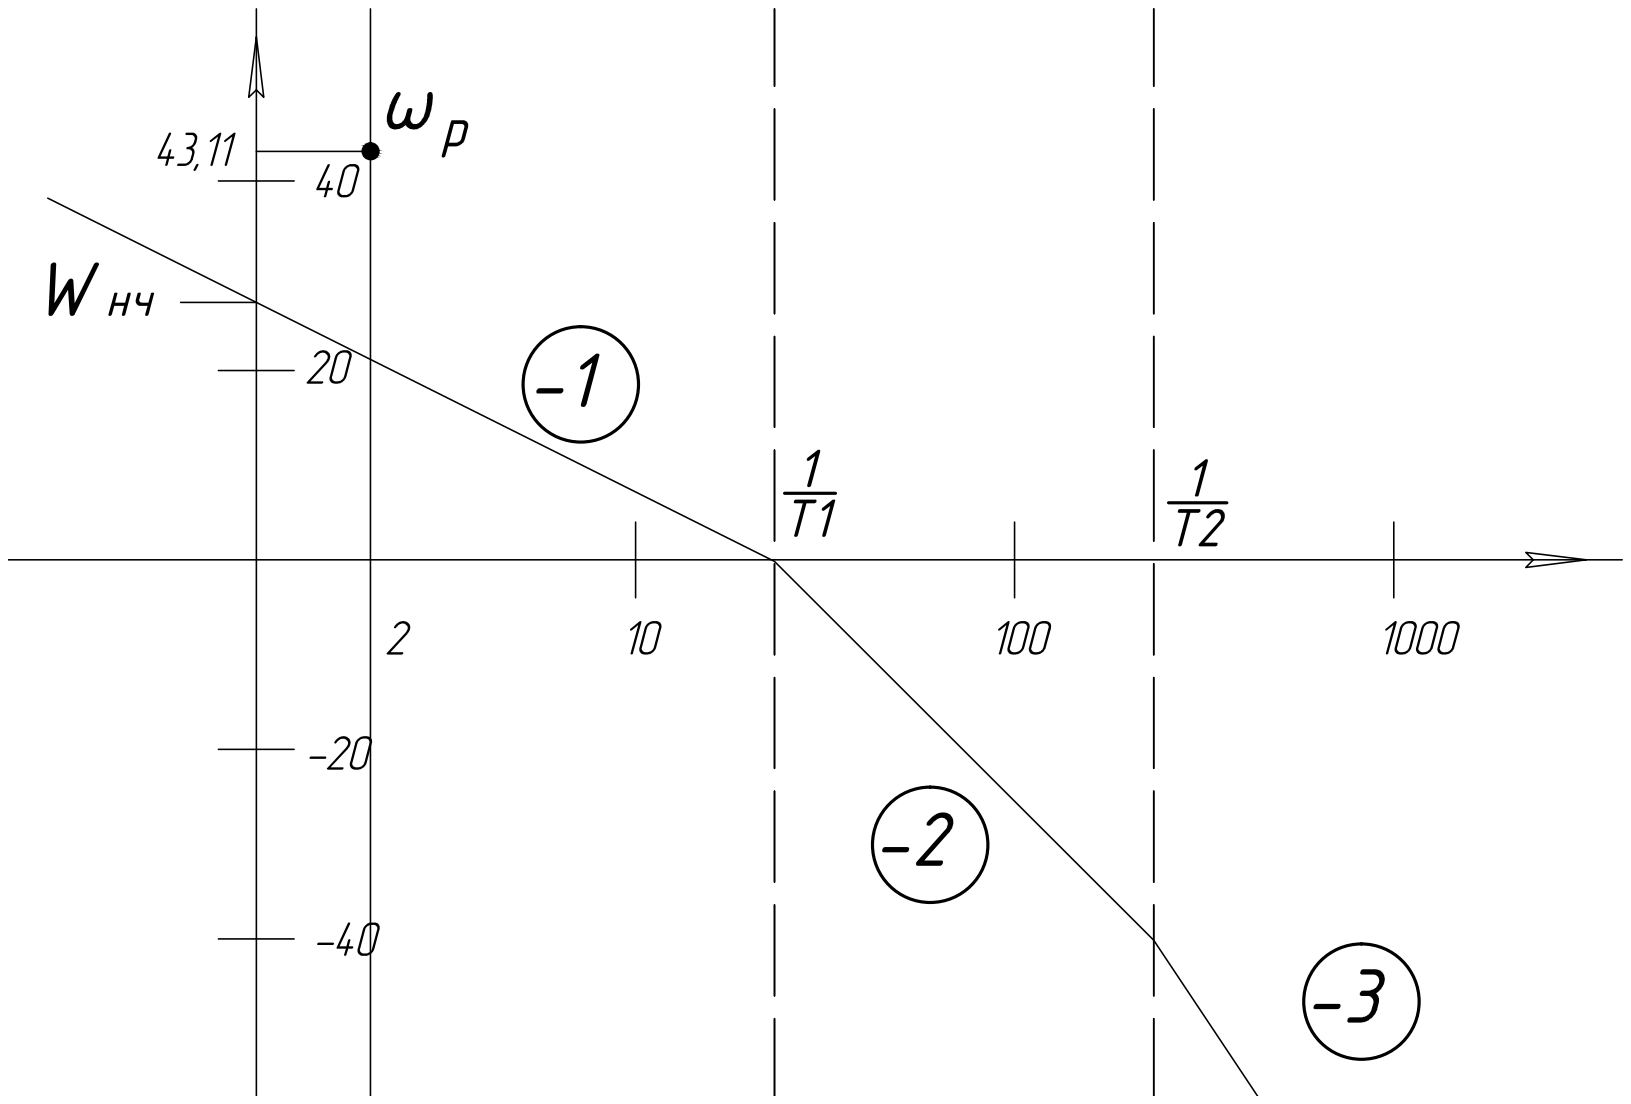
[picture p113: page 1]
