VovaRodger/Robo/Научно-исследовательская часть/Синтез/Лачх-Model.pdf

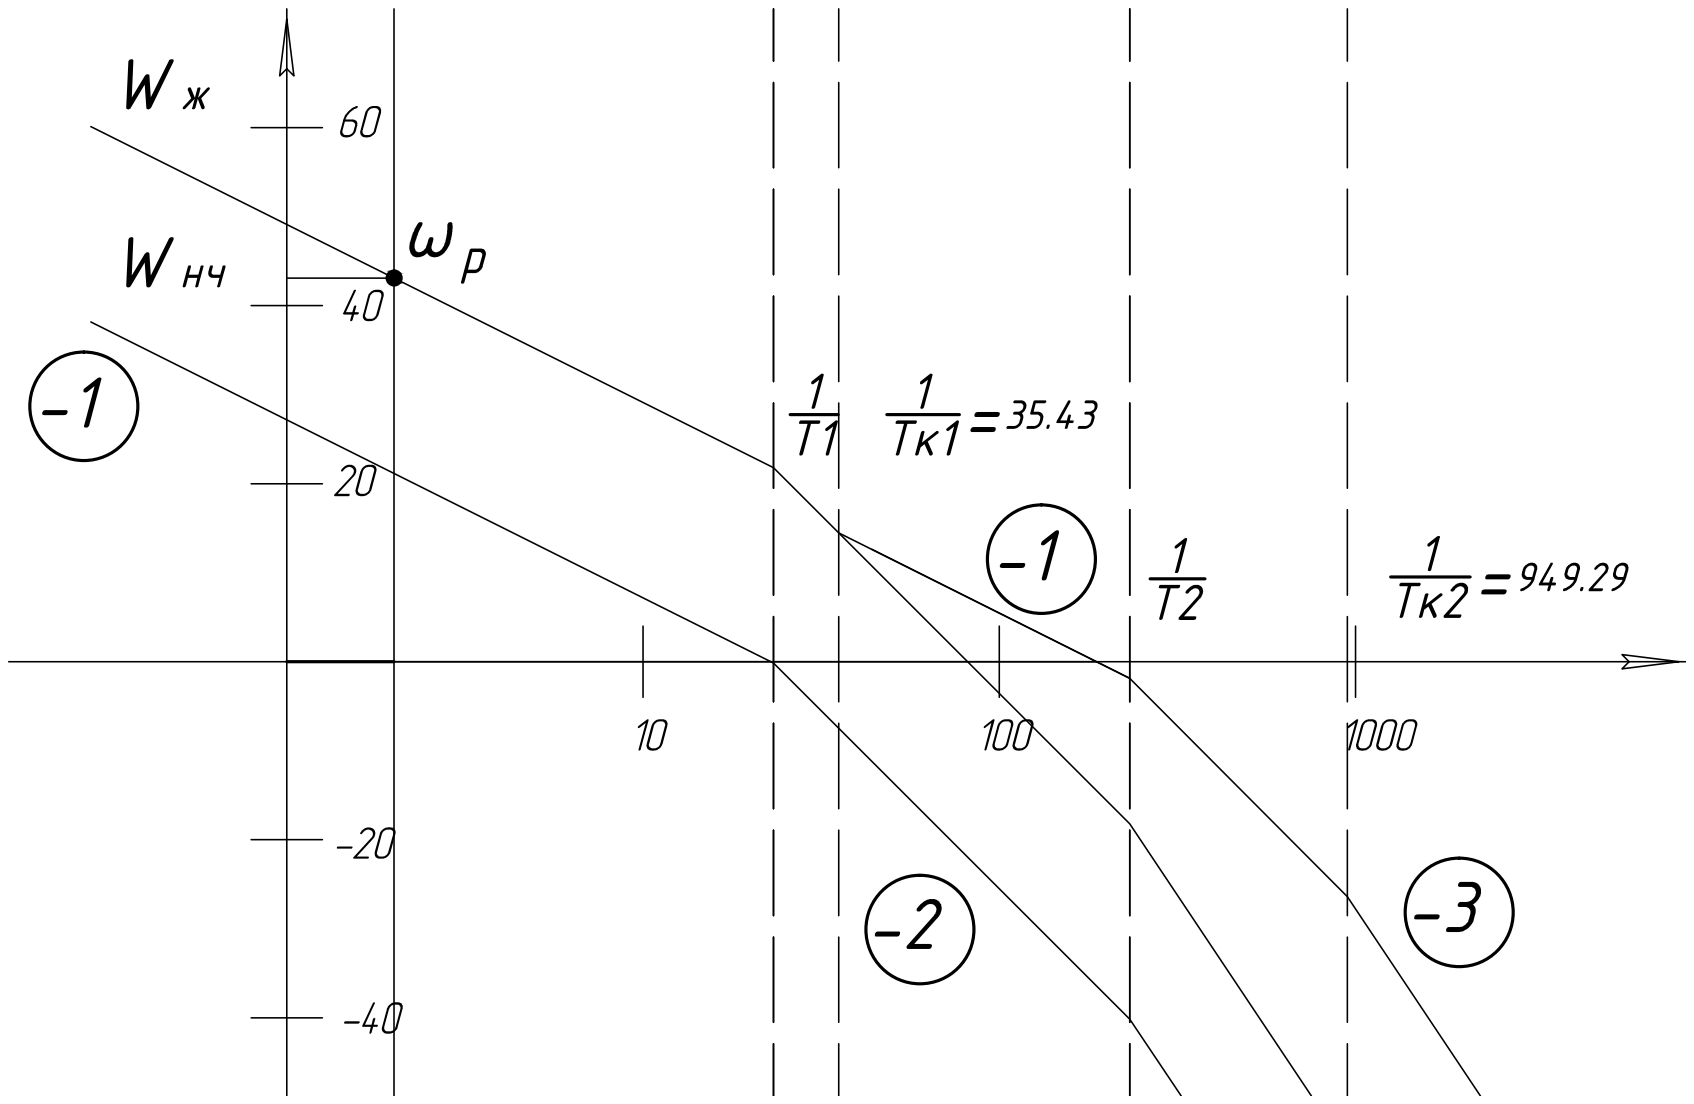
[picture p114: page 1]
