VovaRodger/Robo/(list of files, drawings)

Other design files:
Конструкторская часть/Плата/PCB1.PcbDoc
