VovaRodger/Robo/(commit log)

2016-05-24 Синхронизация с GitHub.com
    [details.dwg, room.dwg, Диаграмма.xls, Расчет зарплат.xlsx]
2016-05-24 Ненужное удалено
    [Диаграмма.xls]
2016-05-24 Добавил технологию
2016-05-26 Сборочнй чертеж
    [Сборочный чертеж.dwg]
2016-05-26 Добавлен 3 вид
    [Сборочный чертеж.dwg]
2016-05-28 Технология обновлена
    [Процесс сборки.dwg, Сборочный чертеж.dwg]
2016-05-28 Исправил таблицу
2016-05-28 Операционная технология
    [Операционная технология.dwg]
2016-05-28 Добавил чертежи
    [ОТ_ПС_СЧ.dwg]
2016-05-31 Вторая правка
2016-05-31 Исправил
    [Все чертежи.dwg]
2016-06-05 Исследовательская допилена
    [Все чертежи.dwg]
2016-06-09 добавил конструторскую часть
    [Все чертежи.dwg]
2016-06-09 Чистка прошла
    [PCB1.PcbDoc, Лачх НЧ.dwg, Лачх.dwg, ОТ_ПС_СЧ.dwg, Операционная технология.dwg, Процесс сборки.dwg, Сборочный чертеж.dwg]
2016-06-09 Исправления в РПЗ
2016-06-09 Исправил оглавнления
    [details.dwg, room.dwg, Расчет зарплат.xlsx]
2016-06-09 Исправил заголовки
    [details.dwg, room.dwg, Расчет зарплат.xlsx]
2016-06-10 добавил листы
    [Все чертежи.dwg]
2016-06-11 Перед предзащитой
    [Все чертежи.dwg]
2016-06-12 Презентация
    [Все чертежи.dwg]
2016-06-12 Рецензия
2016-06-13 Доклад
    [Все чертежи.dwg]
2016-06-16 После предзащиты
    [Все чертежи.dwg, Лачх НЧ.dwg, Лачх.dwg]
2016-06-21 Диплом Сдан
